neecrobot/smallbot/SmallBot_P01.pdf

# ロボットプログラミング

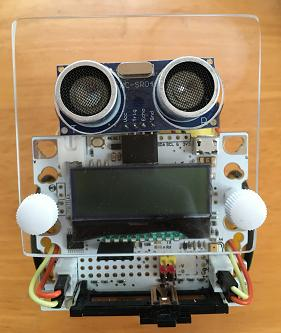
[picture p1: figure]

## SmallBotを動かそう

# SmallBotについて

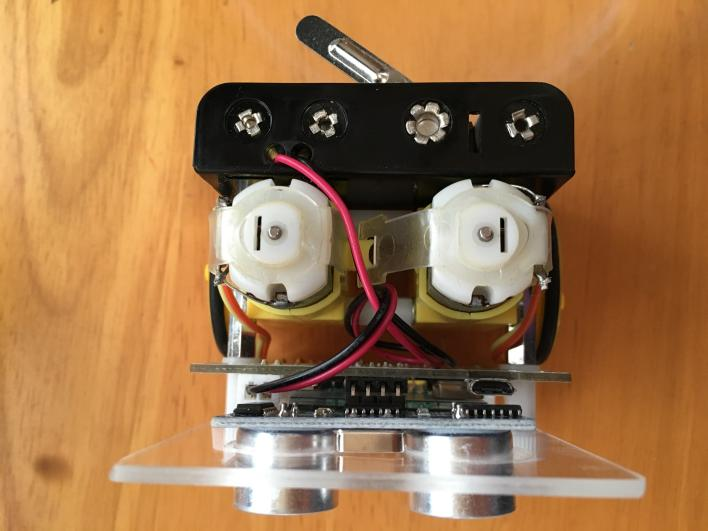
[picture p2: figure]

## マニュアルやプログラム類は githubに置いてあります

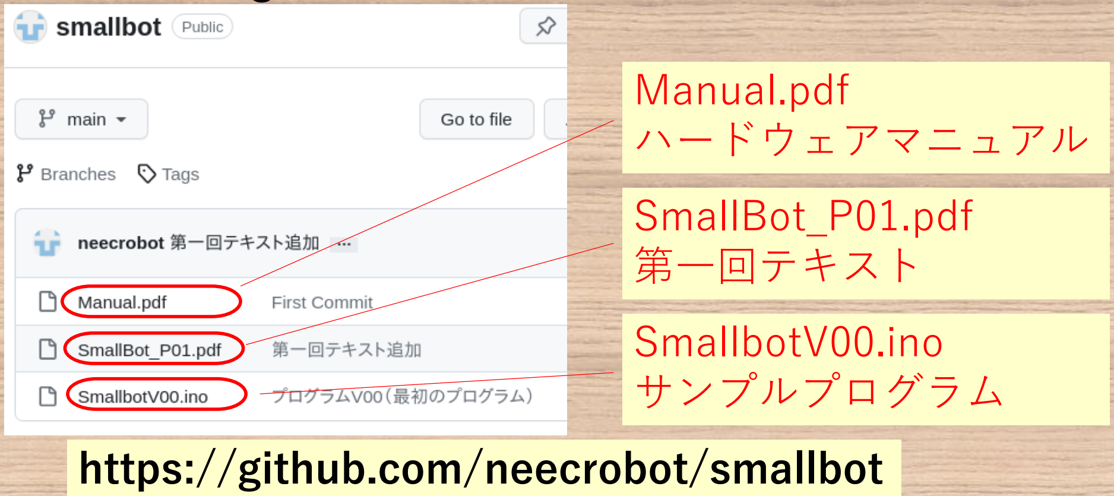
[picture p3: figure]
https://github.com/neecrobot/smallbot; Manual.pdf ハードウェアマニュアル; SmallBot_P01.pdf 第一回テキスト; SmallbotV00.ino サンプルプログラム

# SmallBotの主要部品配置

## 超音波距離センサ

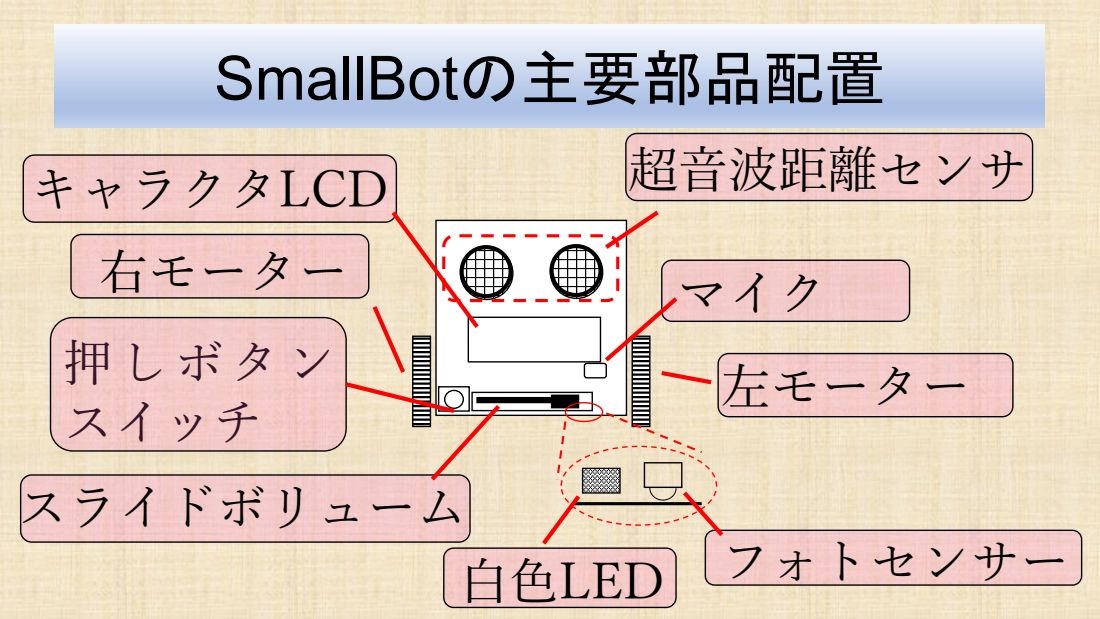
[picture p4: page 4]
フォトセンサー; 右モーター; 左モーター; マイク; スライドボリューム; 押しボタン スイッチ; 白色LED; キャラクタLCD

# 入力信号の接続（参考）

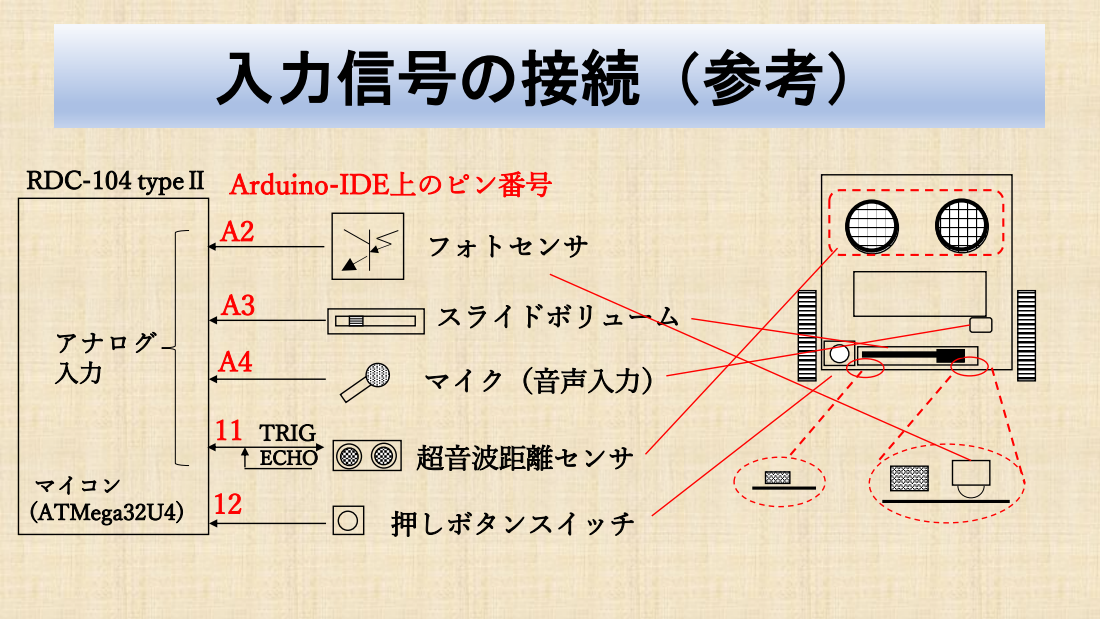
[picture p5: page 5]
フォトセンサ; RDC-104 typeⅡ; スライドボリューム; アナログ; マイク（音声入力）; 超音波距離センサ; 押しボタンスイッチ; マイコン (ATMega32U4); Arduino-IDE上のピン番号; TRIG ECHO

# 出力信号の接続（参考）

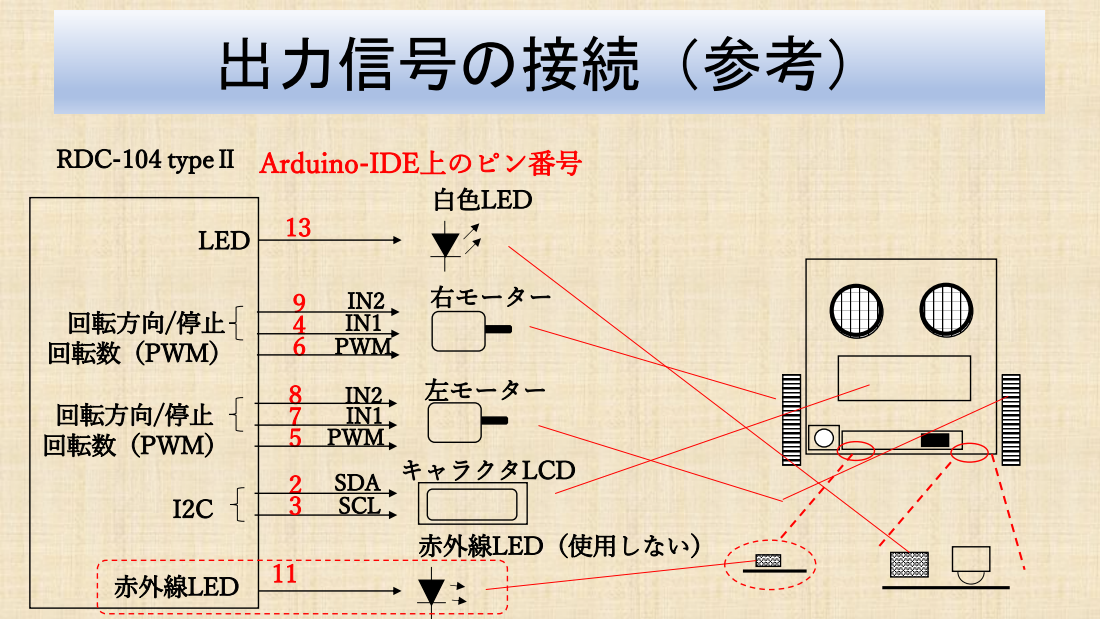
[picture p6: page 6]
回転数（PWM）; 回転方向/停止; 左モーター; SDA SCL; PWM; キャラクタLCD; 右モーター; 白色LED; LED; 赤外線LED（使用しない）; 赤外線LED

RDC-104 typeⅡ Arduino-IDE上のピン番号

### SmallBot搭載マイコン用(RDC-104)の開発環境

## インストール

### SmallBot搭載マイコン用(RDC-104)の開発環境

## インストール

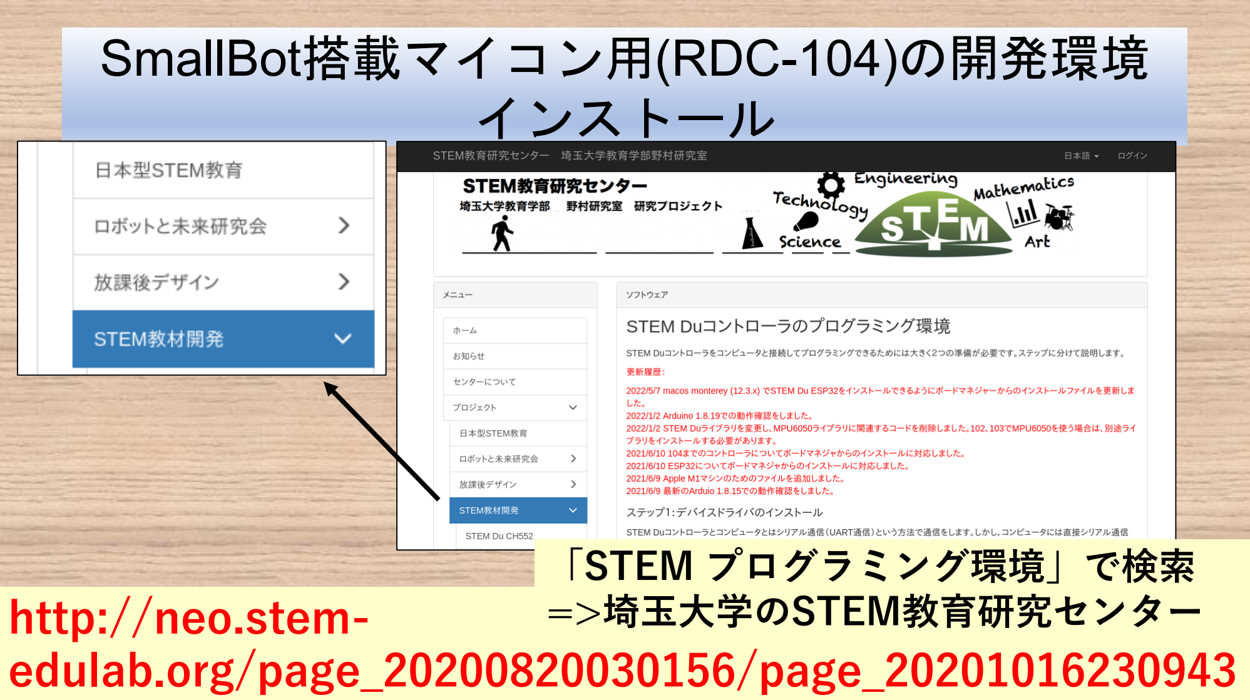
[picture p7: page 8]

http://neo.stem-edulab.org/page_20200820030156/page_20201016230943

「STEM プログラミング環境」で検索
=>埼玉大学のSTEM教育研究センター

# Arduino 1.8.19をインストール

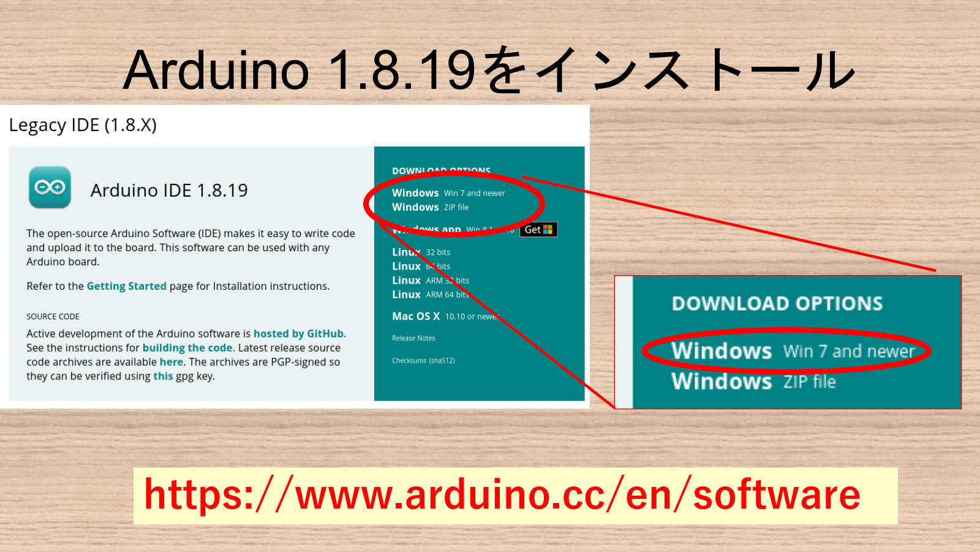
[picture p8: page 9]

## https://www.arduino.cc/en/software

# Arduino IDEの起動

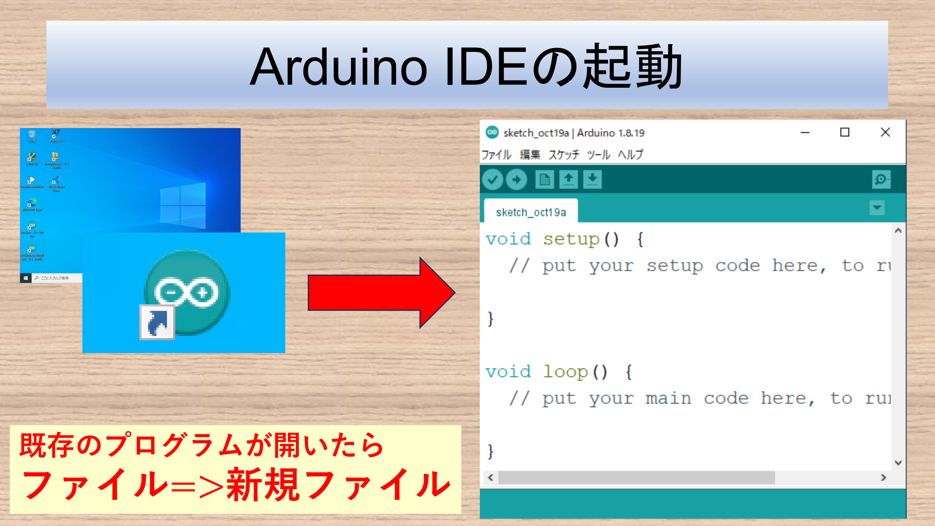
[picture p9: page 10]

既存のプログラムが開いたら

## ファイル=>新規ファイル

# ボードマネージャのURLをコピー

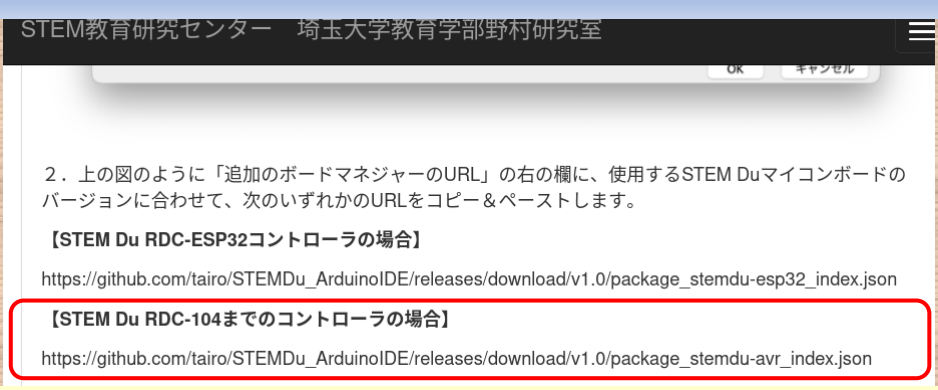
[picture p10: figure]

https://github.com/tairo/STEMDu_ArduinoIDE/releases/download/v1.0/package_stemdu-avr_index.json

# ボード（RDC-104）の追加

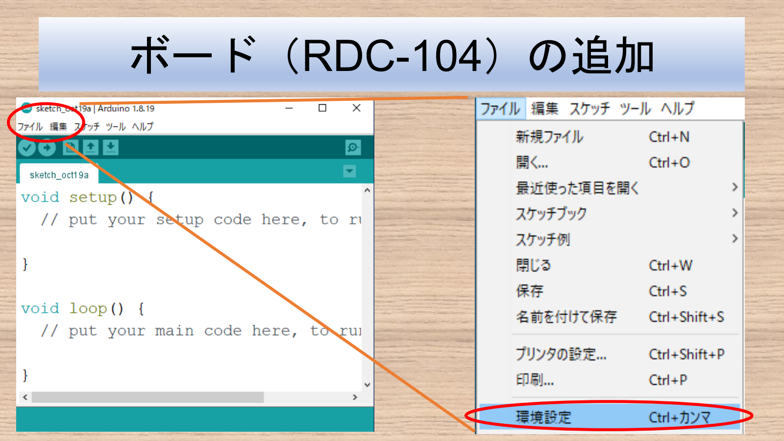
[picture p11: page 12]

# ボードマネージャのURL追加

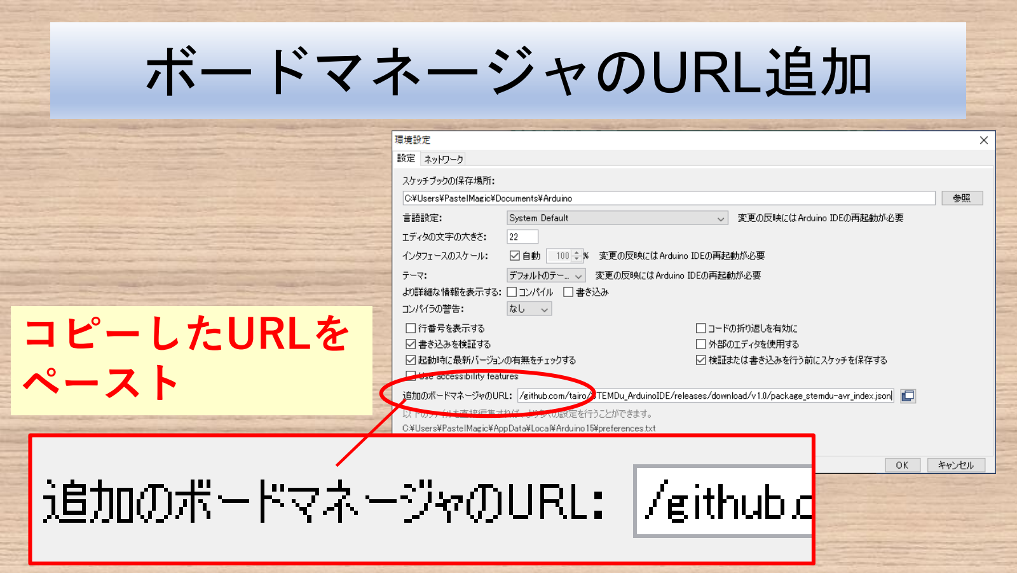
[picture p12: page 13]

## コピーしたURLを ペースト

# ボードマネージャを起動

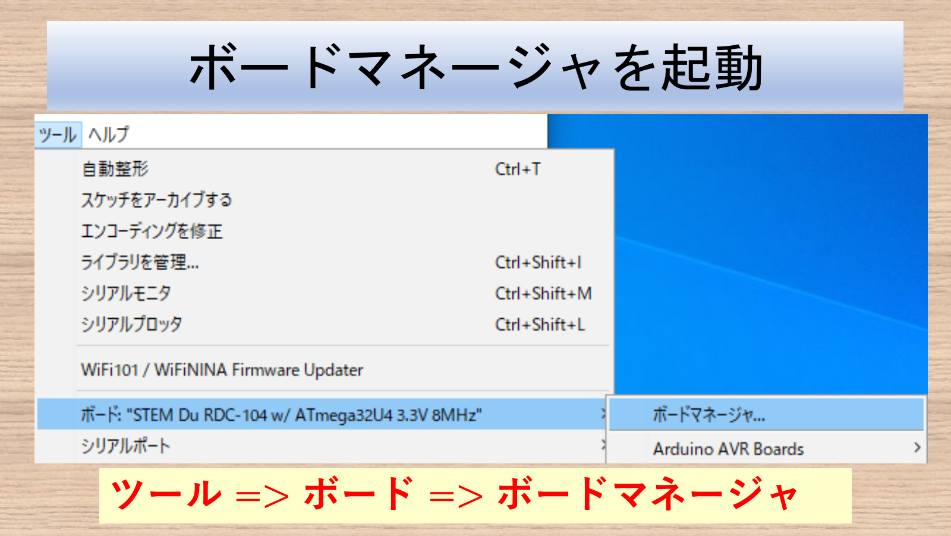
[picture p13: page 14]

## ツール => ボード => ボードマネージャ

# STEM Du AVRをインストール

## ”STEM"で検索

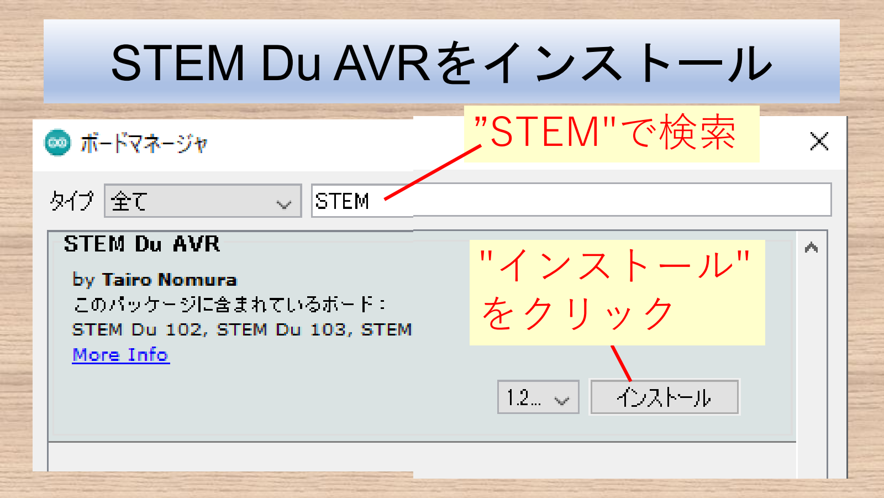
[picture p14: page 15]

## "インストール" をクリック

# 書き込んで動かすまでの手順

# PCと接続

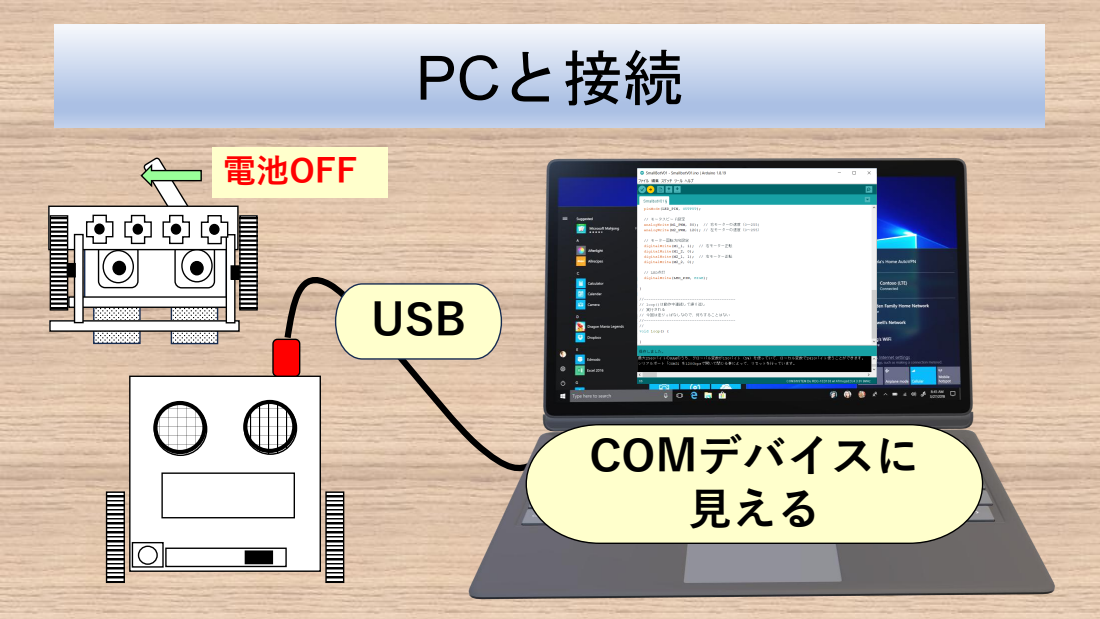
[picture p15: page 17]
USB; COMデバイスに 見える; 電池OFF

# USB電源で動いてしまう時

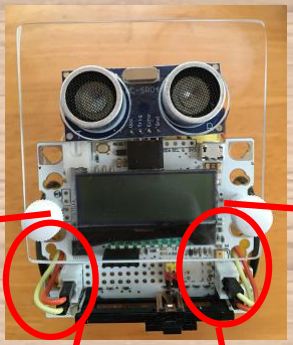
[picture p16: figure]

赤か黄色のどちらかを抜く

# Arduino IDEの起動

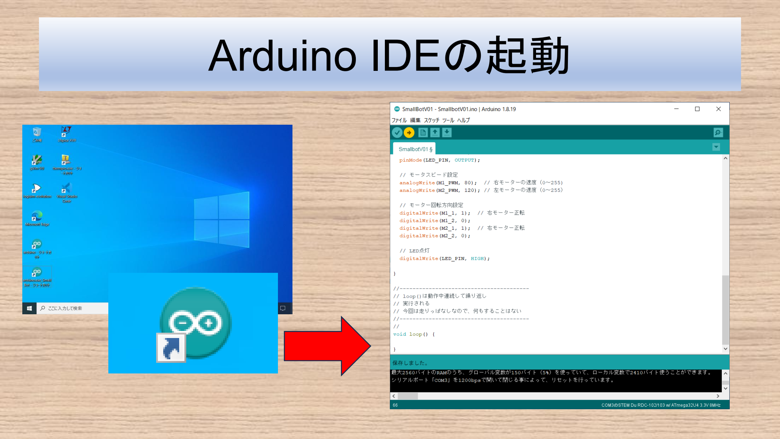
[picture p17: page 19]

# ターゲットの選択

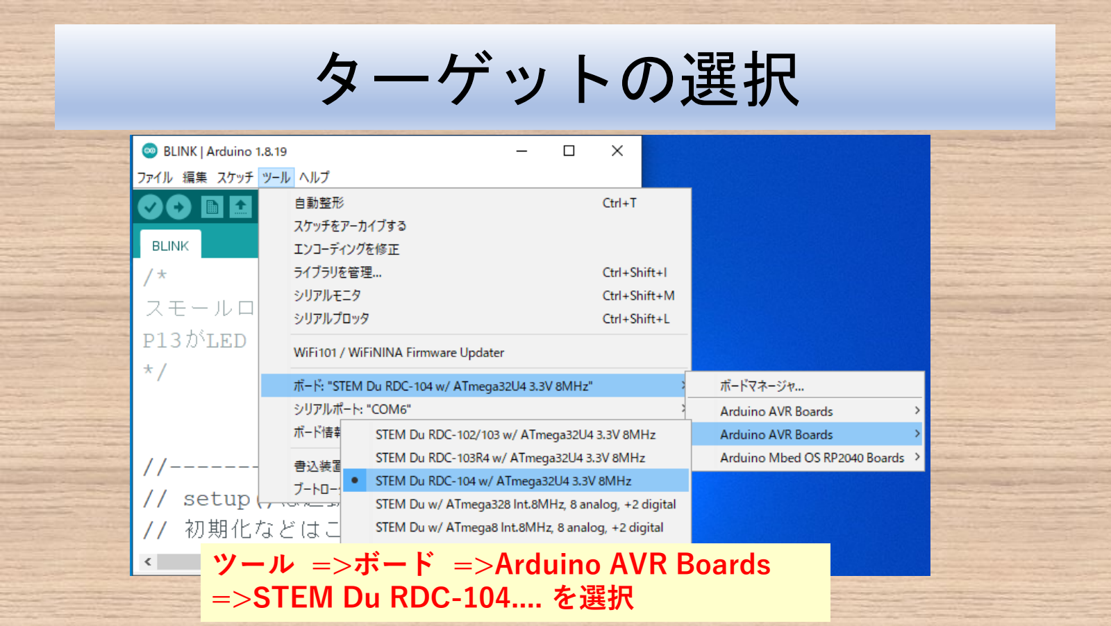
[picture p18: page 20]

ツール =>ボード =>Arduino AVR Boards =>STEM Du RDC-104.... を選択

# COM（シリアル）ポートの選択

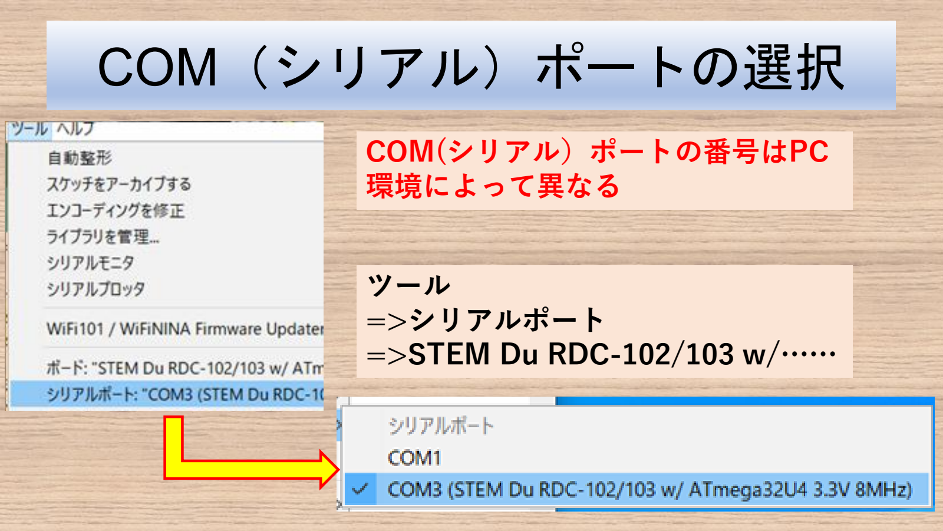
[picture p19: page 21]

ツール
=>シリアルポート
=>STEM Du RDC-102/103 w/……

COM(シリアル）ポートの番号はPC
環境によって異なる

## プログラムの記述

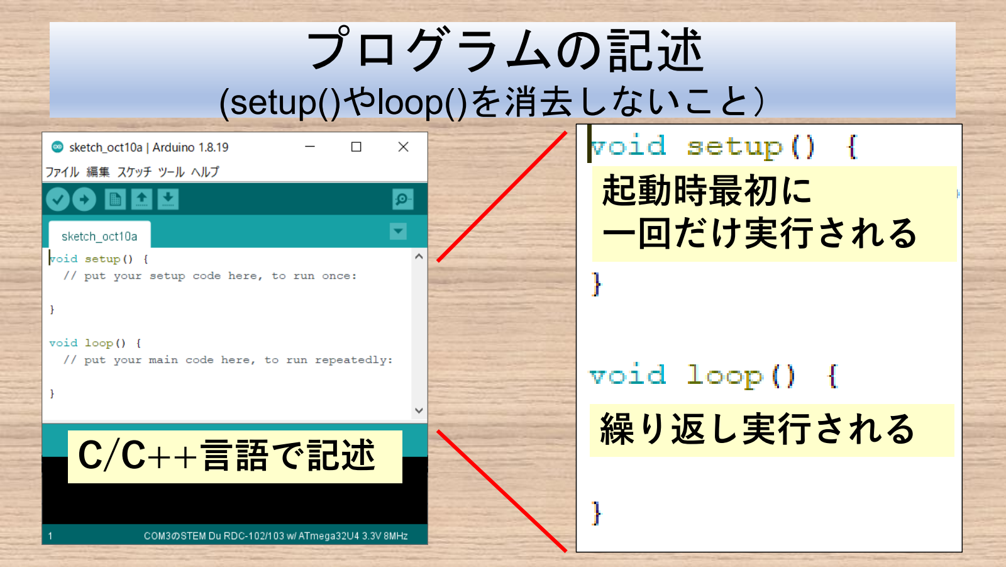
[picture p20: page 22]

(setup()やloop()を消去しないこと）

起動時最初に
一回だけ実行される

繰り返し実行される C/C++言語で記述

# とりあえずLED点滅

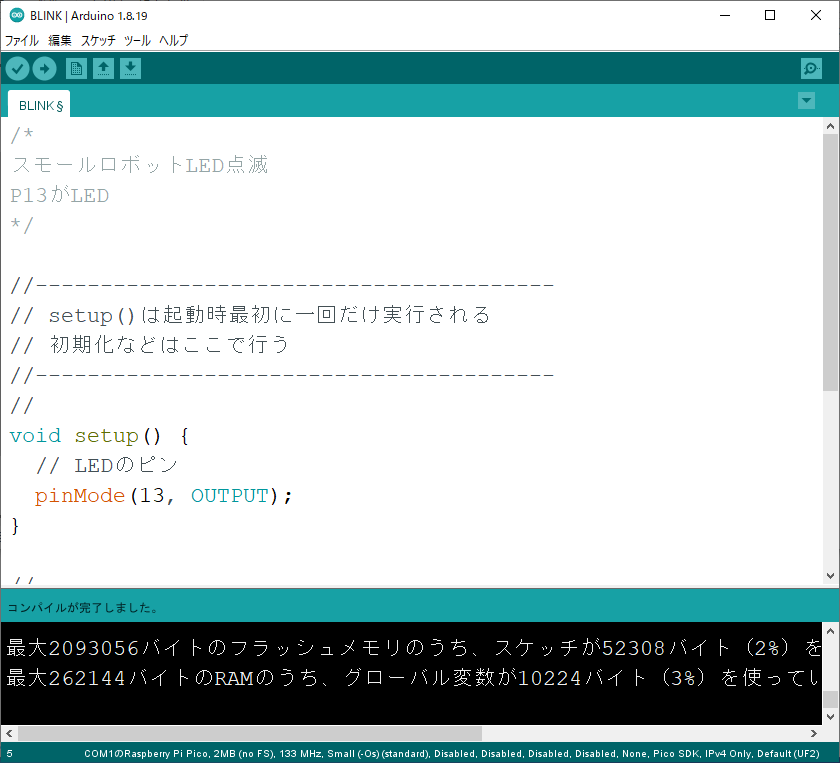
[picture p21: figure]

void setup() {
pinMode(13, OUTPUT);
}

void loop() {
digitalWrite(13,1); // ON
delay(500); // 500msウェイト
digitalWrite(13,0); // OFF delay(500); // 500msウェイト
}

プログラム本体はすべて半角文字（スペースも半角！）

"//"以下はコメント
（入力不要）

# ビルド＆書き込み＆実行

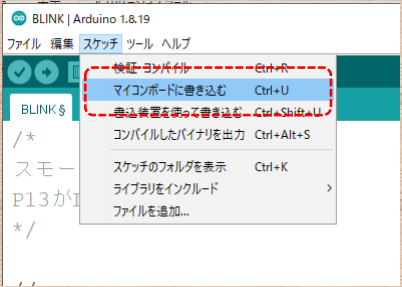
[picture p22: figure]

### 接続したSmallBotに

## 書き込みを行う

## ビルドも自動的に行 われる

# 書き込み実行

## ビルド中

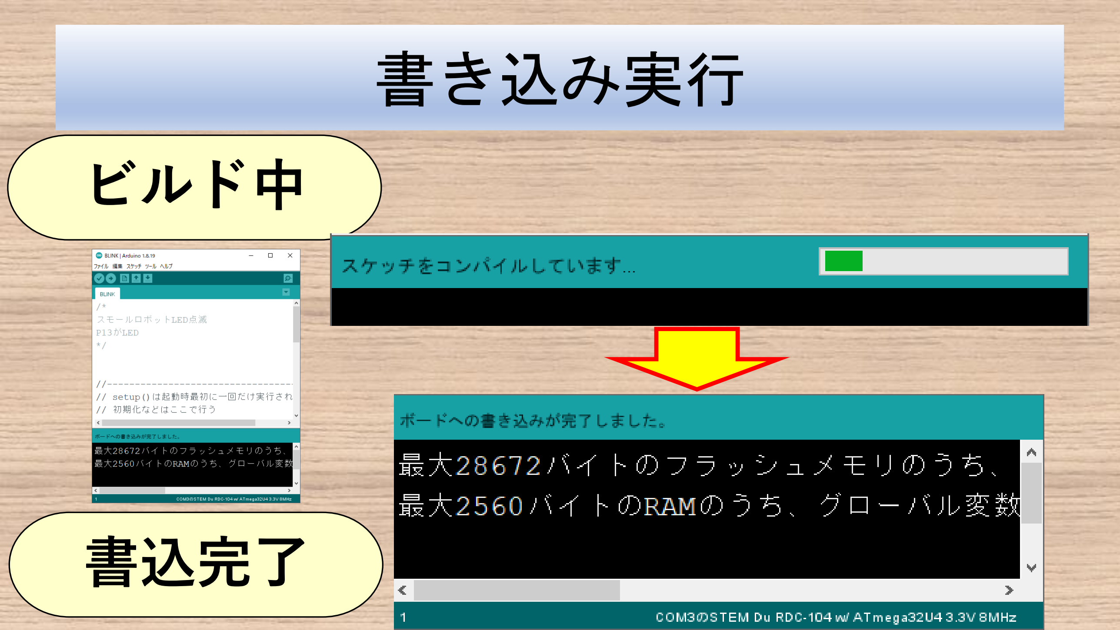
[picture p23: page 25]

## 書込完了

# 電池から電源を供給

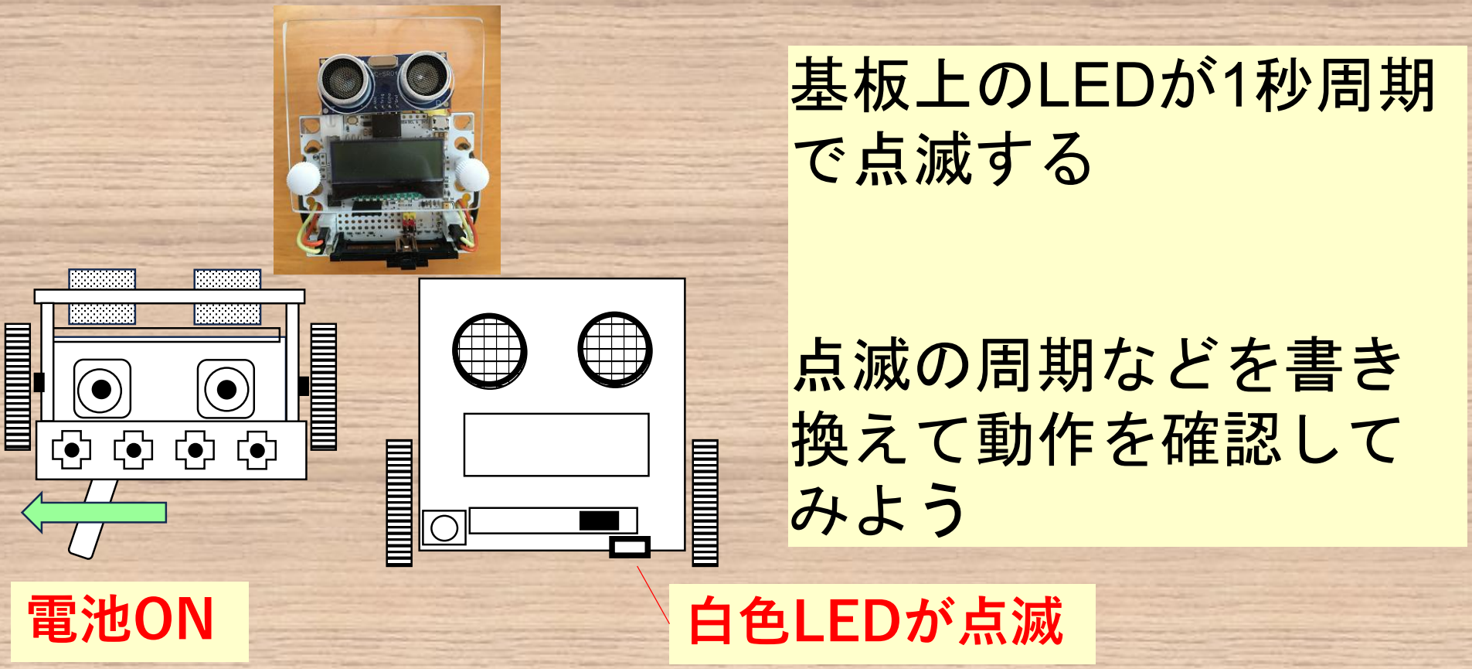
[picture p24: figure]
基板上のLEDが1秒周期 で点滅する; 点滅の周期などを書き 換えて動作を確認して みよう; 電池ON; 白色LEDが点滅

# モーターを動かそう

# 最初のロボットプログラム(V00.ino)

(setup()の中に記述）
void setup() {
// モータ関係の出力ピン
pinMode(4, OUTPUT);
pinMode(9, OUTPUT);
pinMode(6, OUTPUT);
pinMode(7, OUTPUT);
pinMode(8, OUTPUT);
pinMode(5, OUTPUT);
// デジタル出力ピン（LED)
pinMode(13, OUTPUT);

// 右モーターの速度（0～255)
analogWrite(6, 80);
// 左モーターの速度（0～255）
analogWrite(5, 120);
// 右モーター正転
digitalWrite(4, 1);
digitalWrite(9, 0);
// 左モーター正転
digitalWrite(7, 1);
digitalWrite(8, 0);
}

速度 80

速度 120

プログラム本体はすべて半角文字（スペースも半角！）

# ビルド＆書き込み＆実行

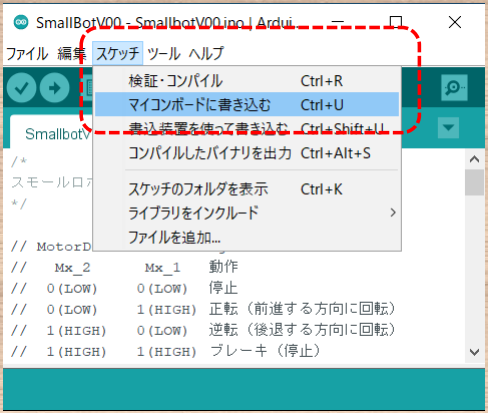
[picture p25: figure]

### 接続したSmallBotに書

## き込みを行う

## ビルドも自動的に行わ

れる

# 書き込み実行

## ビルド中

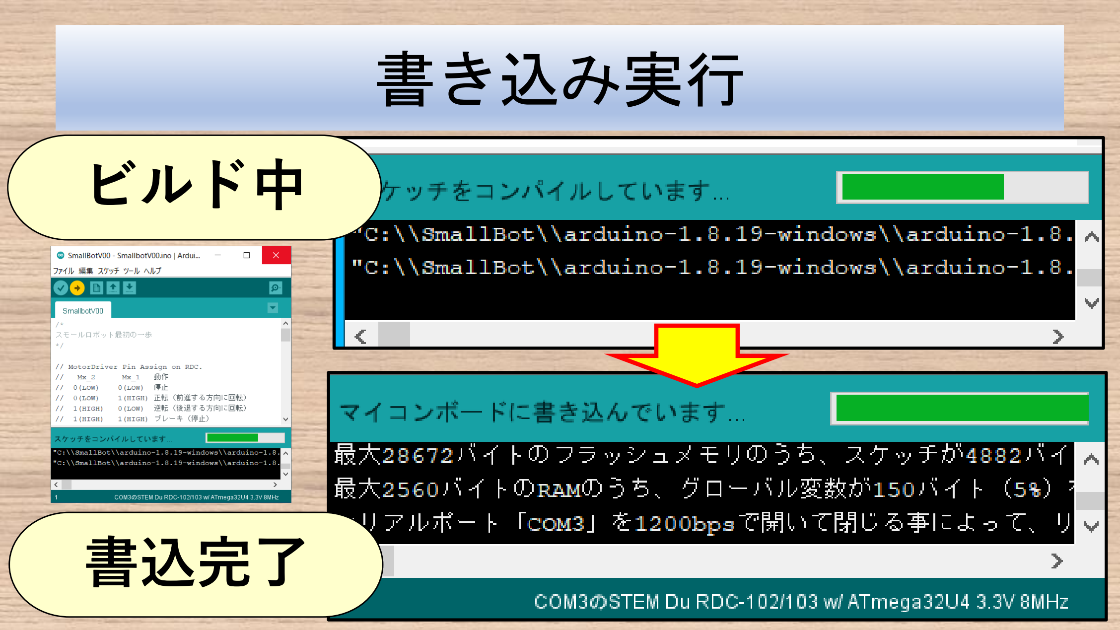
[picture p26: page 30]

## 書込完了

# 時計回りに回転する

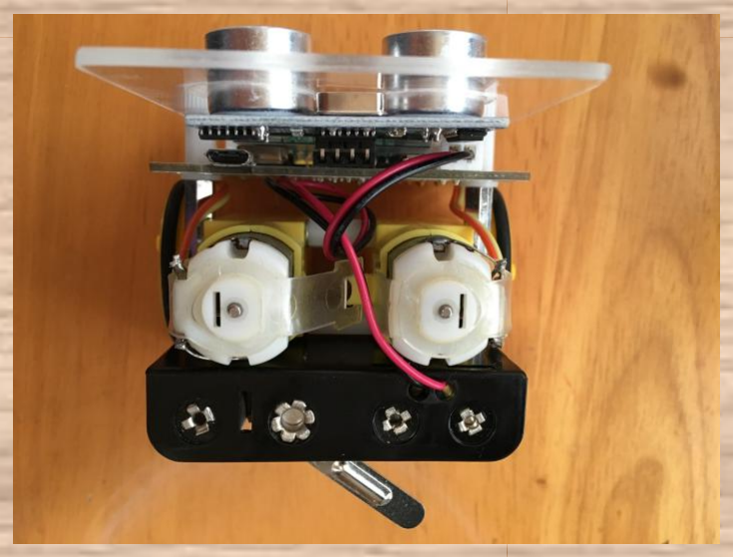
[picture p27: figure]
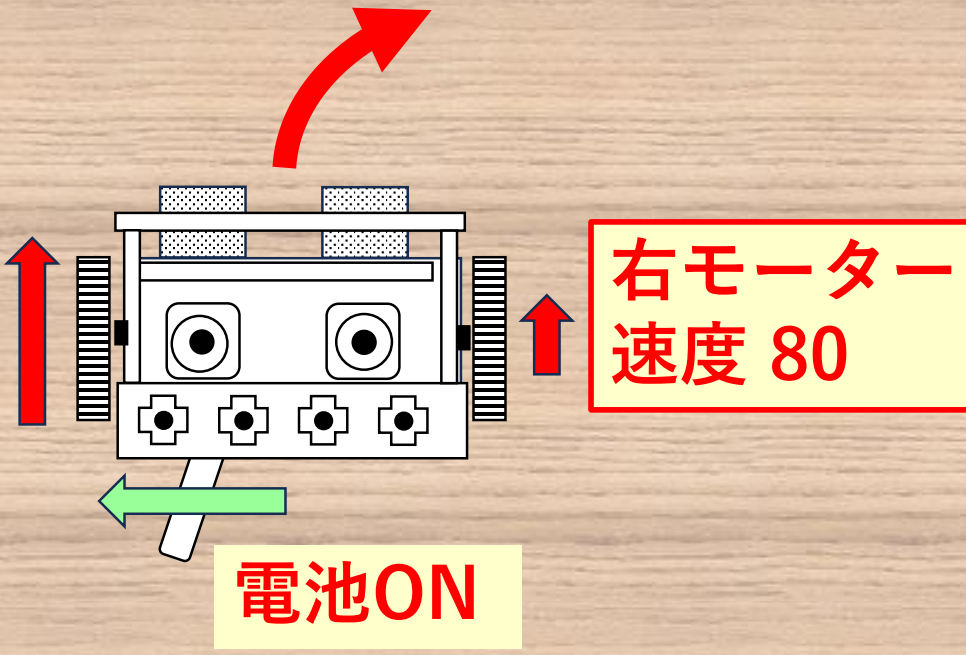
[picture p28: figure]
電池ON; 右モーター 速度 80

左モーター
速度 120

練習

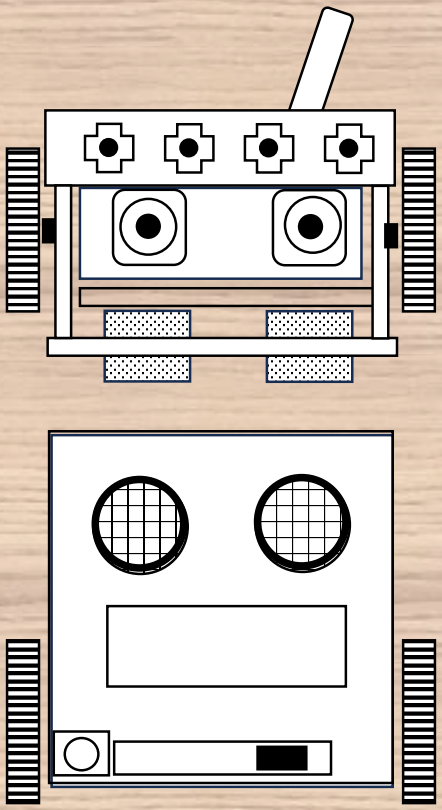
[picture p29: figure]

プログラムを書き換えて
いろいろな動きをさせてみよう

## モーターを逆回転等させてみよう

（00:停止 11: ブレーキ)
void setup() {
// モータ関係の出力ピン
pinMode(4, OUTPUT);
pinMode(9, OUTPUT);
pinMode(6, OUTPUT);
pinMode(7, OUTPUT);
pinMode(8, OUTPUT);
pinMode(5, OUTPUT);
// デジタル出力ピン（LED)
pinMode(13, OUTPUT);

// 右モーターの速度（0～255)
analogWrite(6, 80);
// 左モーターの速度（0～255）
analogWrite(5, 120);
// 右モーター逆転
digitalWrite(4, 0);
digitalWrite(9, 1);
// 左モーター逆転
digitalWrite(7, 0);
digitalWrite(8, 1);
}
プログラム本体はすべて半角文字（スペースも半角！）

旋回

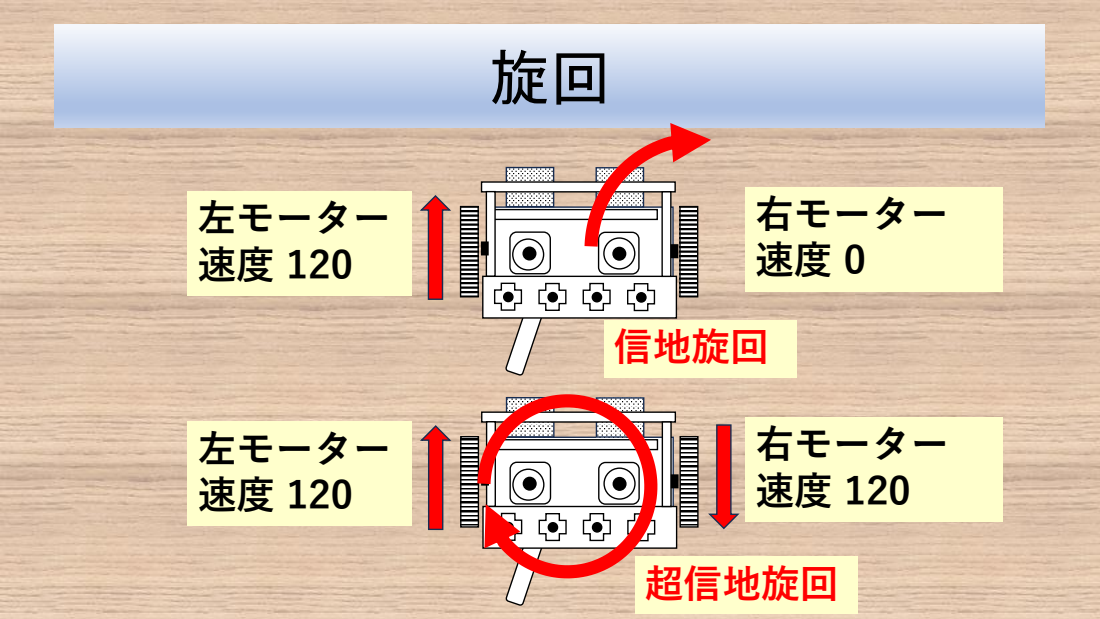
[picture p30: page 34]
右モーター 速度 0; 左モーター 速度 120; 右モーター 速度 120; 信地旋回; 超信地旋回

# いろいろな動きをさせてみよう

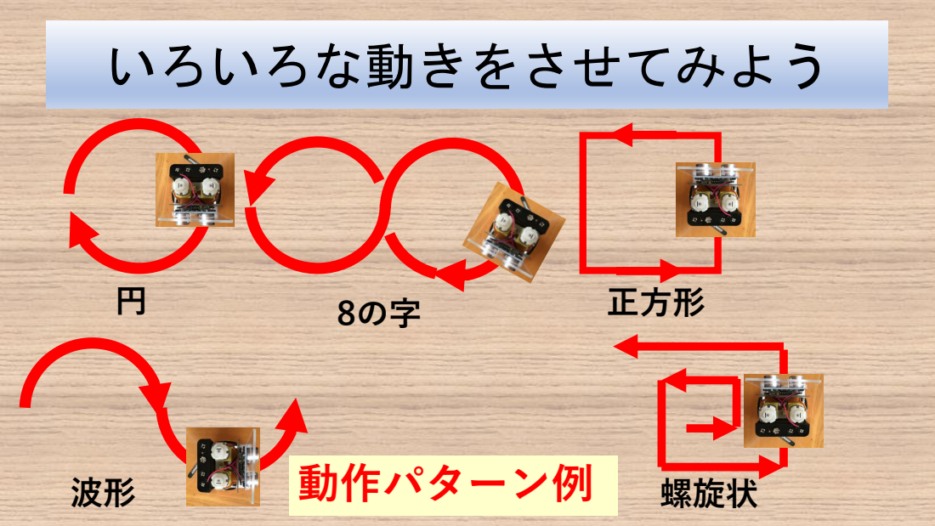
[picture p31: page 35]
正方形; 動作パターン例; 螺旋状

# プログラム（ライブラリ）について

# ライブラリ関数の呼び出し

void setup() {
// モータ関係の出力ピン
pinMode(4, OUTPUT);
pinMode(9, OUTPUT);
pinMode(6, OUTPUT);

pinMode(7, OUTPUT);
pinMode(8, OUTPUT);
pinMode(5, OUTPUT);

// デジタル出力ピン（LED)
pinMode(13, OUTPUT);

// 右モーターの速度（0～255)
analogWrite(6, 80);
// 左モーターの速度（0～255）
analogWrite(5, 120);
// 右モーター正転
digitalWrite(4, 1);
digitalWrite(9, 0);
// 左モーター正転
digitalWrite(7, 1);
digitalWrite(8, 0);
}

# ライブラリ関数などの説明

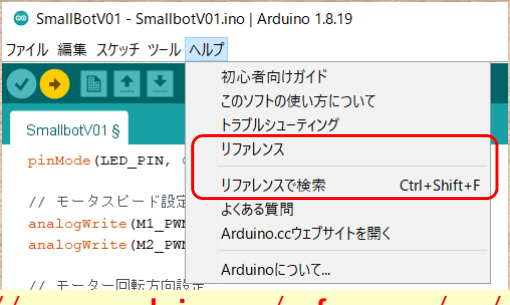
[picture p32: figure]

## https://www.arduino.cc/reference/en/ が開く

# 日本語の説明ページ例

## http://www.musashinodenpa.com/arduino/ ref/index.php

など

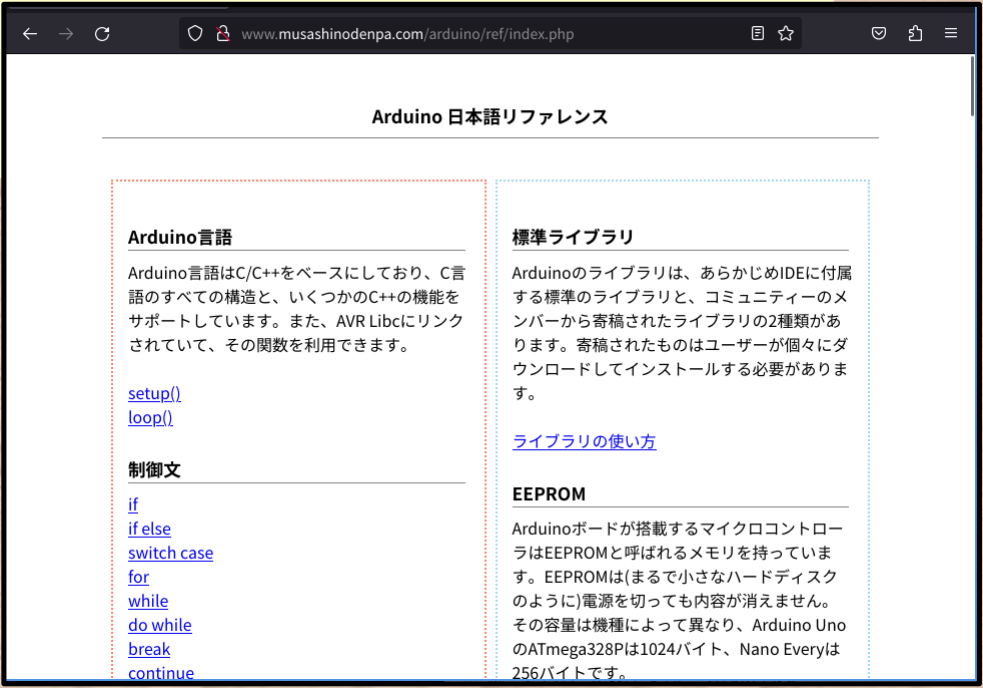
[picture p33: figure]

［arduino リファレンス]
で検索してみると良い

※：公式なものではない
（間違っている可能性も）

# 翻訳機能を活用しても良い

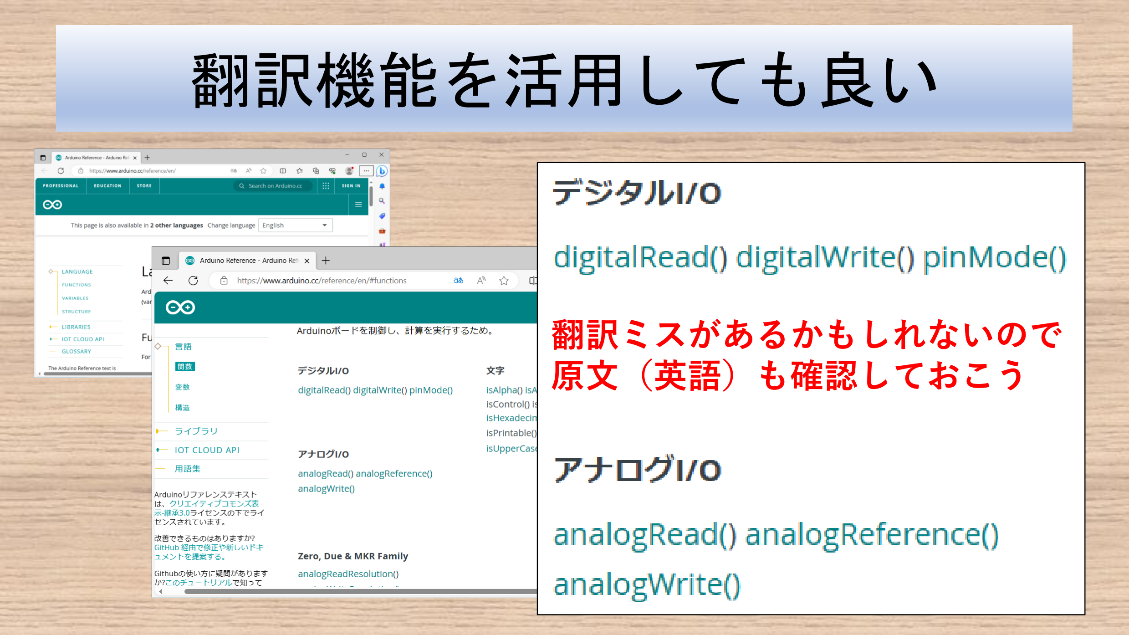
[picture p34: page 40]

翻訳ミスがあるかもしれないので
原文（英語）も確認しておこう

# ライブラリ：まずはここから

pinMode(pin,mode);
ピン（端子）のモード設定

digitalWrite(pin, value);
デジタルピンの出力設定

digitalRead(pin);
デジタルピンの読込み

analogWrite(pin,value);
アナログピンの出力設定
analogRead(pin);
アナログルピンの読込み

delay(ms);
指定した時間ウェイト
（1/1000秒：ミリ秒単位）

delayMicroseconds(us);
指定した時間ウェイト（μ秒単位）

pulseIn(pin, value);
パルス幅計測(μ秒単位）

pinMode(pin, mode);

## ピン（端子）のモード設定

pin：ピン（端子）番号
mode：動作モード
・INPUT
入力
・OUTPUT
出力
・INPUT_PULLUP
入力(無接続時にはHIGH)

記述例：
pinMode(4, OUTPUT);
pinMode(11, INPUT);
pinMode(12, INPUT_PULLUP);

pinMode()で設定しないとき
（デフォルト）は
INPUTになっている

digitalWrite(pin, value);

## デジタルデータ（HIGH/LOW）出力

・pin:ピン(端子)番号
・value：出力値
・0または1

例：
// 右モーター正転
digitalWrite(4, 1);
digitalWrite(9, 0);
delay(1000);
// 右モーター逆転
digitalWrite(4, 0);
digitalWrite(9, 1);
// LED点灯
digitalWrite(13, 1);

pinMode(xxx,OUTPUT);
で出力設定したピン(端子)の状態設定

0: LOW 電圧が低い ( 0V) 状態
1: HIGH 電圧が高い (3.3V) 状態

digitalRead(pin);

## デジタルデータ（HIGH/LOW）入力

・pin: ピン（端子）番号 例： int swval; swval=digitalRead(12); if (swval == 0) { digitalWrite(13, 1); } else { digitalWrite(13, 0); }

pinMode(xxx,INPUT);
で出力設定したピン(端子)の状
態読込み

0: LOW 電圧が低い(0V) 状態
1: HIGH 電圧が高い(3.3V) 状態

analogWrite(pin, value);

## PWM(パルス幅変調)出力

・pin: ピン（端子）番号
・value: 出力パルス幅
設定値: 0～255

例：
pinMode(6, OUTPUT);
// 出力幅のHigh比率は120/255
analogWrite(6, 120);
pinMode(xxx,INPUT);
で出力設定したピン(端子)の
1（HIGH)パルス幅比率を256
段階で設定

## analogWrite()による出力変化と

## モーターの回転

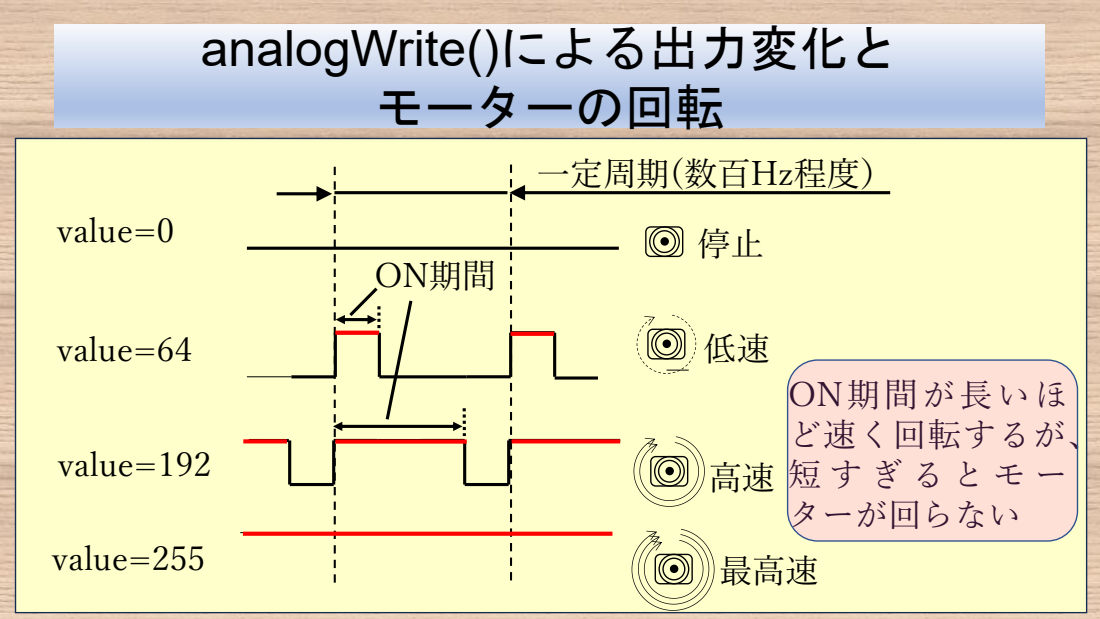
[picture p35: page 46]
value=64; ON期間; 一定周期(数百Hz程度）; value=0; 最高速; ON期間が長いほ ど速く回転するが、 短 す ぎ る と モ ー ターが回らない; value=192; value=255

analogRead(pin);

## ピン（端子）の電圧を読み込み

・pin: ピン（端子）番号 例： sliderValue = analogRead(A3); if (analogRead(A2) > 200) { ・・・ }

pinMode(xxx,INPUT);
で出力設定したピンの電圧
(0～3.3V)を デジタル値で返す
戻り値の範囲は0～1023
端子電圧=3.3÷1024×戻り値

スライダの位置や、光センサ（フォトセンサ）による
明るさの判断などに利用している

delay(ms);

## 1m秒単位でウェイト（動作停止）

・ms: ウェイトする時間
(単位はm秒）

例：
digitalWrite(13,1); // LED ON delay(500); // 500msウェイト
digitalWrite(13,0); // LED OFF delay(500); // 500msウェイト pulseIn(pin, value, (Timeout));

## パルス幅計測(μ秒単位）

・pin: ピン（端子）番号
・value: 1 (HIGH)または
0 (LOW)
・Timeout:タイムアウト
μ秒単位で指定(省略可)

例:
pinMode(11, INPUT);

duration=pulseIn(11, HIGH);

・value
1: 入力が0から1になった
後、0に戻るまでの時間
0: 入力が1から0になった
後、1に戻るまでの時間

delayMicroseconds(us);

## 指定した時間ウェイト（μ秒単位）

## ・us: ウェイトする時間 (μ秒単位）

例：

## // 2μ秒ウェイト

delayMicroseconds(2);

### // 1000μ秒(=1m秒）

## // ウェイト

delayMicroseconds(1000);
