neecrobot/smallbot/SmallBot_P02.pdf

# ロボットプログラミング#2


## SmallBotを動かそう

・前回の復習
・マクロ(#define)の利用
・ライントレースさせてみよう

## マニュアルやプログラム類は githubに置いてあります

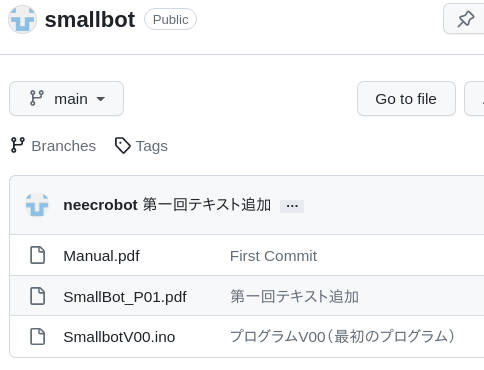
[picture p36: figure]

https://github.com/neecrobot/smallbot

置いてあるファイル
はクリックして
ダウンロード可

# SmallBotについて


# SmallBotの主要部品配置

## 超音波距離センサ

フォトセンサー; 右モーター; 左モーター; マイク; スライドボリューム; 押しボタン スイッチ; 白色LED; キャラクタLCD

# 出力信号の接続（参考）

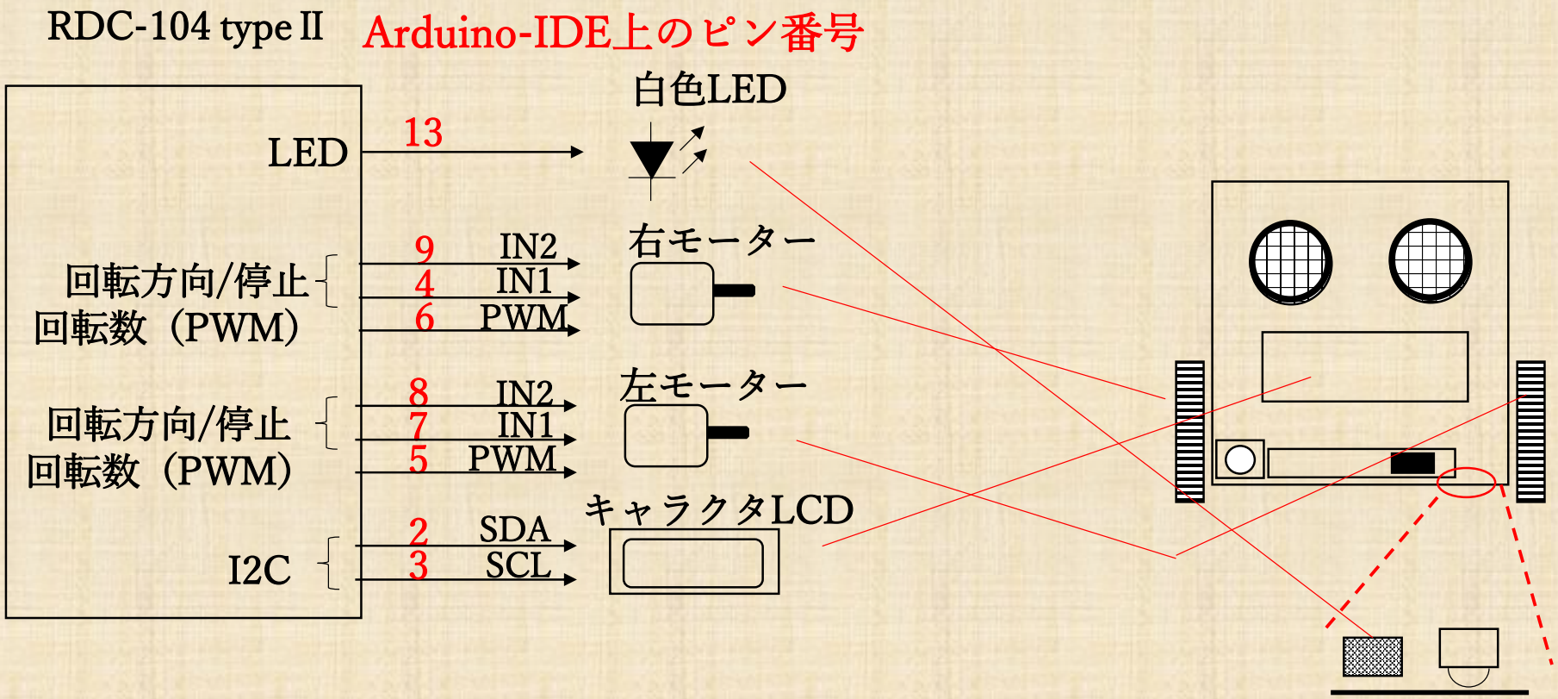
[picture p37: figure]
回転数（PWM）; 回転方向/停止; 左モーター; SDA SCL; PWM; キャラクタLCD; 右モーター; 白色LED; LED; RDC-104 typeⅡ Arduino-IDE上のピン番号

# 入力信号の接続（参考）

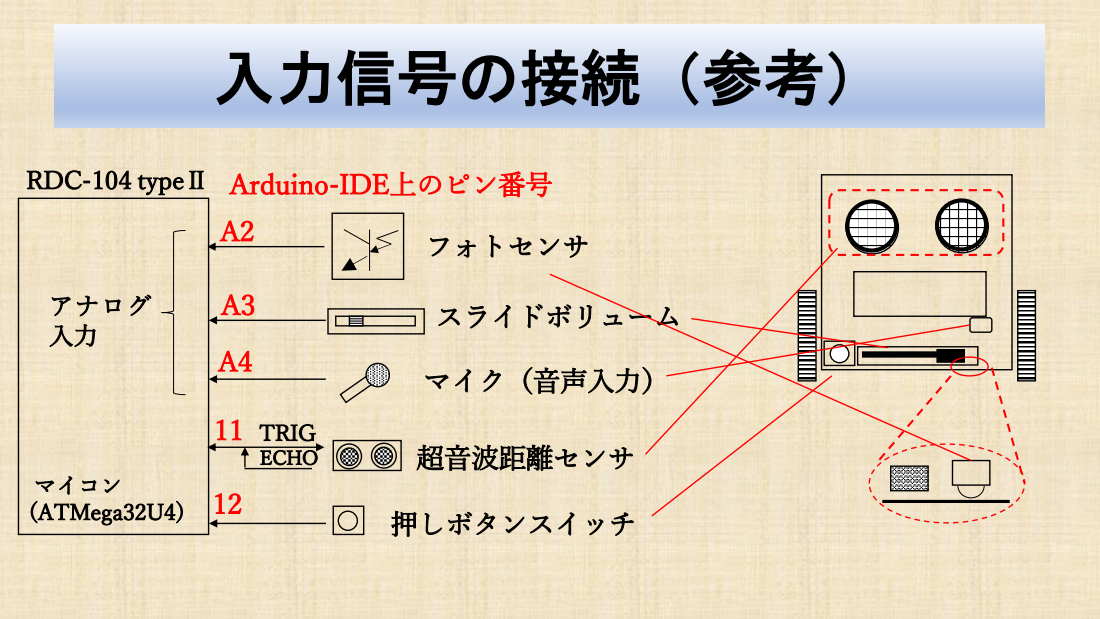
[picture p38: page 6]
フォトセンサ; RDC-104 typeⅡ; アナログ; スライドボリューム 入力; マイク（音声入力）; 超音波距離センサ; 押しボタンスイッチ; マイコン (ATMega32U4); Arduino-IDE上のピン番号; TRIG ECHO

## 書き込んで動かすまでの手順 のおさらい

# PCと接続

USB; COMデバイスに 見える; 電池OFF

# Arduino IDEの起動


# ターゲットの選択


ツール =>ボード =>Arduino AVR Boards =>STEM Du RDC-104.... を選択

# COM（シリアル）ポートの選択


ツール
=>シリアルポート
=>STEM Du RDC-102/103 w/……

COM(シリアル）ポートの番号はPC
環境によって異なる

# プログラムの記述

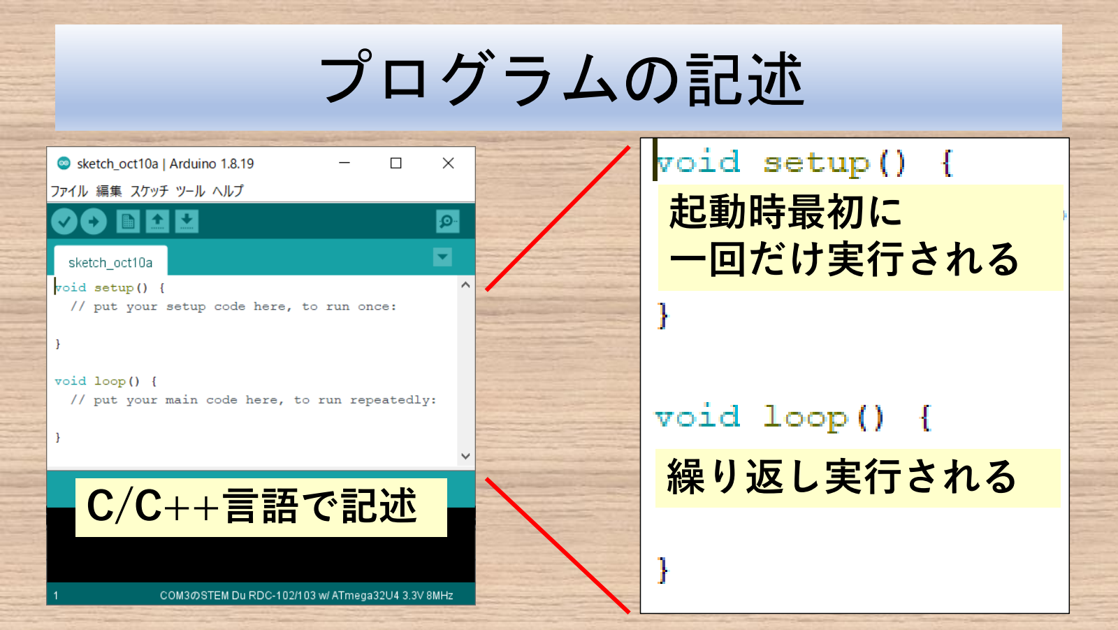
[picture p39: page 12]

起動時最初に
一回だけ実行される

繰り返し実行される C/C++言語で記述

# モーターを動かそう

## モータ駆動サンプル

## （SmallbotV00.ino)

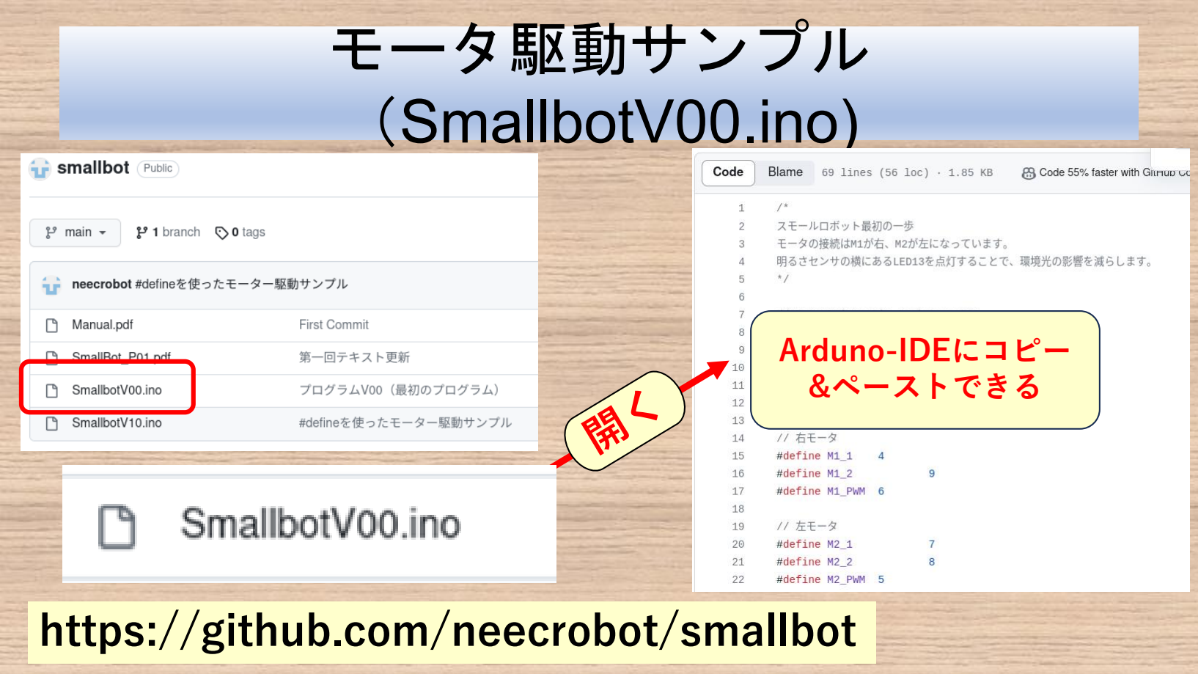
[picture p40: page 14]

https://github.com/neecrobot/smallbot

Arduno-IDEにコピー
&ペーストできる

# ビルド＆書き込み＆実行


### 接続したSmallBotに書

## き込みを行う

## ビルドも自動的に行わ

れる

# 書き込み実行

## ビルド中


## 書込完了

# 時計回りに回転する

電池ON; 右モーター 速度 80

左モーター
速度 120

## 文字列の置き換えマクロ

## （#define）の使い方

# #defineの動作

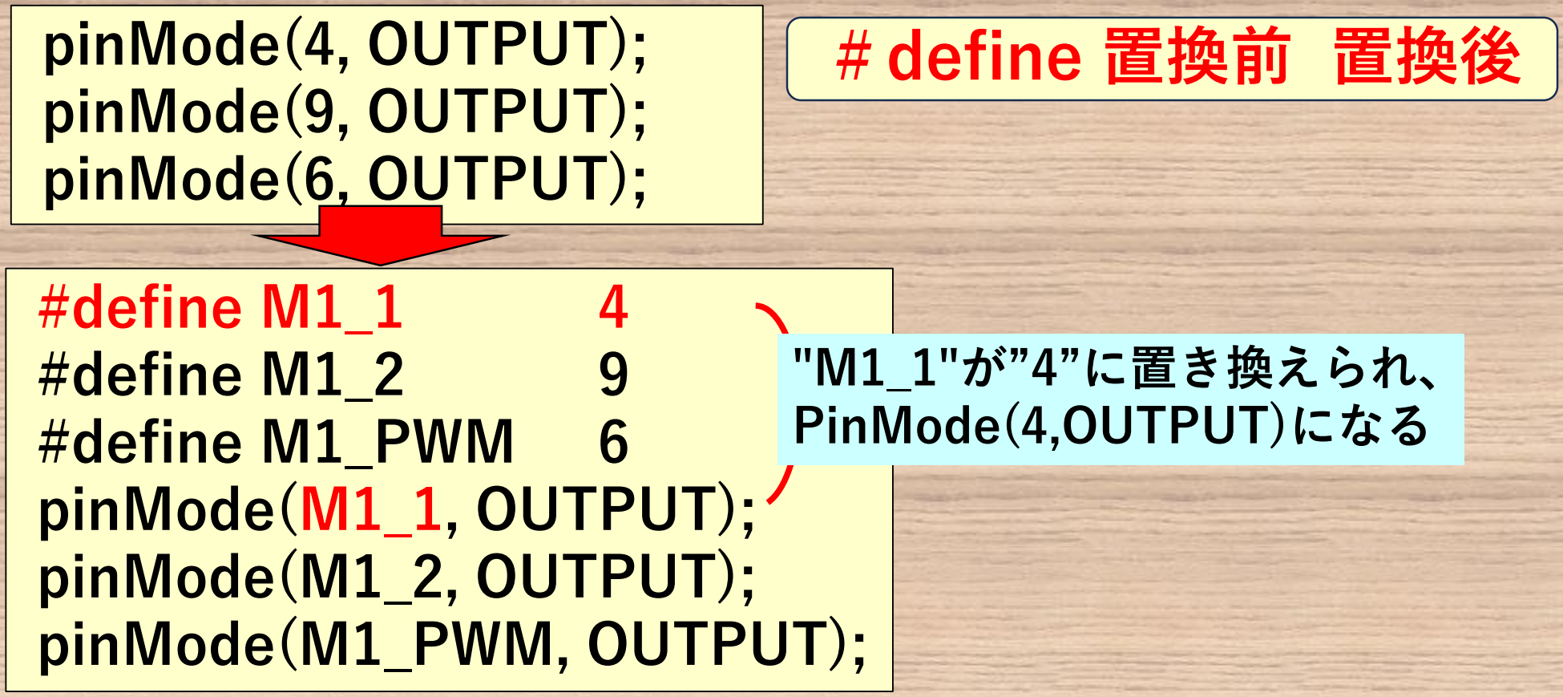
[picture p41: figure]
#define M1_1; #define M1_2; #define M1_PWM 6; #define M1_PWM; pinMode(M1_1, OUTPUT); pinMode(M1_2, OUTPUT); pinMode(M1_PWM, OUTPUT);; pinMode(4, OUTPUT); pinMode(9, OUTPUT); pinMode(6, OUTPUT);; ＃define 置換前 置換後; "M1_1"が”4”に置き換えられ、 PinMode(4,OUTPUT)になる

## #defineを使ったサンプル

### (SmallbotV10.ino)

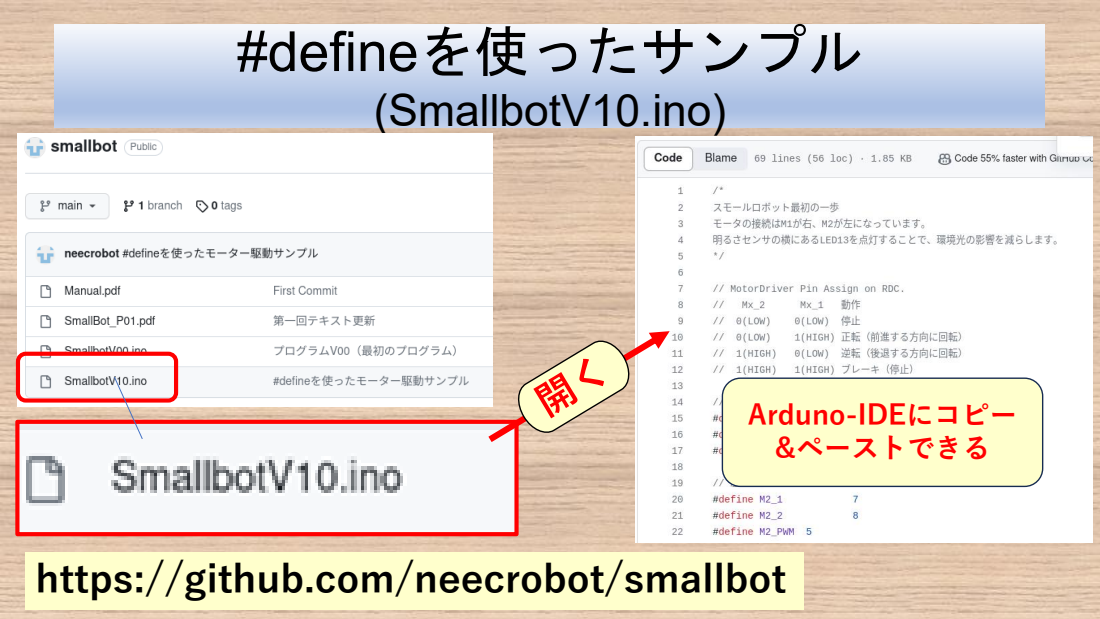
[picture p42: page 20]
Arduno-IDEにコピー &ペーストできる

https://github.com/neecrobot/smallbot

# コピー＆ペースして動かしてみよう

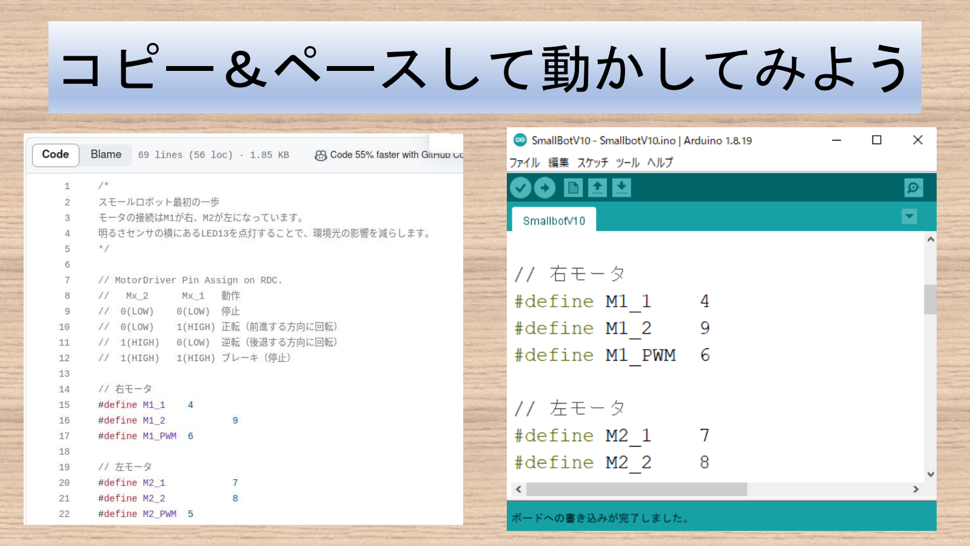
[picture p43: page 21]

# SmallBot用の定義例

#define M1_1 | 4 | // 右モータ回転方向

#define M1_2 | 9

#define M1_PWM | 6 | // 右モーター速度

#define M2_1 | 7 | // 左モータ回転方向

#define M2_2 | 8

#define M2_PWM | 5 | // 左モーター速度

#define PING_PIN | 11 | // 超音波測距センサ

#define BUTTON_PIN | 12 | // 押しボタンスイッチ

#define LED_PIN | 13 | // LED

#define PHOTO | A2 | // フォトセンサ

#define SLIDER | A3 | // スライダ

## C言語をちょっとだけ

# まずはこれだけ

## ・整数型変数（int型）

<宣言>
int data;
int data = 0; // 初期化あり

<代入>
data = 3;
data = data+4;

## ・条件判断と分岐

< if 文>
if (data == 3) {
条件成立時の処理
} else {
条件不成立時の処理
}
== | 等しい
!= | 等しくない
＞ | 左辺＞ 右辺
＞＝ | 左辺≧ 右辺
＜ | 左辺＜ 右辺
＜＝ | 左辺≦ 右辺

# if() ... else if()... else

if (data == 3) {
data = 2;
}
if (data == 2) {
data = 3;
}

=> 3の時も3になってしまう

if (data == 3) {
data = 2;
} else if (data == 2) {
data = 3;
} else {
data = 0;
}
3のときは | 2
2のときは | 3
それ以外なら 0

## 動かしてみよう

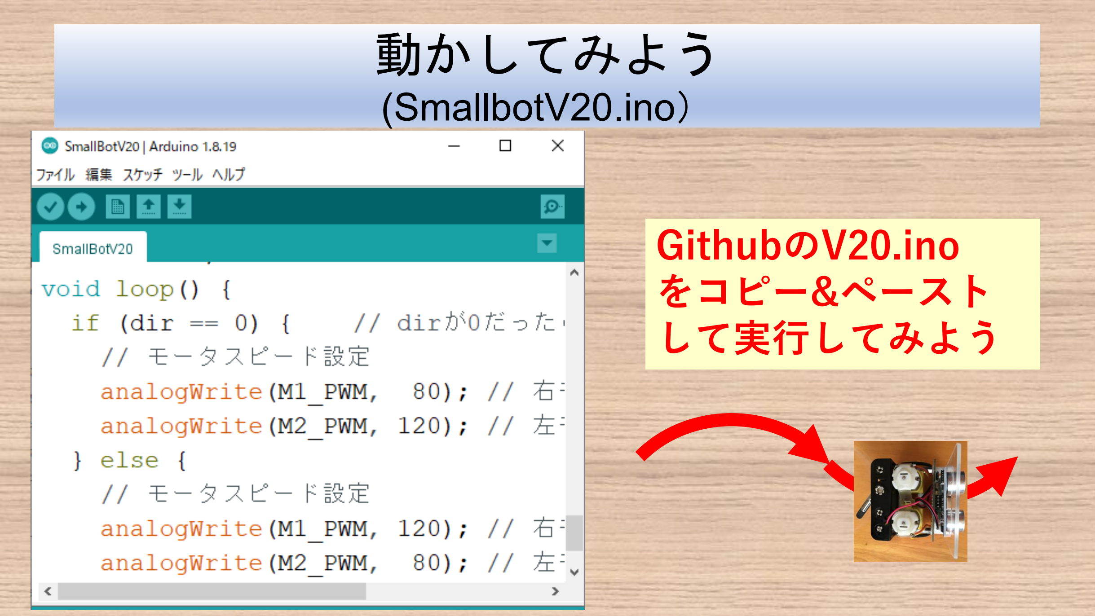
[picture p44: page 26]

(SmallbotV20.ino）

GithubのV20.ino
をコピー&ペースト
して実行してみよう

## 変数とif文の利用（V20.inoから抜粋）

左右交互に繰り返し

int dir = 0;
void loop() {
if (dir == 0) { // dirが0
analogWrite(M1_PWM, 80);
analogWrite(M2_PWM, 120);
dir = 1; // 次は左回転
}

else {
analogWrite(M1_PWM, 120);
analogWrite(M2_PWM, 80);
dir = 0; // 次は右回転
}
delay(1000); // １秒待つ
}
変数dirが0なら
右回転に設定
dirの値を1にする

変数dirが0でないなら
左回転に設定
dirの値を0にする

# 改造してみよう

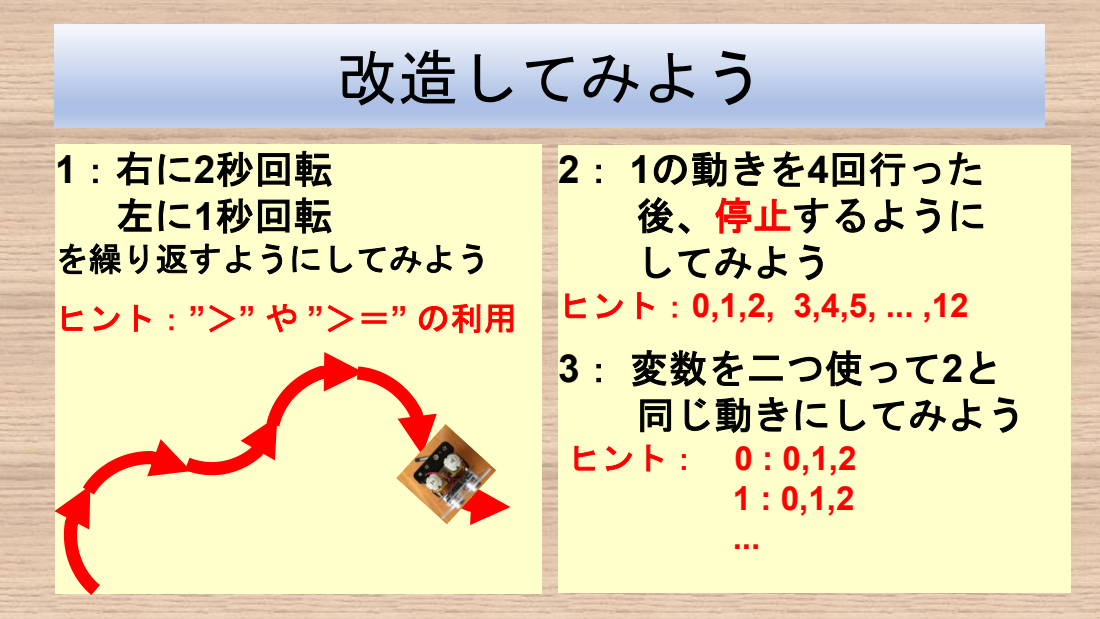
[picture p45: page 28]
1：右に2秒回転 左に1秒回転 を繰り返すようにしてみよう; ヒント：”＞” や ”＞＝” の利用; 2： 1の動きを4回行った 後、停止するように してみよう ヒント：0,1,2, 3,4,5, ... ,12; 3： 変数を二つ使って2と 同じ動きにしてみよう ヒント： 0 : 0,1,2 1 : 0,1,2 ...

# 考え方の例－1

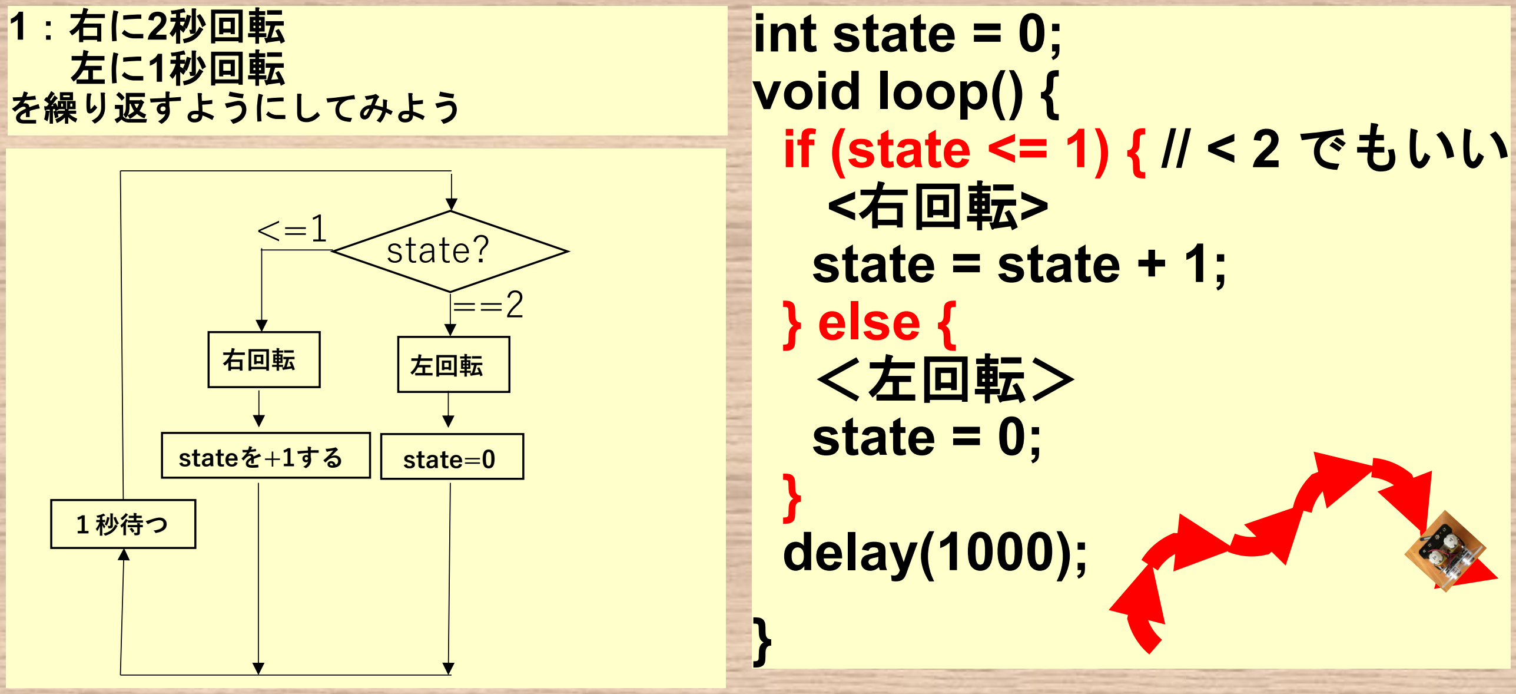
[picture p46: figure]
1：右に2秒回転 左に1秒回転 を繰り返すようにしてみよう; int state = 0; void loop() { if (state <= 1) { // < 2 でもいい <右回転> state = state + 1; } else { ＜左回転＞ state = 0;; } delay(1000);; state? <=1; 右回転; 左回転; stateを+1する; state=0; １秒待つ

# 考え方の例－２

2： 1の動きを4回行った
後、停止するように
してみよう
ヒント：0,1,2, 3,4,5, ... ,12
右右左 右右左 … ,停止

else if (state == 2) { // 2の時 ＜左回転＞
state = state + 1;
} else if (state <= 4) { // 3,4の時 ＜右回転＞
state = state + 1;
} else if・・・・
・・・・
} else if (state == 12) { //終了 ＜停止＞
}
delay(1000);
}

int state = 0;
void loop() {
if (state <= 1) //0,1の時
<右回転>
state = state + 1;
}

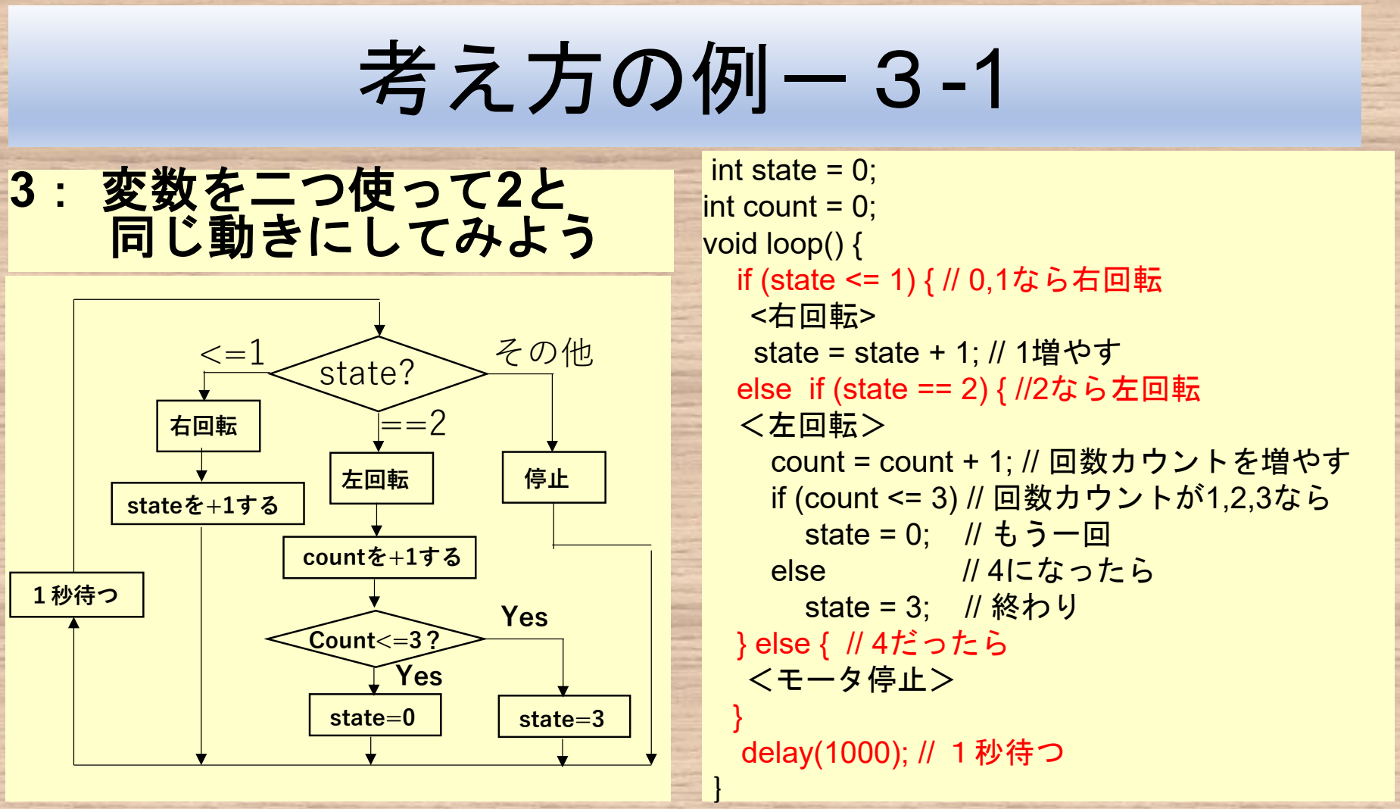
[picture p47: figure]
考え方の例－３-1; 3： 変数を二つ使って2と 同じ動きにしてみよう; int state = 0; int count = 0; void loop() { if (state <= 1) { // 0,1なら右回転 <右回転> state = state + 1; // 1増やす else if (state == 2) { //2なら左回転 ＜左回転＞ count = count + 1; // 回数カウントを増やす if (count <= 3) // 回数カウントが1,2,3なら; state = 0;; // もう一回; else; // 4になったら; state = 3;; // 終わり; } else { // 4だったら ＜モータ停止＞; } delay(1000); // １秒待つ; state? <=1; その他; countを+1する; Count<=3？; 左回転; 右回転; stateを+1する; state=0; state=3; Yes; １秒待つ

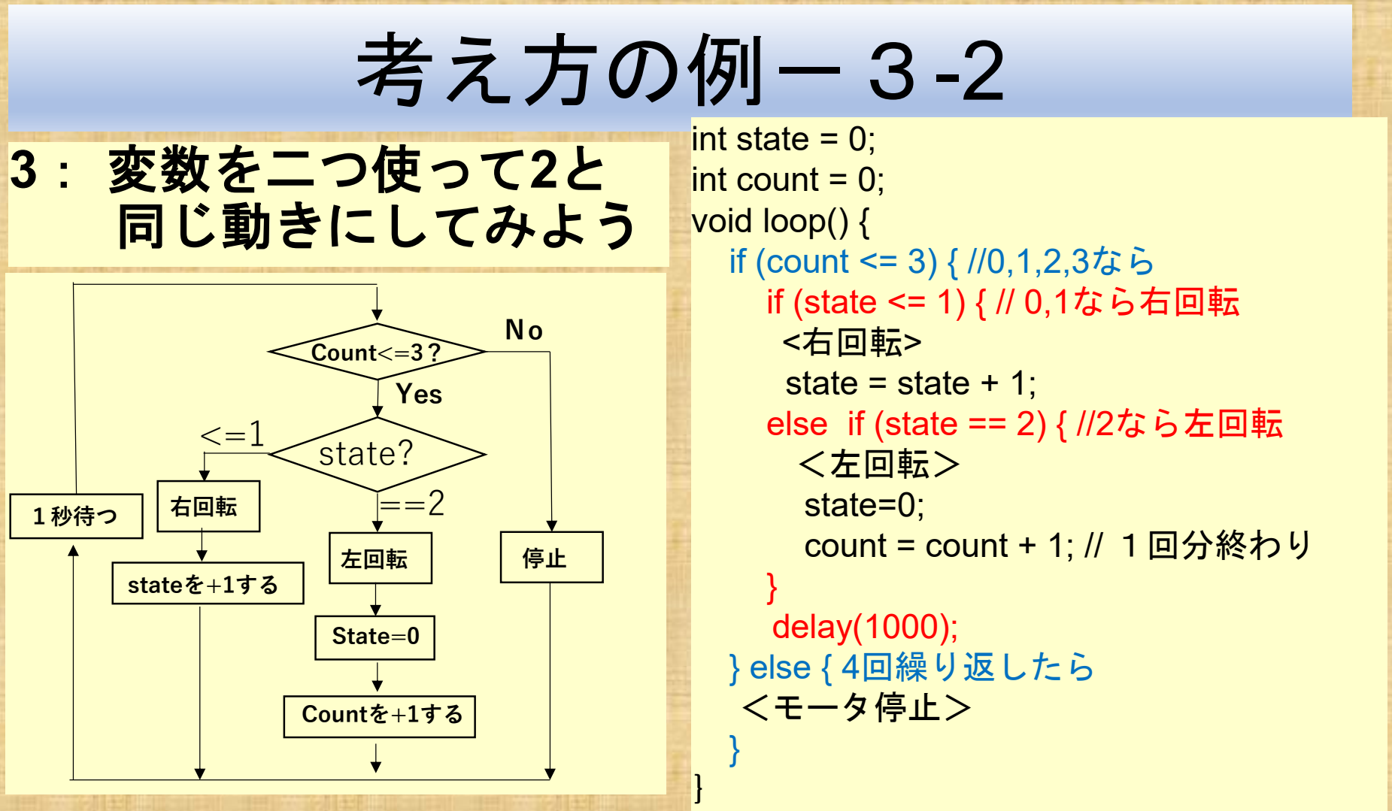
[picture p48: figure]
考え方の例－３-2; 3： 変数を二つ使って2と 同じ動きにしてみよう; int state = 0; int count = 0; void loop() { if (count <= 3) { //0,1,2,3なら if (state <= 1) { // 0,1なら右回転 <右回転> state = state + 1; else if (state == 2) { //2なら左回転 ＜左回転＞ state=0; count = count + 1; // １回分終わり; } delay(1000); } else { 4回繰り返したら ＜モータ停止＞ }; state? <=1; State=0; Count<=3？; 左回転; 右回転; stateを+1する; Yes; １秒待つ; Countを+1する

## フォトセンサを使って ライントレースさせてみよう

# 使用するセンサ類

## 超音波距離センサ

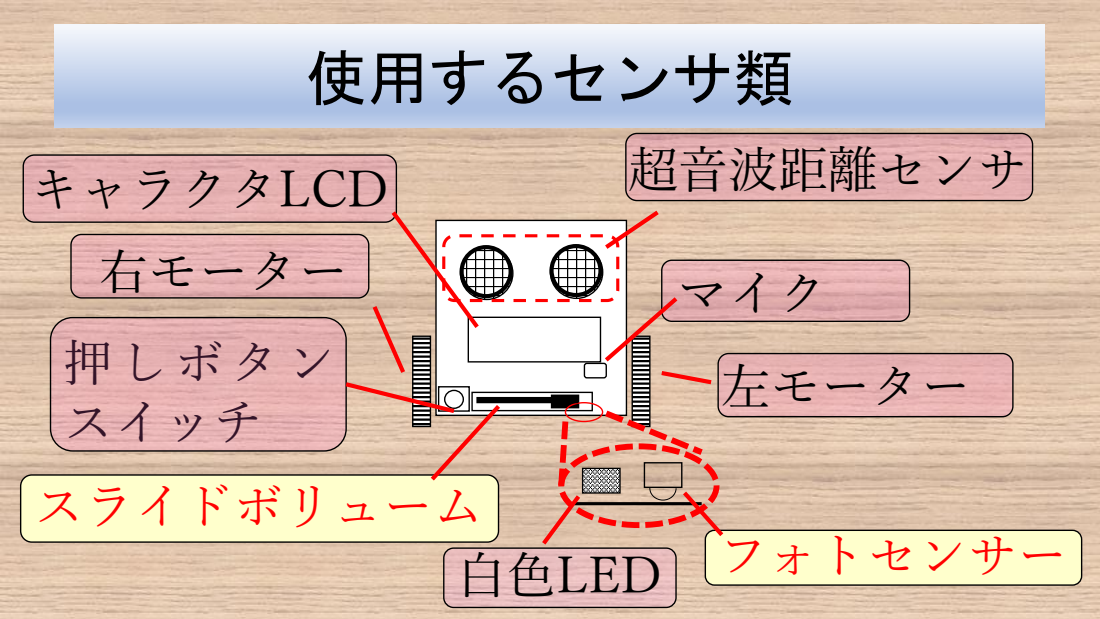
[picture p49: page 34]
スライドボリューム 白色LED フォトセンサー; 右モーター; 左モーター; マイク; 押しボタン スイッチ; キャラクタLCD

## 右に回転

# ライントレースロボット

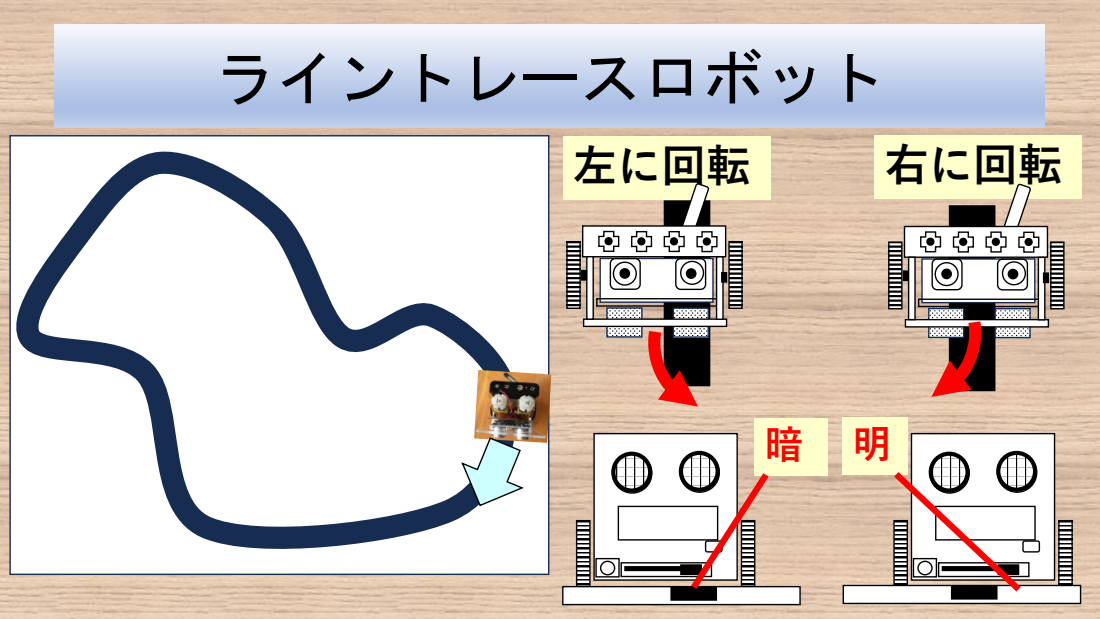
[picture p50: page 35]
左に回転

## ライントレースサンプル

### （SmallbotV30_Trace.ino)

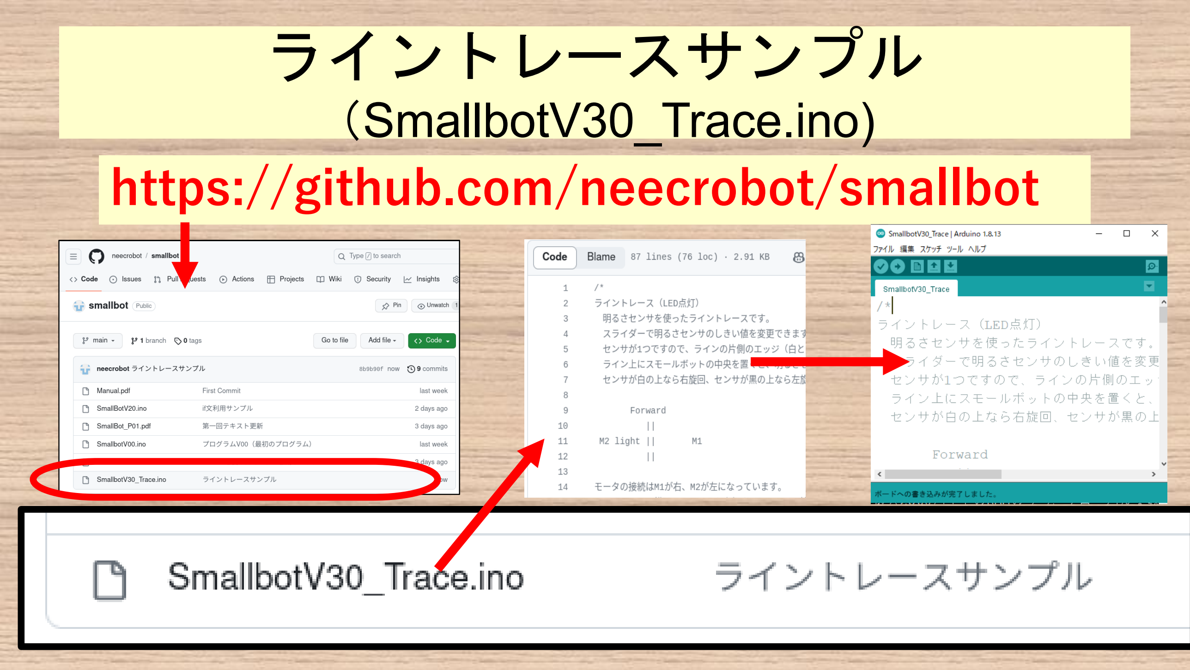
[picture p51: page 36]

## https://github.com/neecrobot/smallbot

## ライントレースのポイント

### (SmallbotV30_Trace.inoから抜粋）

int sliderval = 0; // スライダーの値 int photoval = 0; // フォトセンサの値 void loop() {
sliderval = analogRead(SLIDER); photoval = analogRead(PHOTO); if (photoval > sliderval) { // 右旋回 analogWrite(M1_PWM, 80);
analogWrite(M2_PWM, 120);
}

else { // 左旋回
analogWrite(M1_PWM, 120);
analogWrite(M2_PWM, 80);
}
delay(100); // 0.1秒現状維持
}

フォトセンサの値をスライ
ダーの値と比較して、線の
上か否かを決めている

# 入力信号の接続

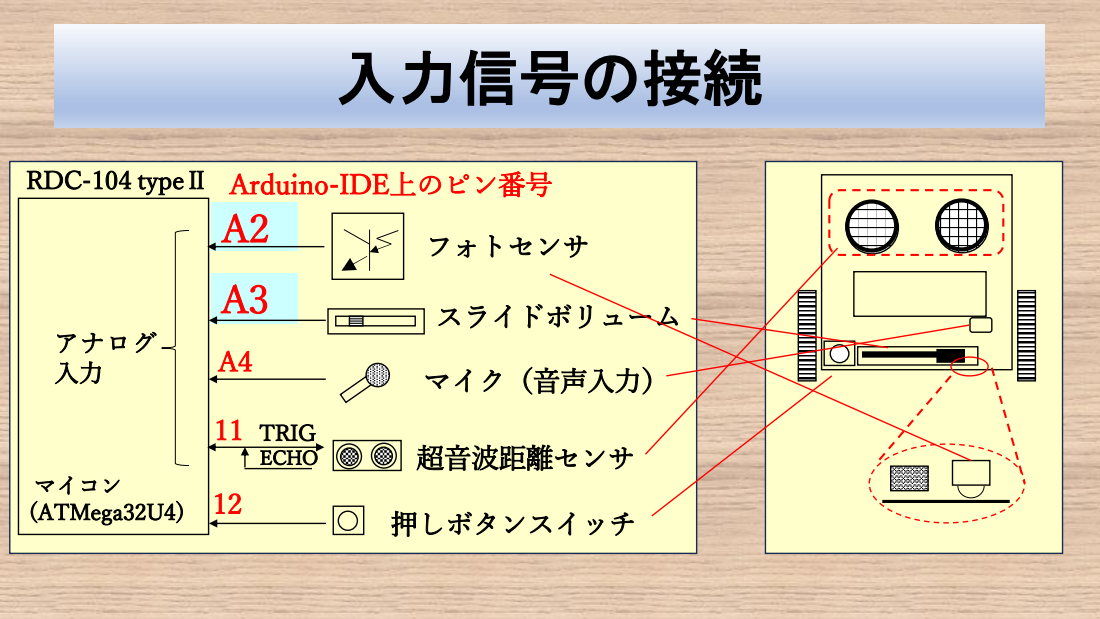
[picture p52: page 38]
フォトセンサ; RDC-104 typeⅡ; スライドボリューム; アナログ; マイク（音声入力）; 超音波距離センサ; 押しボタンスイッチ; マイコン (ATMega32U4); Arduino-IDE上のピン番号; TRIG ECHO

## センサ類の値の取得と大小

### (analogRead()の値は0～1023)

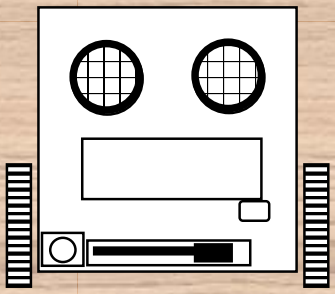
[picture p53: figure]

スライダ値 大

スライダ値 小

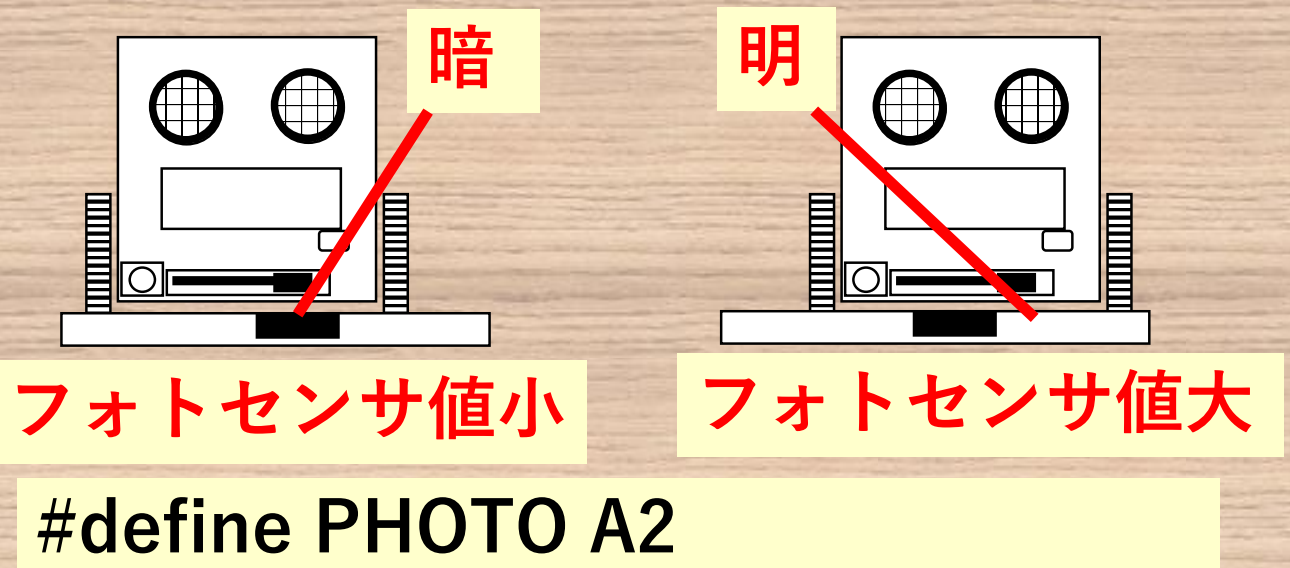
[picture p54: figure]
フォトセンサ値大; フォトセンサ値小; #define PHOTO A2
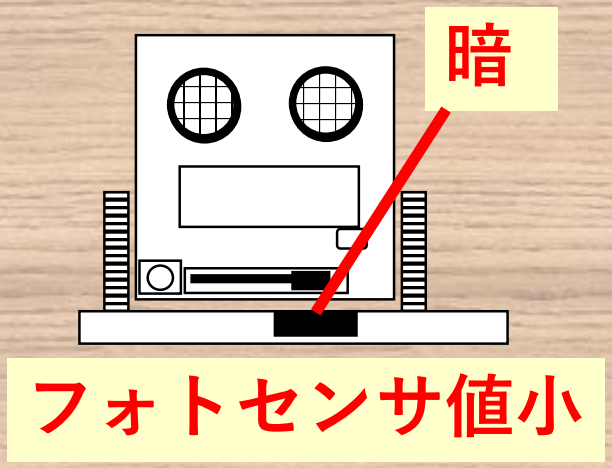
[picture p55: figure]

photoval = analogRead(PHOTO); #define SLIDER A3
sliderval = analogRead(SLIDER);

## 2：通常は直進

# 改造してみよう

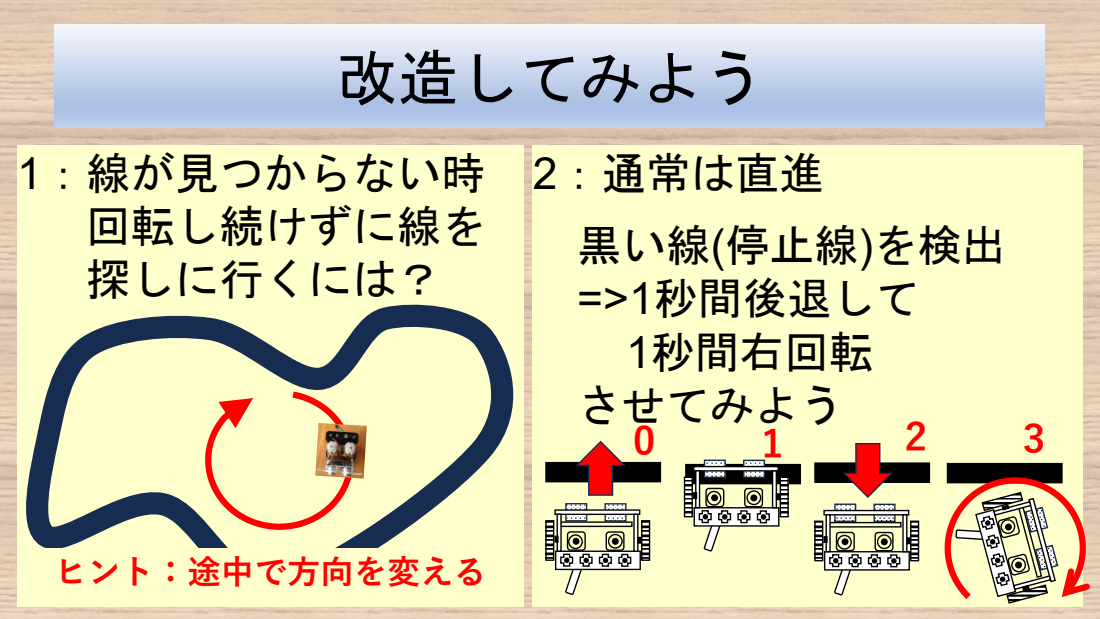
[picture p56: page 40]
黒い線(停止線)を検出 =>1秒間後退して 1秒間右回転 させてみよう; 1：線が見つからない時 回転し続けずに線を 探しに行くには？; ヒント：途中で方向を変える

# 考え方の例－１

1：線が見つからない時
回転し続けずに線を
探しに行くには？

else if (count < 40) {//0.1×40= 4秒 ＜左旋回＞
} else {
count = 0; // 右旋回やりなおし
}
} else { // 黒地
count = 0;
<左旋回＞
}
delay(100); //0.1秒
}

count = 0;
void loop() {
if (photoval>sliderval) { //白地
count = count+1;
if (count <= 20) { //0.1×20= ２秒 ＜右旋回＞
}

# 考え方の例－２

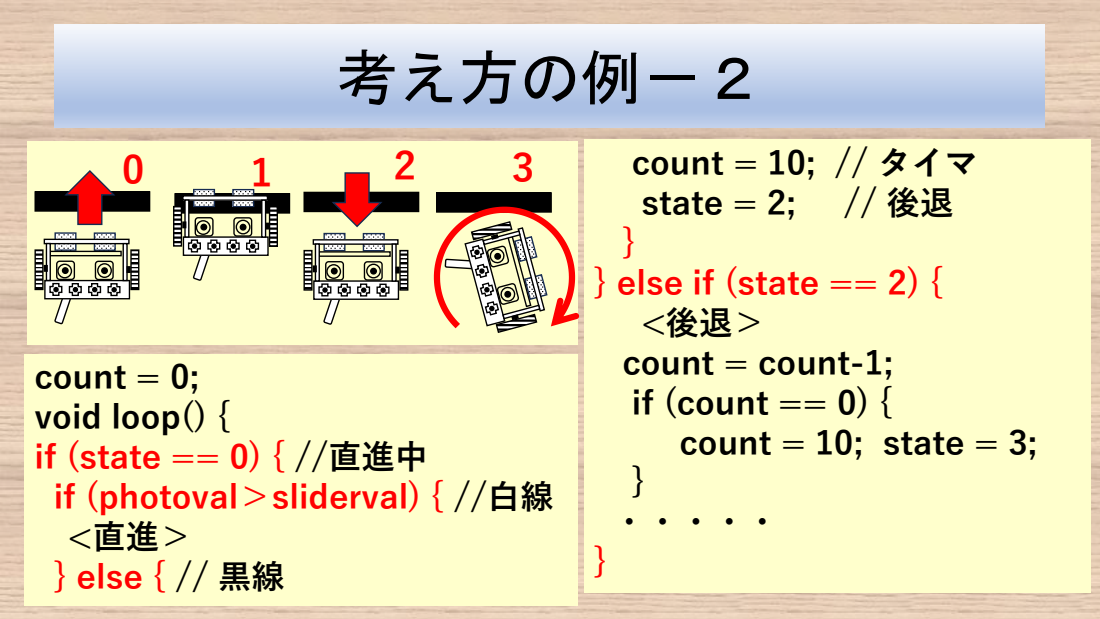
[picture p57: page 42]
count = 10; // タイマ; state = 2;; } } else if (state == 2) { <後退＞ count = count-1; if (count == 0) { count = 10; state = 3;

count = 0;
void loop() {
if (state == 0) { //直進中
if (photoval＞sliderval) { //白線
} else { // 黒線

## お疲れ様でした

## 次回はマイクと超音波センサを使ってみましょう
