neecrobot/smallbot/Manual.pdf

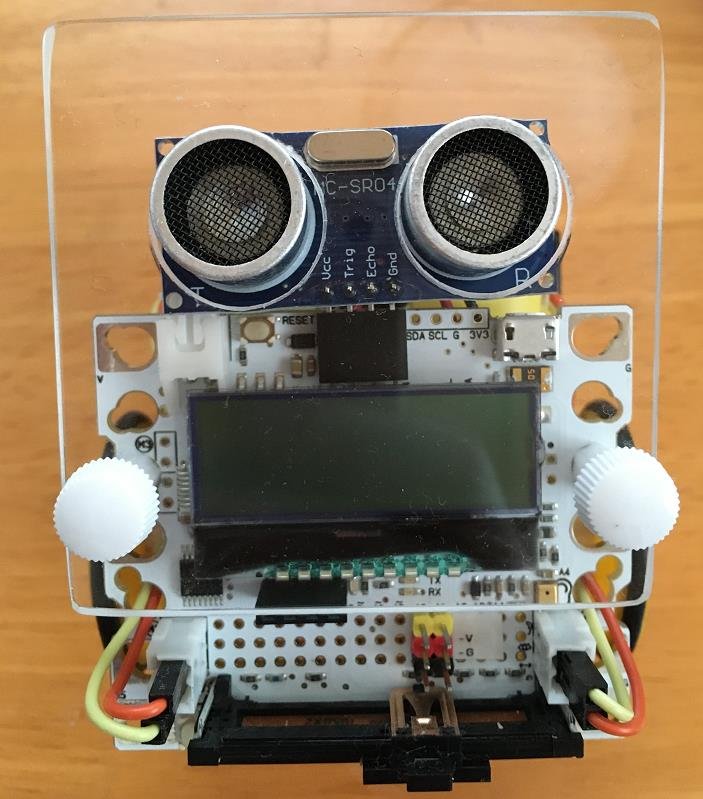
[picture p69: figure]

- 1 -

# SmallBot 回路マニュアル

2022 年 08 月

# PastelMagic

- 2 -

目次

1. SmallBot の入出力 | - 6 -
2. モーター制御 | - 10 -
2.1. モータ制御のハードウェア | - 10 -
2.1.1. モーター駆動回路 | - 10 -
2.1.2. モータードライバの入力と基本動作 | - 13 -
2.1.3. PWM 入力による回転数制御 | - 15 -
2.2. モータ駆動のソフトウェア | - 16 -
2.2.1. Arduino の設定とモーターの回転数 | - 16 -
2.3. プログラム中のモーター設定とロボットの進行方向 | - 17 -
2.3.1. サンプルプログラム中のピン名称設 | - 17 -
2.3.2. ピンの初期化 | - 18 -
2.3.3. プログラムとロボットの動き | - 18 -
3. スイッチ入力 | - 23 -
3.1. スイッチ入力のハードウェア | - 23 -
3.1.1. スイッチ入力回路 | - 23 -
3.1.2. HIGH/LOW 判定 | - 24 -
3.1.3. スイッチ入力回路の動作 | - 25 -
3.2. スイッチ入力のソフトウェア | - 26 -
4. LED | - 28 -
4.1. LED 出力のハードウェア | - 28 -
4.1.1. LED 点灯回路 | - 28 -
4.1.2. LED 点灯回路の動作 | - 29 -
4.2. LED 点灯ソフトウェア | - 30 -
5. スライドボリューム（可変抵抗器） | - 31 -
5.1. スライドボリューム入力のハードウェア | - 32 -
5.1.1. スライドボリューム入力回路 | - 32 -
5.2. スライドボリューム入力回路の動作 | - 32 -
5.2.1. スライドボリューム読み込みソフトウェア | - 34 -
5.2.2. map()関数 | - 34 -
6. フォトセンサ | - 35 -
6.1. SmallBot のフォトセンサのハードウェア | - 36 -
6.1.1. フォトセンサ回路 | - 36 -

- 3 -
6.1.2. フォトトランジスタの動作 | - 37 -
6.2. フォトセンサのソフトウェア | - 37 -
7. マイク入力 | - 41 -
7.1. マイク入力のハードウェア | - 42 -
7.1.1. マイク入力回路 | - 42 -
7.1.2. HPF | - 42 -
7.1.3. HPF のカットオフ周波数 | - 44 -
7.1.4. 増幅回路 | - 45 -
7.1.5. オペアンプの基本動作 | - 45 -
7.1.6. 増幅回路の動作 | - 46 -
7.1.7. 非反転増幅回路の入出力関係 | - 47 -
7.1.8. ピーク検出回路 | - 49 -
7.1.9. ピーク検出回路の基本動作 | - 50 -
7.1.10. ピーク検出回路のシミュレーション | - 52 -
7.1.11. マイク入力回路のシミュレーション | - 53 -
7.2. マイク入力のソフトウェア | - 55 -
8. 超音波距離センサ | - 56 -
8.1. 超音波距離センサのハードウェア | - 56 -
8.1.1. 超音波距離センサの外観 | - 56 -
8.1.2. 超音波距離計測の仕組み | - 57 -
8.1.3. 超音波距離計測動作 | - 58 -
8.1.4. 超音波距離センサ回路図 | - 59 -
8.2. 超音波距離センサソフトウェア | - 60 -
9. キャラクタ LCD | - 62 -
9.1. キャラクタ LCD のハードウェア | - 62 -
9.2. キャラクタ LCD のソフトウェア | - 63 -

- 4 -
図 1：SmallBot の入出力デバイス配置 | - 6 -
図 2：SmallBot の入出力接続 | - 7 -
図 3：左右のモーター配置と回転方向 | - 10 -
図 4：モータードライバの周辺回路の接続とプログラム中のピン定義例 | - 11 -
図 5：モータードライバの入力信号と基本動作イメージ（1／2） | - 12 -
図 6：モータードライバの入力信号と基本動作イメージ（2／2） | - 13 -
図 7：PWM 入力によるモーターの回転数制御（1／2） | - 14 -
図 8：PWM 入力によるモーターの回転数制御（2／2） | - 15 -
図 9：analogWrite()関数の設定値と出力波形、モーターの回転数 | - 16 -
図 10：サンプルプログラム中のピン名称定義 | - 17 -
図 11：モーター関連ピンの初期化 | - 18 -
図 12：モータードライバの設定とロボットの移動方向(1/3) | - 20 -
図 13：モータードライバの設定とロボットの移動方向(2/3) | - 21 -
図 14：モータードライバの設定とロボットの移動方向(3/3) | - 22 -
図 15：SmallBot の押しボタンスイッチ入力回路 | - 23 -
図 16 入力電圧と HIGH/LOW 判定 | - 24 -
図 17：スイッチ入力の動作 | - 25 -
図 18：サンプルプログラムのスイッチ読み込み | - 26 -
図 19:LED 点灯回路 | - 28 -
図 20：LED 点灯回路の動作 | - 29 -
図 21：サンプルプログラム中の LED 点滅 | - 30 -
図 22：スライドボリュームの基本構造 | - 31 -
図 23：スライドボリューム入力回路 | - 32 -
図 24：スライドボリュームの動作 | - 33 -
図 25：スライドボリュームの Ra の値と Vin の関係 | - 33 -
図 26：サンプルプログラムのスライダ値読み込み部分 | - 34 -
図 27：map()関数による値の変換 | - 35 -
図 28：フォトセンサ入力回路 | - 36 -
図 29：フォトトランジスタの動作 | - 37 -
図 30：サンプルプログラムのフォトセンサ入力 | - 37 -
図 31：ライントレース動作 | - 38 -
図 32：線の左側にロボットがある場合の動作例 | - 39 -
図 33：SmallBot のマイクの位置 | - 41 -

- 5 -
図 34：マイク入力回路 | - 41 -
図 35：周波数と HPF 出力レベルの変化 | - 43 -
図 36：マイク入力の HPF の特性 | - 44 -
図 37：マイク増幅回路 | - 45 -
図 38：オペアンプの基本動作 | - 46 -
図 39：非反転増幅回路の動作 | - 47 -
図 40：非反転増幅回路の増幅動作 | - 48 -
図 41：非反転増幅回路の出力波形 | - 48 -
図 42：ピーク検出回路 | - 49 -
図 43：ピーク検出回路の考え方 | - 50 -
図 44：ピーク検出回路の動作 | - 51 -
図 45：ピーク検出回路シミュレーション回路 | - 52 -
図 46：ピーク検出回路シミュレーション結果 | - 53 -
図 47：マイク入力回路シミュレーション回路 | - 54 -
図 48：マイク入力回路シミュレーション結果 | - 54 -
図 49：サンプルプログラムの音声入力処理 | - 55 -
図 50：超音波距離センサの位置 | - 56 -
図 51：超音波距離センサの外観 | - 56 -
図 52：超音波距離センサモジュールの動作 | - 57 -
図 53：超音波距離センサ回路図 | - 59 -
図 54：サンプルプログラムの音波距離計測部分 | - 60 -
図 55：キャラクタ LCD の位置 | - 62 -
図 56：キャラクタ LCD の接続 | - 62 -
図 57：サンプルプログラムのキャラクタ LCD 制御（抜粋） | - 63 -
図 58：setCursor()の引数と表示開始位置 | - 65 -

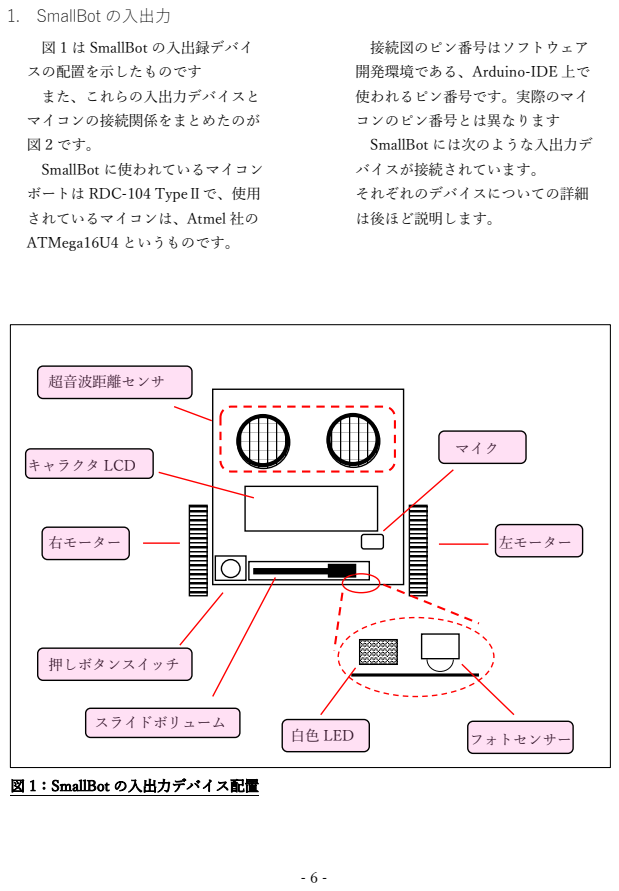
[picture p70: page 6]
1. SmallBot の入出力; 右モーター; 左モーター; 超音波距離センサ; マイク; スライドボリューム; 押しボタンスイッチ; 白色 LED; フォトセンサー; キャラクタ LCD; 図 1：SmallBot の入出力デバイス配置

図 1 は SmallBot の入出録デバイ
スの配置を示したものです
また、これらの入出力デバイスと
マイコンの接続関係をまとめたのが
SmallBot に使われているマイコン
ボートは RDC-104 TypeⅡで、使用
されているマイコンは、Atmel 社の
ATMega16U4 というものです。

接続図のピン番号はソフトウェア
開発環境である、Arduino-IDE 上で
使われるピン番号です。実際のマイ
コンのピン番号とは異なります
SmallBot には次のような入出力デ
バイスが接続されています。
それぞれのデバイスについての詳細
は後ほど説明します。

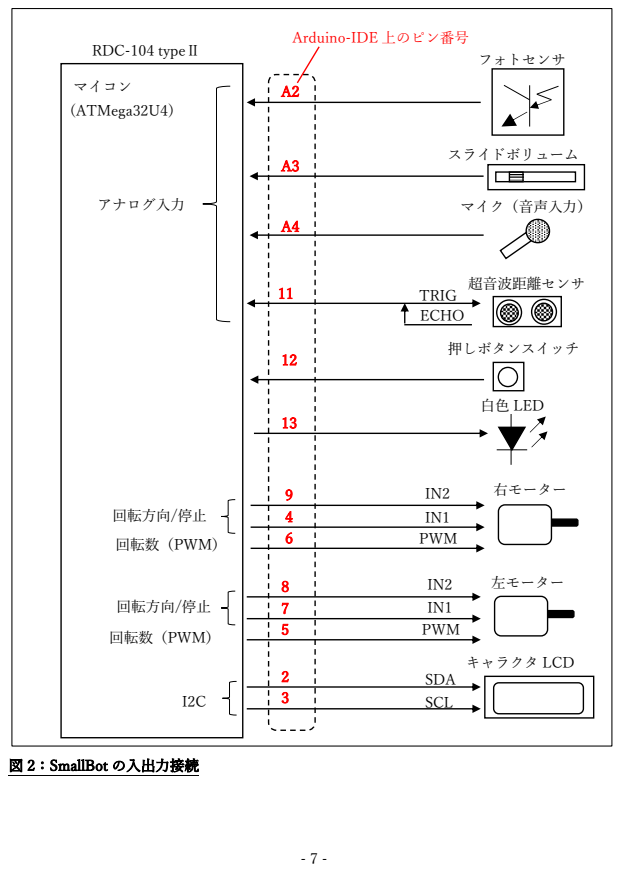
[picture p71: page 7]
スライドボリューム; アナログ入力; マイク（音声入力）; 超音波距離センサ; 押しボタンスイッチ; 白色 LED; 8 7 5 回転数（PWM）; 回転数（PWM）; 回転方向/停止; 左モーター; マイコン; (ATMega32U4); SDA; SCL; PWM; キャラクタ LCD; TRIG ECHO; 右モーター; 図 2：SmallBot の入出力接続

Arduino-IDE 上のピン番号

フォトセンサ RDC-104 typeⅡ

- 8 -

○左右モーター
ロボットの前進、後退、旋回など
を行うのがロボットの左右に付いて
いるモーターです。
左右のモーターそれぞれを駆動す
る信号は 3 本あり、3 本のうちの 2
本がモーターの回転方向やブレーキ
動作などを指示する信号
（IN1/IN2）、1 本がモーターの回転
数を制御する信号（PWM）信号で
す。

○スイッチ入力
押すと ON、離すと OFF になる押
しボタンスイッチが 1 つ用意されて
います。用途は自由です。サンプル
プログラムでは動作モードを切り替
えるのに利用しています。

○LED 出力
ユーザが自由に点滅させることが
できる白色 LED が 1 つ用意されて
います。プログラムの動作状態を表
示するのにも利用できます。
サンプルプログラムでは動作モード
に応じて、消灯、点滅、連続点灯と
切り替わるようにしています。

○スライドボリューム
つまみの位置を左右に動かすこと
で抵抗値が変化するものです。

SmallBot では本体正面に取り付け
られていて、抵抗値の変化によって
変化する電圧をマイコンのアナログ
入力で読み込むことができるように
設計されています。
これによって、マイコンでつまみ
の位置を知ることができます。
サンプルプログラムでは障害物回
避動作に入る距離の調整などに使っ
ています。

○フォトセンサ
フォトセンサは明るさを検出する
ものです。SmallBot ではフォトトラ
ンジスタと呼ばれる半導体式の光セ
ンサが使われています。
フォトセンサを利用して明るさに
応じた電圧を生成し、マイコンのア
ナログ入力で読み取れるようにして
います。周囲の明るさをマイコンで
しることができるわけです。
SmallBot のフォトセンサは床の明
るさを検出するように下向きにとり
つけられています。サンプルプログ
ラムではライントレース（床に書か
れた線を辿って動く）モードでフォ
トセンサを利用しています。

○マイク入力
SmallBot の基板上にはマイクが取
り付けられていて、周囲の騒音レベ

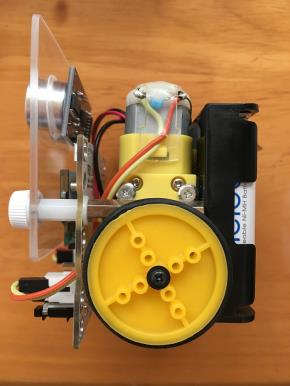
[picture p72: figure]

- 9 -

ルを計測できるようになっていま
す。音声の取り込みではなく、騒音
計のように、大まかな音声の大きさ
を計測するものです。
計測されたデータの用途は自由で
す。サンプルプログラムでは手を叩
くなどすると方向転換をする動作モ
ード（ダンスモード）でマイク入力
を利用しています。

○超音波距離センサ
超音波距離センサモジュールは、
超音波を使って対象物までの距離計
測を行うモジュールです。
超音波を発信し、対象物に反射し
て戻ってくるまでの時間を計測する
ことで距離を計測するという仕組み
になっています。
超音波の発信や受信の処理は超音
波距離センサモジュール内部で処理
されますので、マイコン側では細か
い処理は不要です。
超音波距離センサモジュールには

超音波発信を指示する TRIG 入力信
号と計測結果を示す ECHO 出力信
号の二つの信号線があります。それ
ぞれの信号を別々のピンに接続する
のが一般的ですが、に SmallBot で
はマイコンのピンの入出力モードを
切り替えて利用することで、1 本の
ピンで超音波距離センサモジュール
を動かしています。

○キャラクタ LCD
SmallBot には文字や数字を表示で
きる、キャラクタ LCD モジュール
が搭載されています。
表示可能な文字はアルファベット
や数字で、表示できる行数は 2 行
で、1 行に表示できる文字数は 16
文字です。
サンプルプログラムでは動作モー
ドやロボットの進行方向を表示する
のに利用しています。

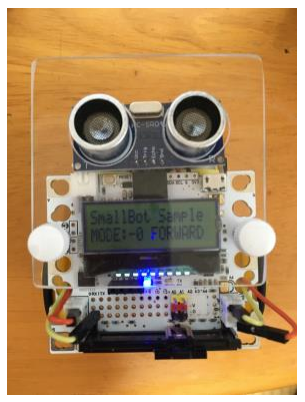
[picture p73: figure]
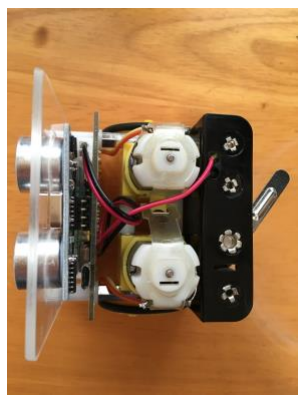
[picture p74: figure]
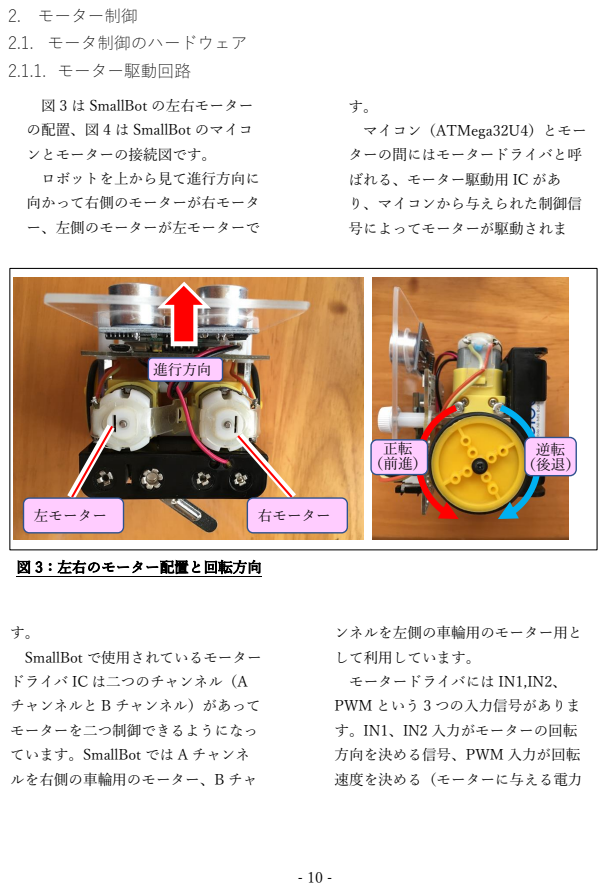
[picture p75: page 10]
2. モーター制御; 2.1. モータ制御のハードウェア; 2.1.1. モーター駆動回路; 左モーター; 右モーター; 進行方向; 図 3：左右のモーター配置と回転方向

図 3 は SmallBot の左右モーター
の配置、図 4 は SmallBot のマイコ
ンとモーターの接続図です。
ロボットを上から見て進行方向に
向かって右側のモーターが右モータ
ー、左側のモーターが左モーターで

マイコン（ATMega32U4）とモー
ターの間にはモータードライバと呼
ばれる、モーター駆動用 IC があ
り、マイコンから与えられた制御信
号によってモーターが駆動されま

SmallBot で使用されているモーター
ドライバ IC は二つのチャンネル（A
チャンネルと B チャンネル）があって
モーターを二つ制御できるようになっ
ています。SmallBot では A チャンネ
ルを右側の車輪用のモーター、B チャ

ンネルを左側の車輪用のモーター用と
して利用しています。
モータードライバには IN1,IN2、
PWM という 3 つの入力信号がありま
す。IN1、IN2 入力がモーターの回転
方向を決める信号、PWM 入力が回転
速度を決める（モーターに与える電力

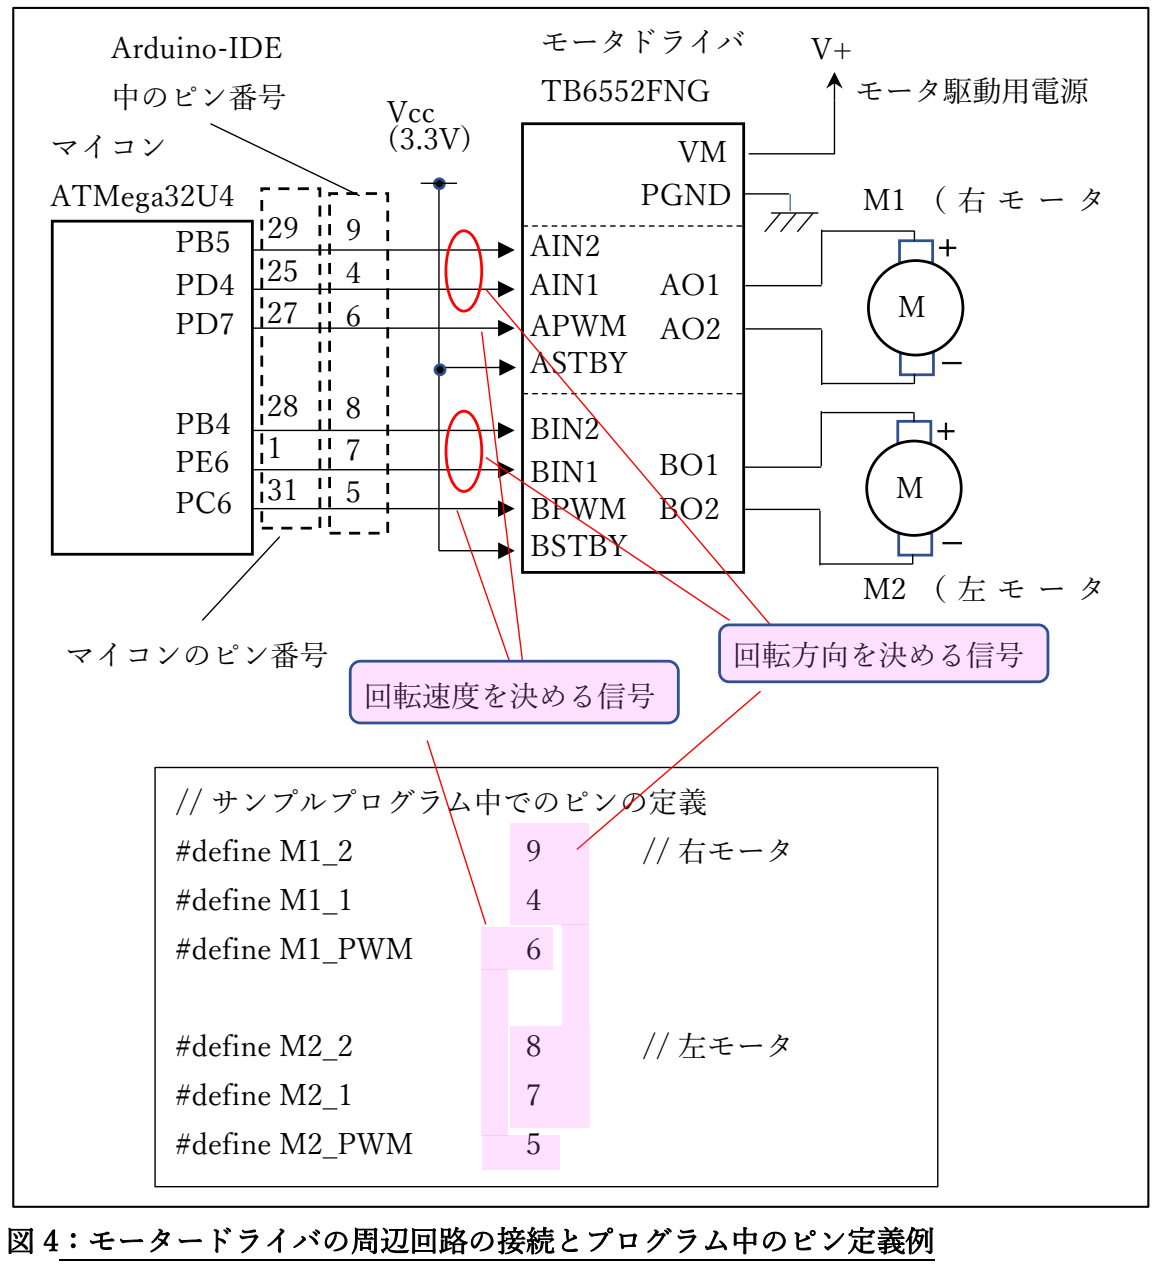
[picture p76: figure]
AIN1; AIN2; APWM ASTBY; BIN1; BIN2; BPWM BSTBY; Vcc; PGND; マイコン; ATMega32U4; モータドライバ; TB6552FNG; モータ駆動用電源; Arduino-IDE; 中のピン番号; マイコンのピン番号; // サンプルプログラム中でのピンの定義; #define M1_2; // 右モータ; #define M1_1; #define M1_PWM; #define M2_2; // 左モータ; #define M2_1; #define M2_PWM; 回転方向を決める信号; 回転速度を決める信号; 図 4：モータードライバの周辺回路の接続とプログラム中のピン定義例

- 11 -

を制御する）信号です。
サンプルプログラムでは右モーター
（A チャンネル）を M1、左モーター
（B チャンネル）を M2 を信号名の頭
につけることにしています。たとえ

ば、右モーターの信号は
M1_1、M1_2、M1_PWM
左モーターの信号は
M2_1、M2_2、M2_PWM
という具合です。

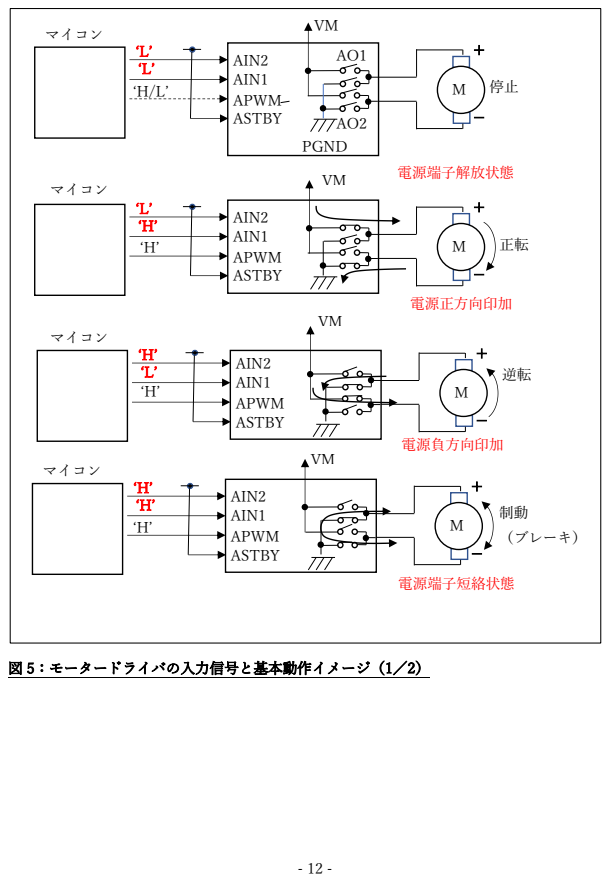
[picture p77: page 12]
AIN1; AIN2; APWM; ASTBY; APWM ASTBY; 電源端子解放状態; 電源正方向印加; 電源負方向印加; 電源端子短絡状態; 制動 （ブレーキ） ‘H’; PGND; マイコン; 図 5：モータードライバの入力信号と基本動作イメージ（1／2）

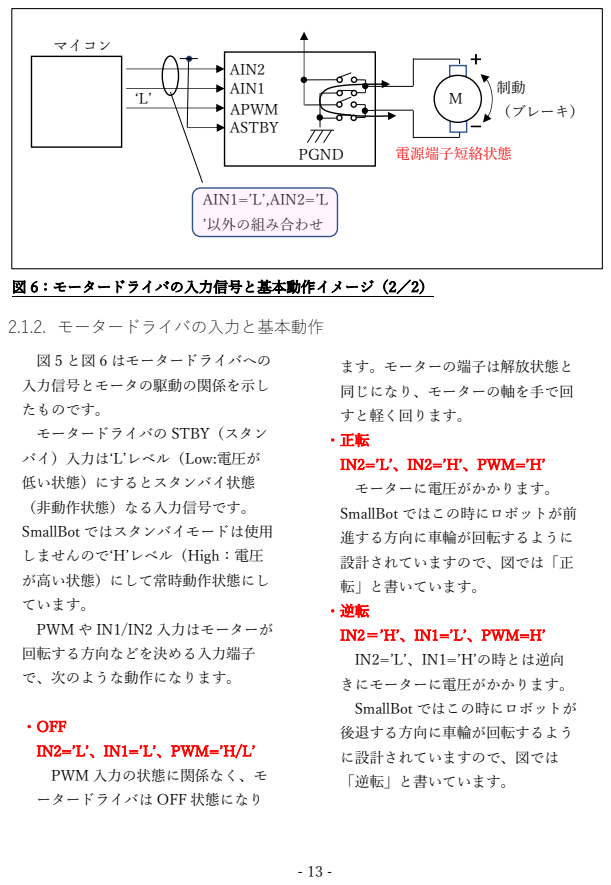
[picture p78: page 13]
2.1.2. モータードライバの入力と基本動作; ます。モーターの端子は解放状態と; 同じになり、モーターの軸を手で回; すと軽く回ります。; IN2=’L’、IN2=’H’、PWM=’H’; モーターに電圧がかかります。; SmallBot ではこの時にロボットが前; 進する方向に車輪が回転するように; 設計されていますので、図では「正; 転」と書いています。; IN2＝’H’、IN1=’L’、PWM=H’; IN2=’L’、IN1=’H’の時とは逆向; きにモーターに電圧がかかります。; SmallBot ではこの時にロボットが; 後退する方向に車輪が回転するよう; に設計されていますので、図では; 「逆転」と書いています。; AIN1; AIN2; APWM ASTBY; （ブレーキ）; マイコン; 電源端子短絡状態; AIN1=’L’,AIN2=’L; ’以外の組み合わせ; PGND; 図 6：モータードライバの入力信号と基本動作イメージ（2／2）

図 5 と図 6 はモータードライバへの
入力信号とモータの駆動の関係を示し
たものです。
モータードライバの STBY（スタン
バイ）入力は‘L’レベル（Low:電圧が
低い状態）にするとスタンバイ状態
（非動作状態）なる入力信号です。
SmallBot ではスタンバイモードは使用
しませんので‘H’レベル（High：電圧
が高い状態）にして常時動作状態にし
ています。
PWM や IN1/IN2 入力はモーターが
回転する方向などを決める入力端子
で、次のような動作になります。

・OFF
IN2=’L’、IN1=’L’、PWM=’H/L’
PWM 入力の状態に関係なく、モ
ータードライバは OFF 状態になり

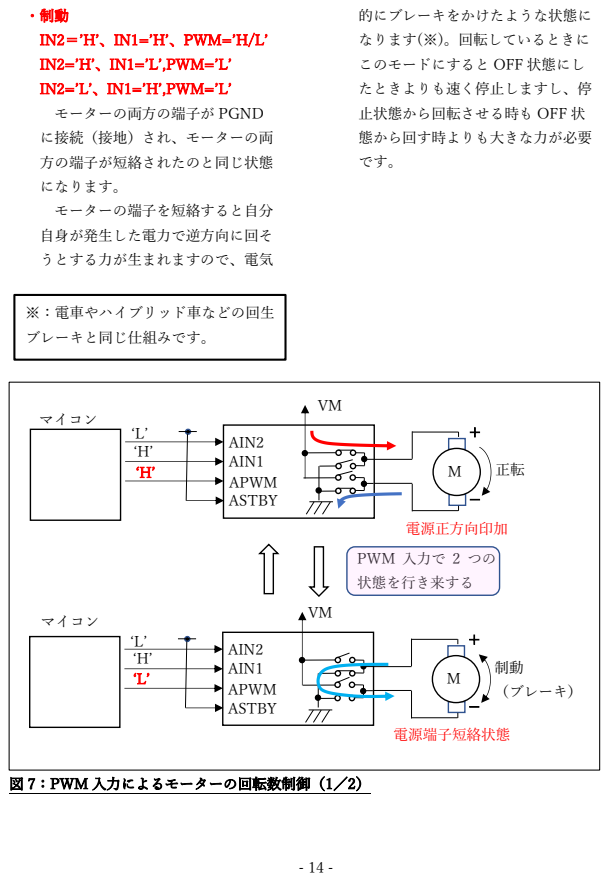
[picture p79: page 14]
図 7：PWM 入力によるモーターの回転数制御（1／2）; AIN1; AIN2; APWM ASTBY; （ブレーキ）; 電源正方向印加; 電源端子短絡状態; マイコン; IN2＝’H’、IN1=’H’、PWM=’H/L’; IN2=’H’、IN1=’L’,PWM=’L’; IN2=’L’、IN1=’H’,PWM=’L’; モーターの両方の端子が PGND; に接続（接地）され、モーターの両; 方の端子が短絡されたのと同じ状態; になります。; モーターの端子を短絡すると自分; 自身が発生した電力で逆方向に回そ; うとする力が生まれますので、電気; ※：電車やハイブリッド車などの回生; ブレーキと同じ仕組みです。

的にブレーキをかけたような状態に
なります(※)。回転しているときに
このモードにすると OFF 状態にし
たときよりも速く停止しますし、停
止状態から回転させる時も OFF 状
態から回す時よりも大きな力が必要

PWM 入力で 2 つの
状態を行き来する

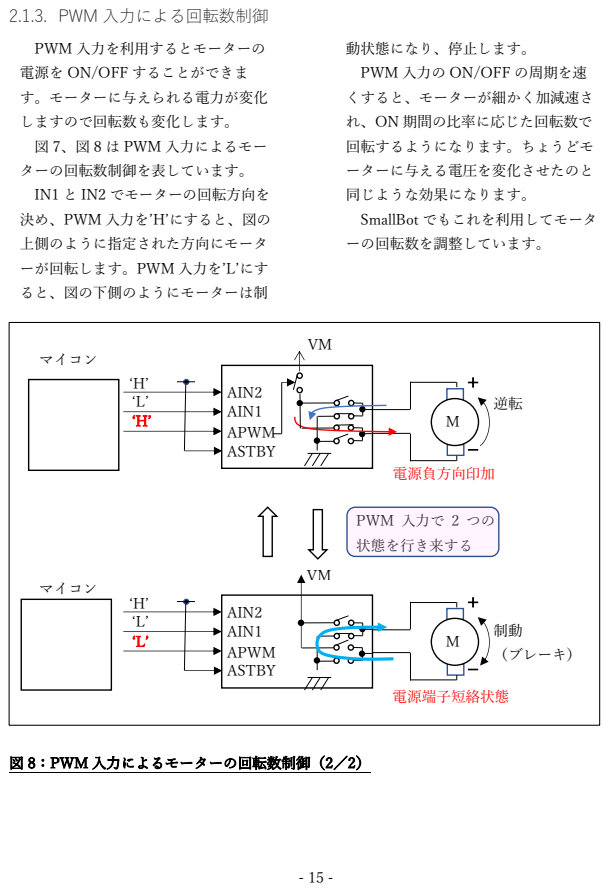
[picture p80: page 15]
2.1.3. PWM 入力による回転数制御; 図 8：PWM 入力によるモーターの回転数制御（2／2）; AIN1; AIN2; APWM ASTBY; （ブレーキ）; マイコン; 電源端子短絡状態; 電源負方向印加

PWM 入力を利用するとモーターの
電源を ON/OFF することができま
す。モーターに与えられる電力が変化
しますので回転数も変化します。
図 7、図 8 は PWM 入力によるモー
ターの回転数制御を表しています。
IN1 と IN2 でモーターの回転方向を
決め、PWM 入力を’H’にすると、図の
上側のように指定された方向にモータ
ーが回転します。PWM 入力を’L’にす
ると、図の下側のようにモーターは制

動状態になり、停止します。
PWM 入力の ON/OFF の周期を速
くすると、モーターが細かく加減速さ
れ、ON 期間の比率に応じた回転数で
回転するようになります。ちょうどモ
ーターに与える電圧を変化させたのと
同じような効果になります。
SmallBot でもこれを利用してモータ
ーの回転数を調整しています。

PWM 入力で 2 つの
状態を行き来する

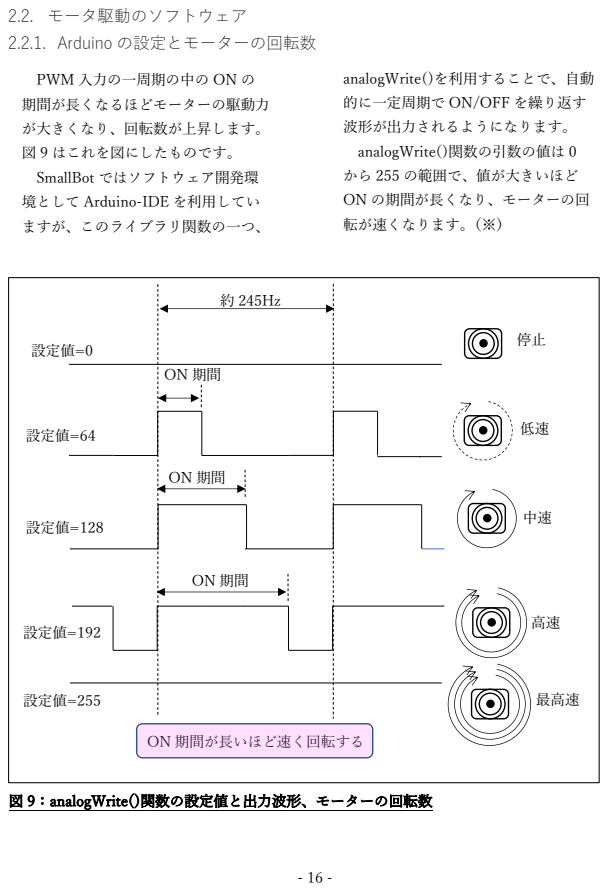
[picture p81: page 16]
2.2. モータ駆動のソフトウェア; 2.2.1. Arduino の設定とモーターの回転数; 設定値=64; 設定値=128; 設定値=192; 設定値=0; 設定値=255; 最高速; ON 期間が長いほど速く回転する

PWM 入力の一周期の中の ON の
期間が長くなるほどモーターの駆動力
が大きくなり、回転数が上昇します。
図 9 はこれを図にしたものです。
SmallBot ではソフトウェア開発環
境として Arduino-IDE を利用してい
ますが、このライブラリ関数の一つ、

analogWrite()を利用することで、自動
的に一定周期で ON/OFF を繰り返す
波形が出力されるようになります。
analogWrite()関数の引数の値は 0
から 255 の範囲で、値が大きいほど
ON の期間が長くなり、モーターの回
転が速くなります。（※）

図 9：analogWrite()関数の設定値と出力波形、モーターの回転数

- 17 -
2.3. プログラム中のモーター設定とロボットの進行方向
2.3.1. サンプルプログラム中のピン名称設

図 10：サンプルプログラム中のピン名称定義

// マイコンのピン（端子）番号の定義
#define M1_2 | 9 | // 右モーターの IN2 ピン

#define M1_1 | 4 | // 右モーターの IN1 ピン

#define M1_PWM | 6 | // 右モーターの PWM ピン

#define M2_2 | 8 | // 左モータ用の IN2 ピン

#define M2_1 | 7 | //

#define M2_PWM | 5

ピンの名称 | | ピンの番号

※ON 期間の比率が 0%ならば停止、100%ならば 最高速度になりますが、ON 期間比率とモーター
の回転数は比例するわけではありません。一定値
以下だとモーターが回転し始めることができず、
停止したままになります。
モーターの回転数は負荷の大きさによっても変

図 10 はサンプルプログラム中でピ
ン名称の設定を行っている部分です。
ピンの番号は右側にある数値で示さ
れています。これはプログラムの読み
やすさを上げるためのものです。
たとえば、右側のモータードライバ
の PWM の設定値を 64 にする（’H’の
期間が ⁶⁴
255になる）ならば
analogWrite(6,64);

のように書いても良いのですが、単
に”6”という数字では何に対する設定
なのかわかりにくく、間違えやすくな
ります。
図のように#define 文を使って定義
しておくと、
analogWrite(M1_PWM,64);
という具合にわかりやすく記述する
ことができ、間違えにくくなります。

化しますので、指定した回転数で回転させるため
には、回転数を検出するセンサーを利用して、設
定値に近づけるように制御する必要があります。
SmallBot には回転数のセンサは搭載していま
せんので、サンプルプログラムでは実機での動き
を見ながら設定値を決めました。

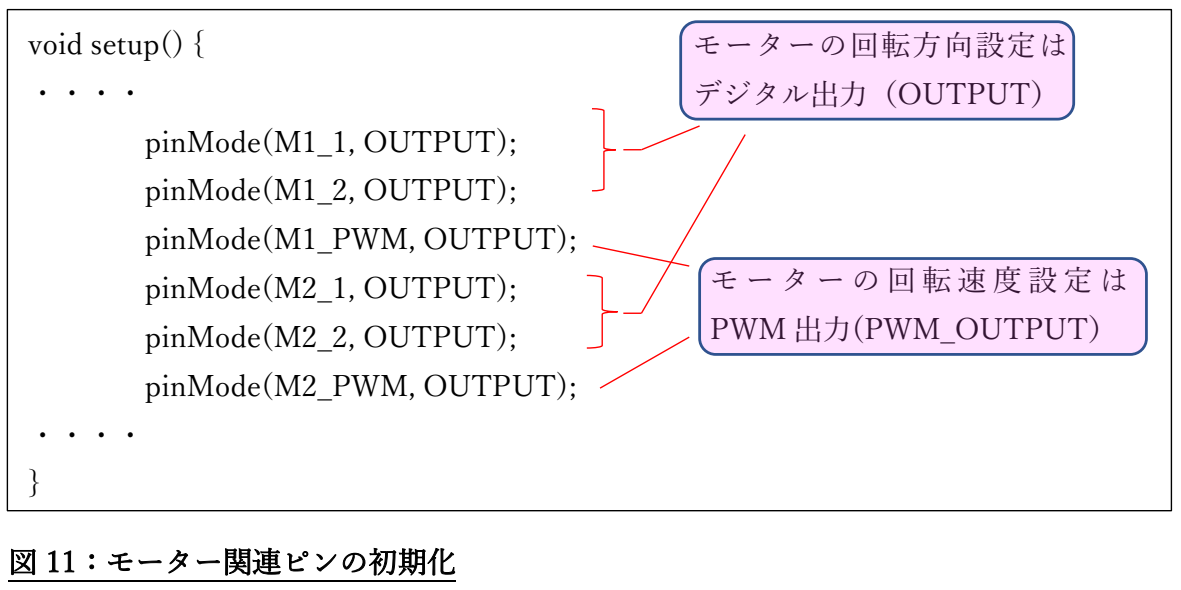
[picture p82: figure]
void setup() {; pinMode(M1_1, OUTPUT);; pinMode(M1_2, OUTPUT);; pinMode(M1_PWM, OUTPUT);; pinMode(M2_1, OUTPUT);; pinMode(M2_2, OUTPUT);; pinMode(M2_PWM, OUTPUT);; モーターの回転方向設定は; デジタル出力（OUTPUT）; モーターの回転速度設定は; PWM 出力(PWM_OUTPUT）; 図 11：モーター関連ピンの初期化

- 18 -
2.3.2. ピンの初期化
2.3.3. プログラムとロボットの動き

サンプルプログラム（Arduino-IDE）中の設定とロボットの動きの関
係を示したのが図 12、図 13、図 14
です。右モーターを M1、左モーター
を M2 とします。

(1）停止
M1、M2 とも停止状態（モータ

ードライバの IN1、IN2 を LOW に
する）にします。
ピンの HIGH、LOW の状態を設定
するには digitalWrite()関数を使用
して、
digitalWrite(ピン番号、状態);
のように記述します。
たとえば、M1_1（4 番ピン）を

マイコンのピンはリセット後、すべ
て入力になります。出力として使用し
たいピンは出力モードに初期化する必
要があります。
ソフトウェアで‘H’/’L’を都度設定
するものは OUTPUT、PWM 出力す
るものは PWM_OUTPUT に設定し
ます。

図 11 はサンプルプログラム中のモ
ーター関連のピン初期化部分を抜き出
したものです。
M1_1 や M1_2 等は
pinMode(ピン番号,OUTPUT);
M1_PWM や M2_PWM は
pinMode(ピン番号,PWM_OUTPUT);
と初期化します。

- 19 -

LOW にしたいなら、
digitalWrite(M1_1、0);
というように記述します。
Arduino-IDE では 0 が LOW、1
が HIGH と名称定義されています
ので、
digitalWrite（M1_1, LOW）;
と記述することもできます。どち
らでも同じ動作になりますが、
HIGH や LOW を使った方が間違
えにくくて良いでしょう。

(2）前進
左右のモーターをともに前進方向
（正方向）に同じ速度で回転させると
ロボットは前進します。
モーターの回転方向が前進方向なの
で、
M1_1=M2_1=HIGH
M1_2=M2_2=LOW
と設定します。
回転速度は analogWrite()によって
PWM 出力の ON 期間の比率を設定
します。サンプルプログラムでは

analogWrite(M1_PWM,120);
analogWrite(M2_PWM,120);
という具合にして、両方の速度を 120
に設定しています。

(3）左回転（超信地旋回）
SmallBot の車輪の回転方向や速度は
左右独立して設定できます。
左右の車輪の同じ速度で逆向き（片
方を前進方向、他方を後退方向）に回
転させると、ロボットは車軸の中央部
分を軸にして旋回します。これを超信
地旋回とも呼びます。
左（反時計回り）に超信地旋回させ
たいときは、右の車輪を前進方向、左
の車輪を後退方向に回転させます。
プログラムでは図のように、
M1_1= HIGH、M1_2=LOW
M2_1=LOW、M2_2=HIGH
と設定しています。回転速度は左右と
も同じ値にします。値を大きくするほ
ど回転する速度も速くなりますが、サ
ンプルプログラムでは直進時と同じ値
（120）に設定しています。
サンプルプログラムではダンゴムシ
（超音波距離センサによる障害物回
避）やダンス（音声入力による方向転
換）モードの時の方向転換に超信地旋
回を使用しています。

なお、プログラムは上から順に実行さ
れますので、厳密に言えば、片方のピ
ンの設定をしてからもう一方のピンの
設定をするまでの間にわずかな時間差
がありますが、マイコンの動作はモー
ターの応答時間よりも十分に高速なの
で同時に設定されると考えても問題あ
りません。

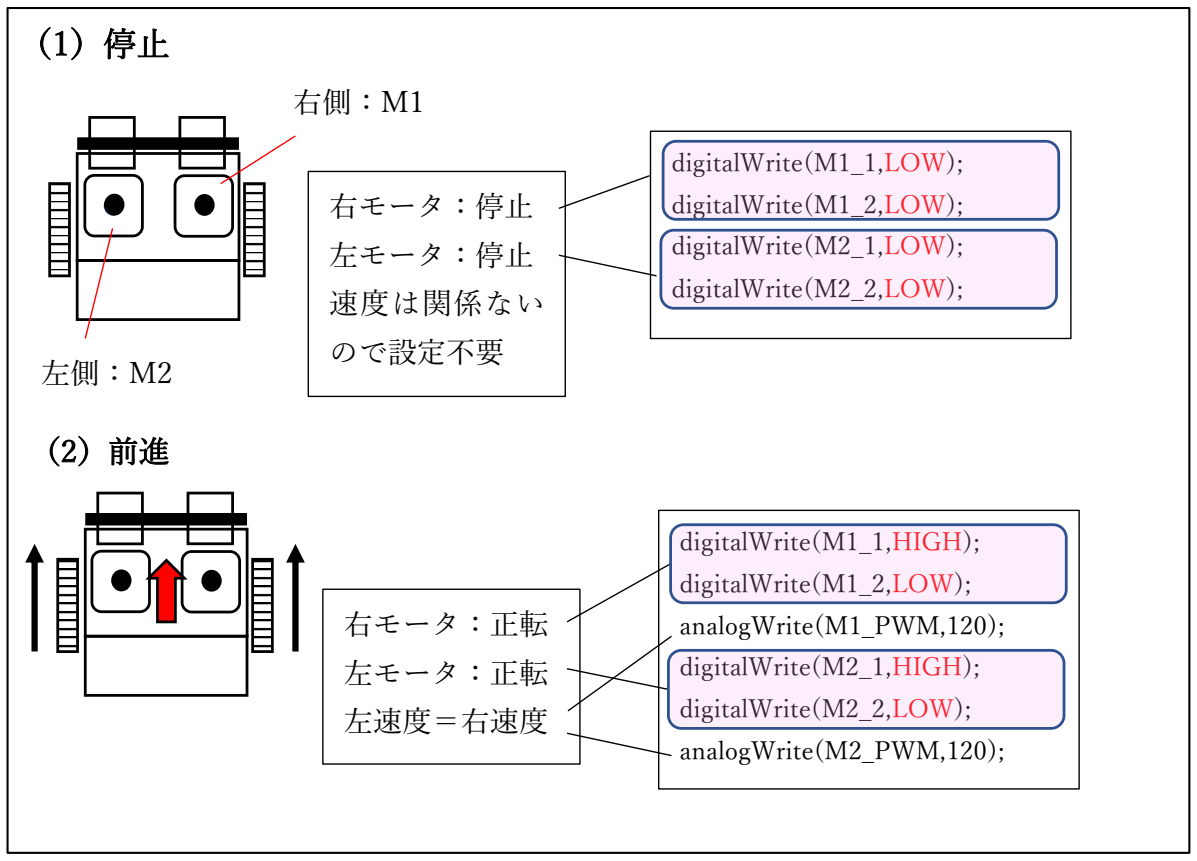
[picture p83: figure]
右モータ：正転; 左モータ：正転; 左速度＝右速度; digitalWrite(M1_1,HIGH);; digitalWrite(M1_2,LOW);; analogWrite(M1_PWM,120);; digitalWrite(M2_1,HIGH);; digitalWrite(M2_2,LOW);; analogWrite(M2_PWM,120);; 右モータ：停止; 左モータ：停止; 速度は関係ない; ので設定不要; digitalWrite(M1_1,LOW);; digitalWrite(M2_1,LOW);

- 20 -

図 12：モータードライバの設定とロボットの移動方向(1/3)

(4）右回転（超信地旋回）
車輪の回転方向を左回転の時と逆、
つまり右の車輪を後退方向、左の車輪
を前進方向に回転させるとロボットは
その場で右回転（時計回り）します。

(5）左旋回
左右の車輪を前進方向に回転させる
と、ロボットは前進しますが、このと
き回転数に差があると、直線的には進
まず、回転数の差に応じた半径の円を
描くように前進します。

差が少なければ半径は大きくなり、
差が大きければ半径は小さくなりま
す。
右の車輪が左の車輪よりも速く回転
すれば、ロボットは左回り（反時計回
り）の円を描くように移動していきま
す。
サンプルプログラムではフォトセン
サを使って床に描かれた線を辿るライ
ントレースモードのときに旋回動作を
利用しています。
PWM の設定値は

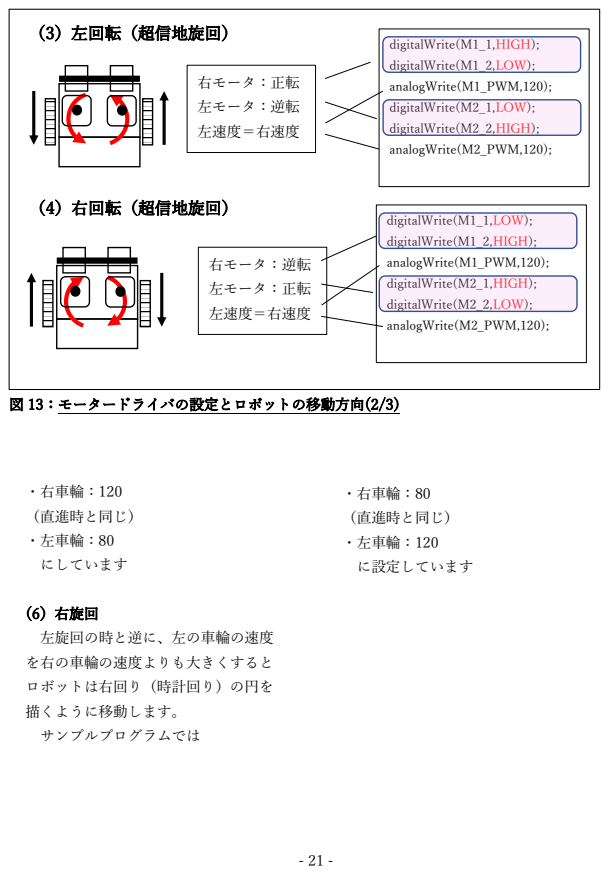
[picture p84: page 21]
図 13：モータードライバの設定とロボットの移動方向(2/3); digitalWrite(M1_1,HIGH);; digitalWrite(M1_2,LOW);; analogWrite(M1_PWM,120);; digitalWrite(M2_1,LOW);; digitalWrite(M2_2,HIGH);; analogWrite(M2_PWM,120);; 右モータ：逆転; 左モータ：正転; 左速度＝右速度; 右モータ：正転; 左モータ：逆転; （4）右回転（超信地旋回）; digitalWrite(M1_1,LOW);; digitalWrite(M1_2,HIGH);; digitalWrite(M2_1,HIGH);; digitalWrite(M2_2,LOW);; （3）左回転（超信地旋回）; ・右車輪：120; （直進時と同じ）; ・左車輪：80; にしています; ・右車輪：80; ・左車輪：120; に設定しています

(6）右旋回
左旋回の時と逆に、左の車輪の速度
を右の車輪の速度よりも大きくすると
ロボットは右回り（時計回り）の円を
描くように移動します。
サンプルプログラムでは

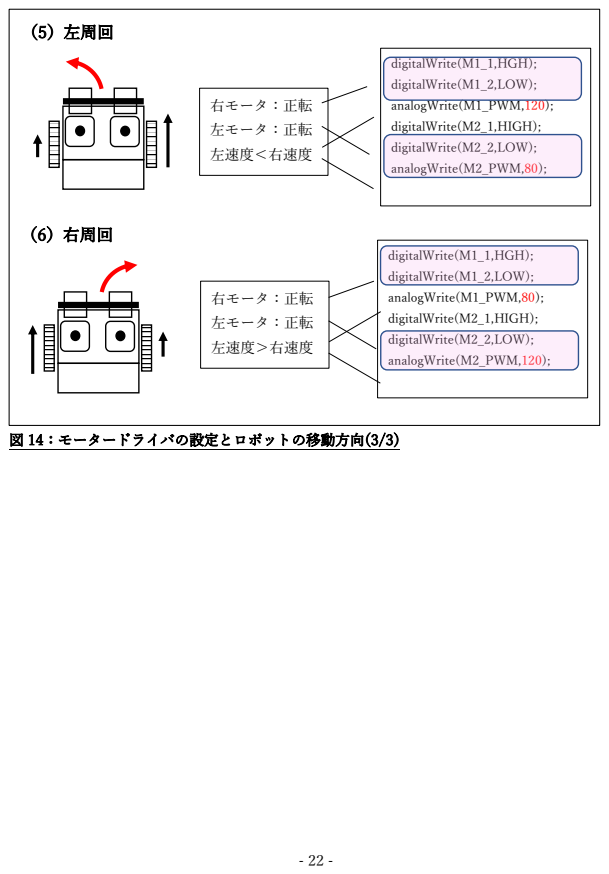
[picture p85: page 22]
図 14：モータードライバの設定とロボットの移動方向(3/3); （5）左周回; （6）右周回; 右モータ：正転; 左モータ：正転; 左速度＜右速度; 左速度＞右速度; digitalWrite(M1_1,HGH);; digitalWrite(M1_2,LOW);; analogWrite(M1_PWM,120);; digitalWrite(M2_1,HIGH);; digitalWrite(M2_2,LOW);; analogWrite(M2_PWM,80);; analogWrite(M1_PWM,80);; analogWrite(M2_PWM,120);

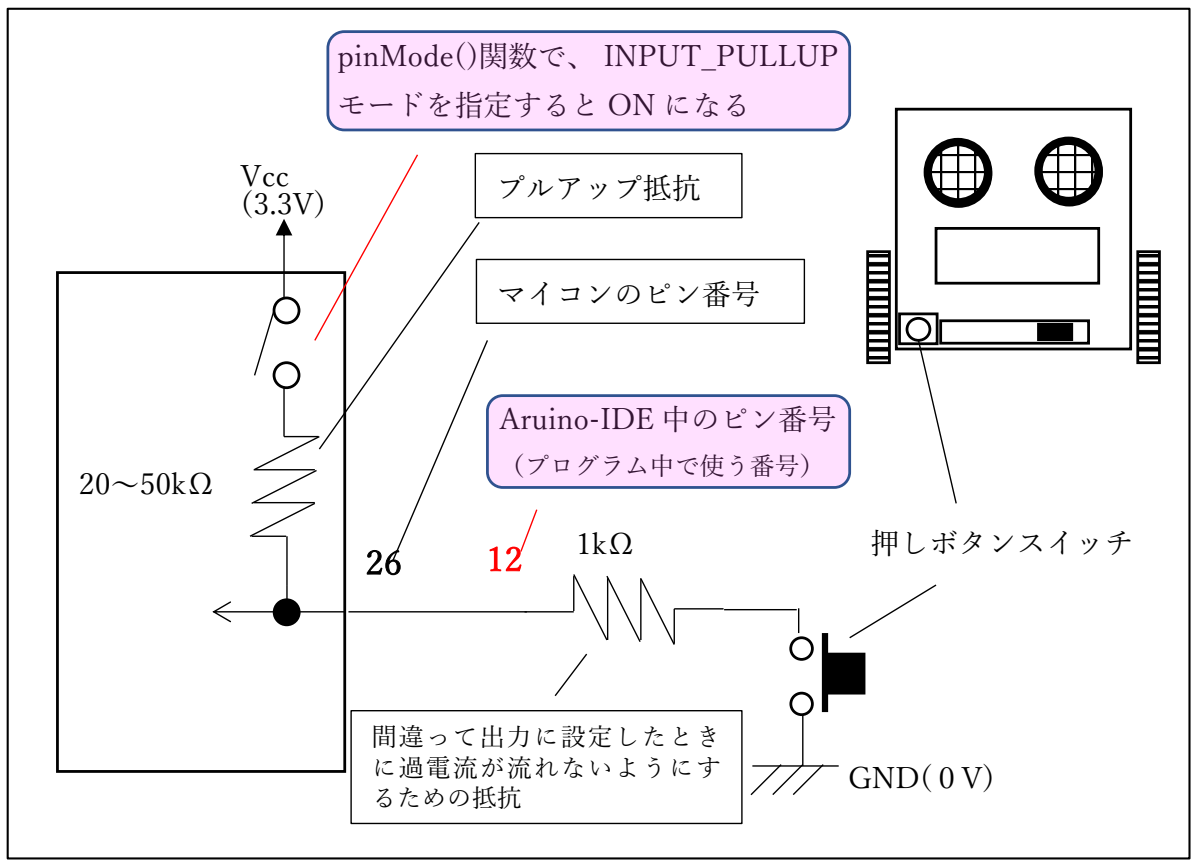
[picture p86: figure]
押しボタンスイッチ; Vcc (3.3V); pinMode()関数で、 INPUT_PULLUP; モードを指定すると ON になる; プルアップ抵抗; Aruino-IDE 中のピン番号; （プログラム中で使う番号）; マイコンのピン番号; 間違って出力に設定したとき に過電流が流れないようにす; るための抵抗; GND(０V)

- 23 -
3. スイッチ入力
3.1. スイッチ入力のハードウェア
3.1.1. スイッチ入力回路

図 15 は SmallBot の押しボタンス
イッチ（ロボットの正面パネルの左下
隅のところにあります）の配置と入力
回路を示したものです。
スイッチは図の右側のように正面左
下にあり、回路上では Arduino-IDE
上のプログラム中の 12 番ピン（マイ
コンの 26 番ピン）に接続されていま

す。スイッチは通常 OFF 状態で、ボ
タンを押すと ON になります。
マイコン内部にはプルアップ抵抗が
あり、ピンのモード設定で Vcc と接続
／切断することができるようになって
おり、スイッチ入力として使うときは
これを ON にします。

図 15：SmallBot の押しボタンスイッチ入力回路

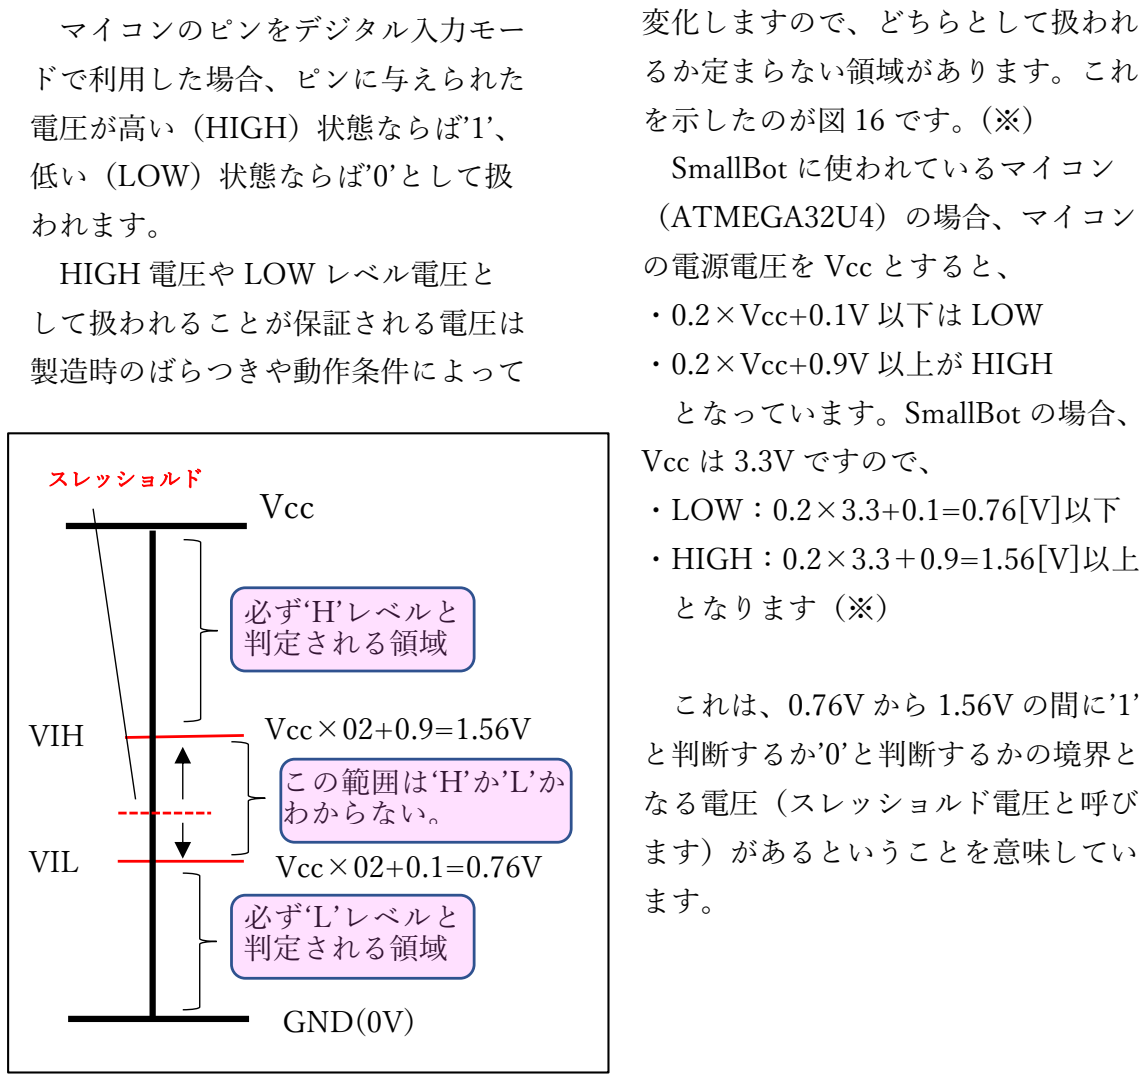
[picture p87: figure]
マイコンのピンをデジタル入力モー; ドで利用した場合、ピンに与えられた; 電圧が高い（HIGH）状態ならば’1’、; 低い（LOW）状態ならば’0’として扱; われます。; HIGH 電圧や LOW レベル電圧と; して扱われることが保証される電圧は; 製造時のばらつきや動作条件によって; 変化しますので、どちらとして扱われ; るか定まらない領域があります。これ; を示したのが図 16 です。(※); SmallBot に使われているマイコン; （ATMEGA32U4）の場合、マイコン; の電源電圧を Vcc とすると、; ・0.2×Vcc+0.1V 以下は LOW; ・0.2×Vcc+0.9V 以上が HIGH; となっています。SmallBot の場合、; Vcc は 3.3V ですので、; ・LOW：0.2×3.3+0.1=0.76[V]以下; ・HIGH：0.2×3.3＋0.9=1.56[V]以上; となります（※）; これは、0.76V から 1.56V の間に’1’; と判断するか’0’と判断するかの境界と; なる電圧（スレッショルド電圧と呼び; ます）があるということを意味してい; Vcc; GND(0V); Vcc×02+0.1=0.76V; Vcc×02+0.9=1.56V; この範囲は‘H’か’L’か わからない。; 必ず‘H’レベルと 判定される領域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

- 24 -
3.1.2. HIGH/LOW 判定

※：データシートなどでは、LOW レベルと
判断される電圧の上限を VIL、HIGH レベ
ルの下限を VIH と表記しています。

図 16 入力電圧と HIGH/LOW 判定

※：入力電圧が VIL と VIH の間にある場
合、動作条件などにより HIGH と LOW の
どちらとして判断されるかはわかりません
ので、ハードウェア設計時は入力電圧がこ
の範囲にならないようにしたり、この範囲
に入っても動作に大きな問題がでないよう
に気をつける必要があります。

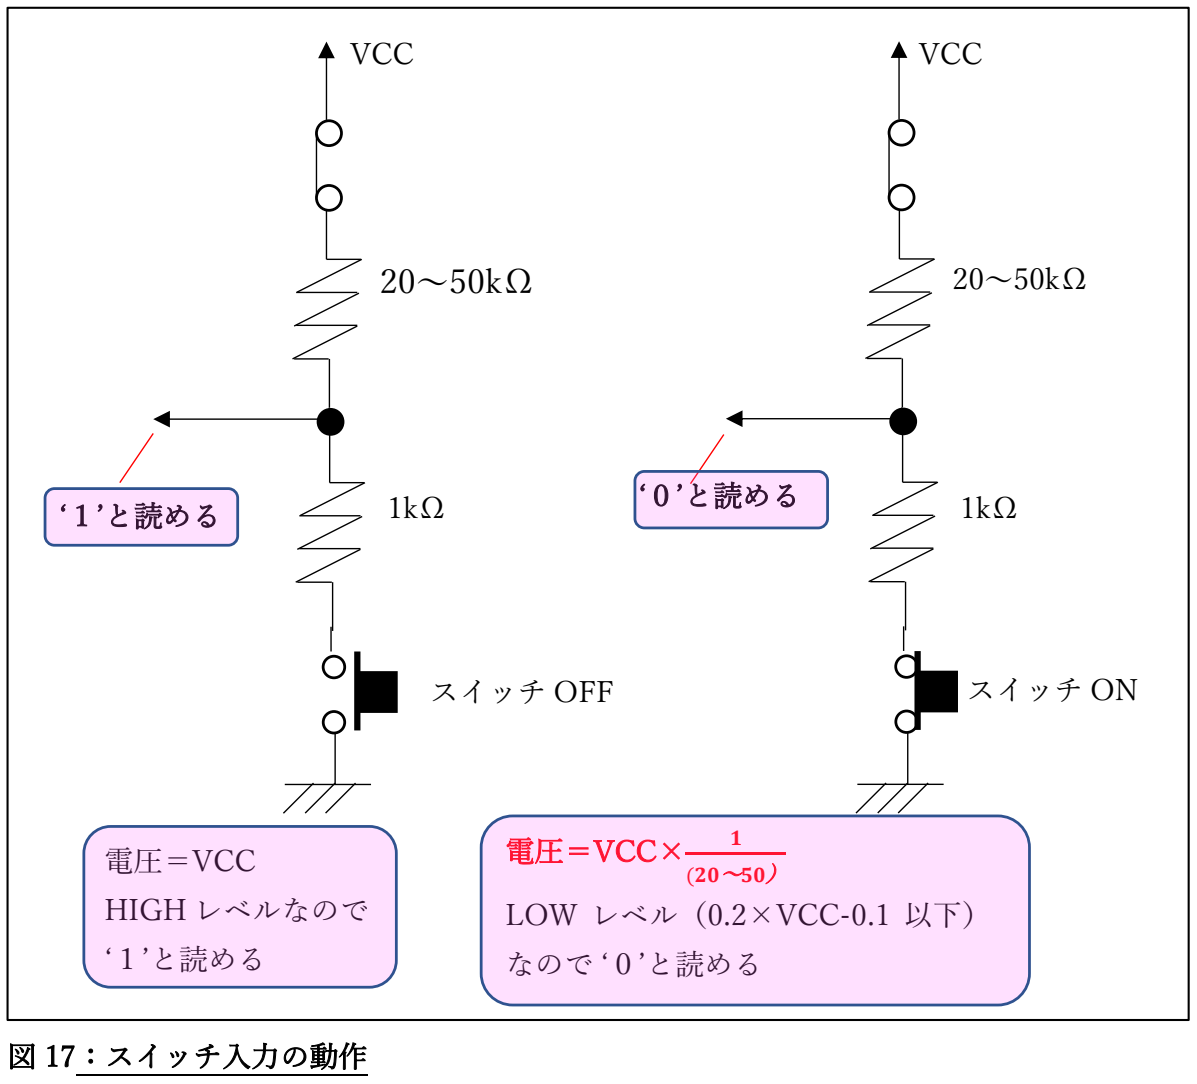
[picture p88: figure]
VCC; 電圧＝VCC; HIGH レベルなので; ‘１’と読める; 電圧＝VCC×; (20～50） LOW レベル（0.2×VCC-0.1 以下）; なので ‘０’と読める; ‘０’と読める; スイッチ OFF; スイッチ ON; 図 17：スイッチ入力の動作

- 25 -
3.1.3. スイッチ入力回路の動作

スイッチが OFF の場合、プルアッ
プ抵抗によってピンの電圧はほぼ Vcc
（3.3V）になります。VIH の下限の
1.56V よりも高いため、HIGH と判定
されます。
スイッチが ON の時は内部プルア
ップ抵抗と 1kΩの抵抗で分圧された
電圧になります。

図 17 はスイッチを ON/OFF した
ときの動作を示したものです。
先ほど触れたとおり、マイコンの
入力ピンはデジタル入力モードに設
定すると、入力電圧が高い（HIGH）
ときには‘１’、低い（LOW）時に
は’0’として読みだされます。

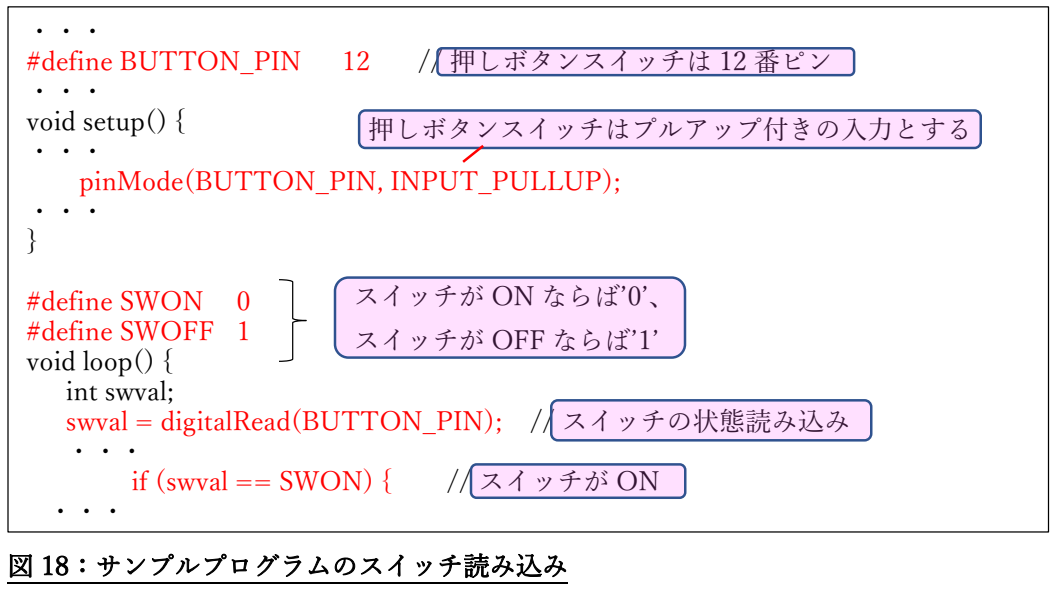
[picture p89: figure]
#define BUTTON_PIN; // 押しボタンスイッチは 12 番ピン; ・・・ void setup() { ・・・ pinMode(BUTTON_PIN, INPUT_PULLUP); ・・・ }; #define SWON; #define SWOFF 1 void loop() { int swval; swval = digitalRead(BUTTON_PIN); // スイッチの状態読み込み ・・・; if (swval == SWON) {; // スイッチが ON; 押しボタンスイッチはプルアップ付きの入力とする; 図 18：サンプルプログラムのスイッチ読み込み; スイッチが ON ならば’0’、; スイッチが OFF ならば’1’

- 26 -
3.2. スイッチ入力のソフトウェア

≒0.16[V]
これは VIL の 0.76V よりも低いので
LOW と判定されます。
つまり、スイッチが
・OFF ならば HIGH（‘1’）
・ON ならば LOW（’0’）
になるわけです。

内部プルアップ抵抗の値は 20kΩ～
50kΩとなっています。仮に ON 時の
電圧が最も高くなる 20kΩとすると、
スイッチが ON の時の入力電圧 Vin
は次のように算出されます。
Vin= １

（２０＋１）

×Vcc

=

１

（２０＋１）

| ×3.3

PinMode（）の第二引数のモード
設定で INPUT_PULLUP にします。
第一引数はピン番号の指定です。
スイッチ読み込み用ポートは 12 番で
す。サンプルでは#define 文を使って
BUTTON_PIN という名称でアクセ

図 18 はサンプルプログラムからス
イッチの読み込みに関係する部分を
抜き出してみたものです。
スイッチの読み込みに使うポート
はプルアップ抵抗付を ON にします
ので、

- 27 -

スできるようにしています。
なお、プルアップ抵抗を使用しな
い（プルアップを OFF にする）場合
は第二引数を“INPUT”にします。
(※)
ピンの状態の読み込みは pinRead()
関数を使用します。第一引数でピン
番号を指定すると、戻り値でピンの
状態（スイッチの状態）が返されま
す。戻入力が HIGH なら１、LOW
ならば 0 が戻り値になります。
SmallBot のスイッチ入力回路では
スイッチが OFF でピンが HIGH、
ON になると LOW になりますので、

・スイッチが OFF ならば１
・スイッチが ON ならば０
となります。

たとえばスイッチが ON のときに
何らかの処理をするような場合であ
れば、
#define SWON 0

swdat = pinRead(BUTTON_PIN); if (swdat == SWON) {
スイッチが ON の時の処理
}
という具合にすればよいわけです。

※：リセット後は自動的に INPUT になりま
すので、INPUT のまま使うならば設定は省
略可能です。

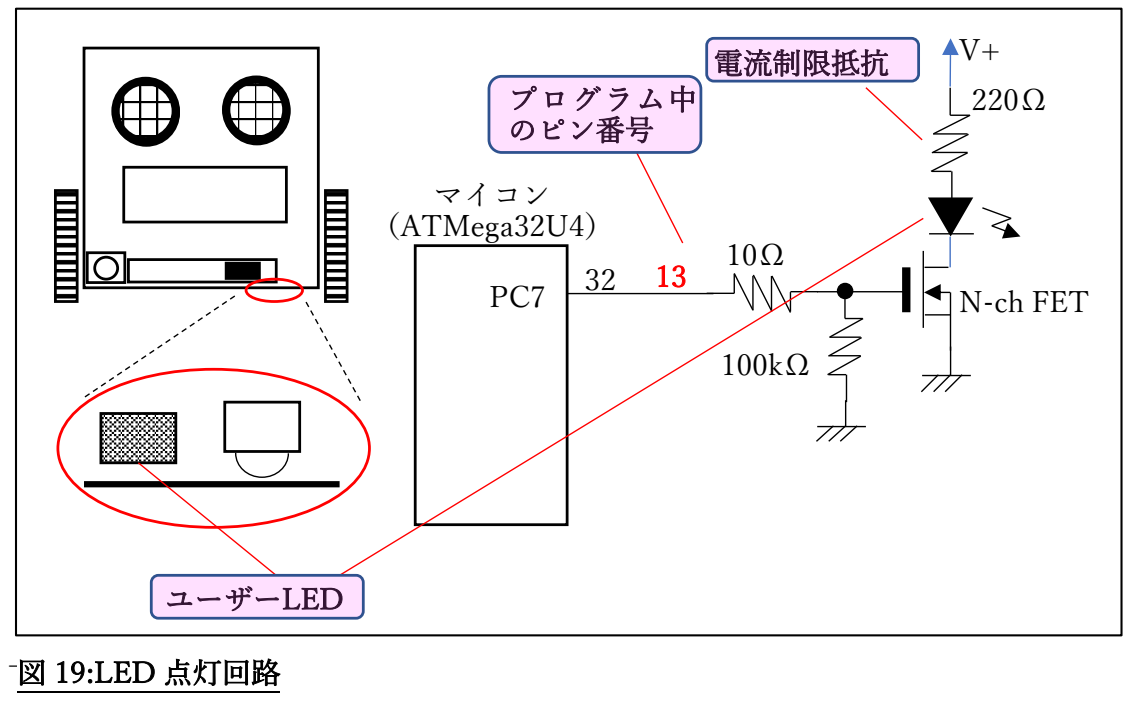
[picture p90: figure]
マイコン （ATMega32U4）; プログラム中 のピン番号; ユーザーLED; N-ch FET; 電流制限抵抗; 図 19:LED 点灯回路

- 28 -
4. LED
4.1. LED 出力のハードウェア
4.1.1. LED 点灯回路

LED(Light Emission Diode：発光 ダイオード)は、回路の信号の状態を
目視確認したり、ソフトウェアの動
作状態を表示するなど、システムの
動作状態を示す表示器として広く利

用されています。
SmallBot に使われている LED の 1
つがユーザが自由に ON/OFF(点灯／
消灯)できるものになっています。発
光色は白色です。

図 19 は SmallBot 上でユーザが自
由に利用可能な LED（以下、ユーザ
LED と略します）の位置と点灯回路
を示した物です。
ユーザ LED はロボットの右下のと
ころにあります。ライントレースす
るときに床を照らすためにも利用し
ています。

回路上では ArduinoIDE 上の 13 番
ピン（マイコンの PC7:32 番ピン）に
接続されています。
ユーザ LED に使われている白色
LED はマイコンの I/O ポートで直接
駆動することが難しいため、FET を
追加しており、ポートが HIGH の時
に点灯するようになっています。

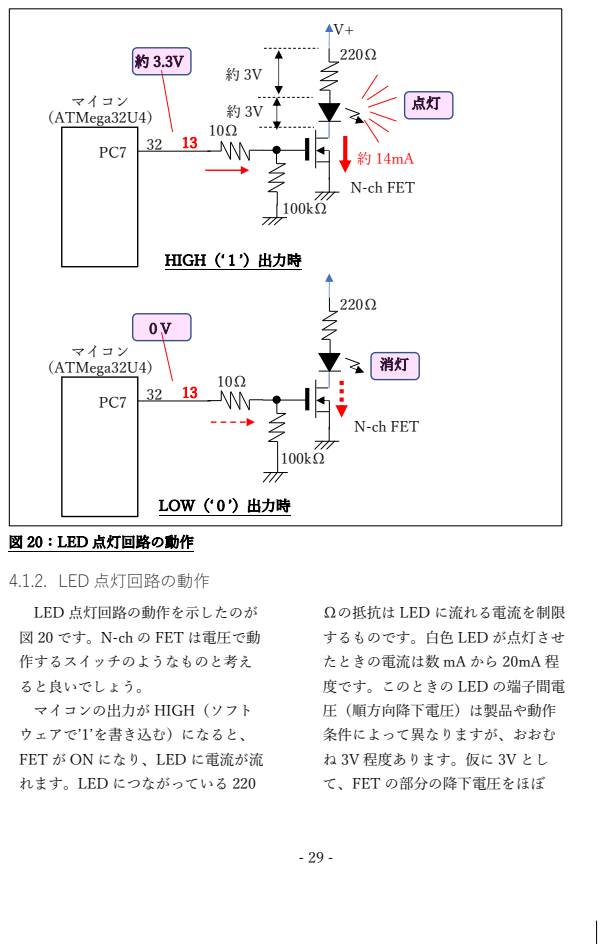
[picture p91: page 29]
4.1.2. LED 点灯回路の動作; マイコン （ATMega32U4）; N-ch FET; HIGH（‘１’）出力時; LOW（‘０’）出力時; 図 20：LED 点灯回路の動作

LED 点灯回路の動作を示したのが
図 20 です。N-ch の FET は電圧で動
作するスイッチのようなものと考え
ると良いでしょう。
マイコンの出力が HIGH（ソフト
ウェアで’1’を書き込む）になると、
FET が ON になり、LED に電流が流
れます。LED につながっている 220

Ωの抵抗は LED に流れる電流を制限
するものです。白色 LED が点灯させ
たときの電流は数 mA から 20mA 程
度です。このときの LED の端子間電
圧（順方向降下電圧）は製品や動作
条件によって異なりますが、おおむ
ね 3V 程度あります。仮に 3V とし
て、FET の部分の降下電圧をほぼ

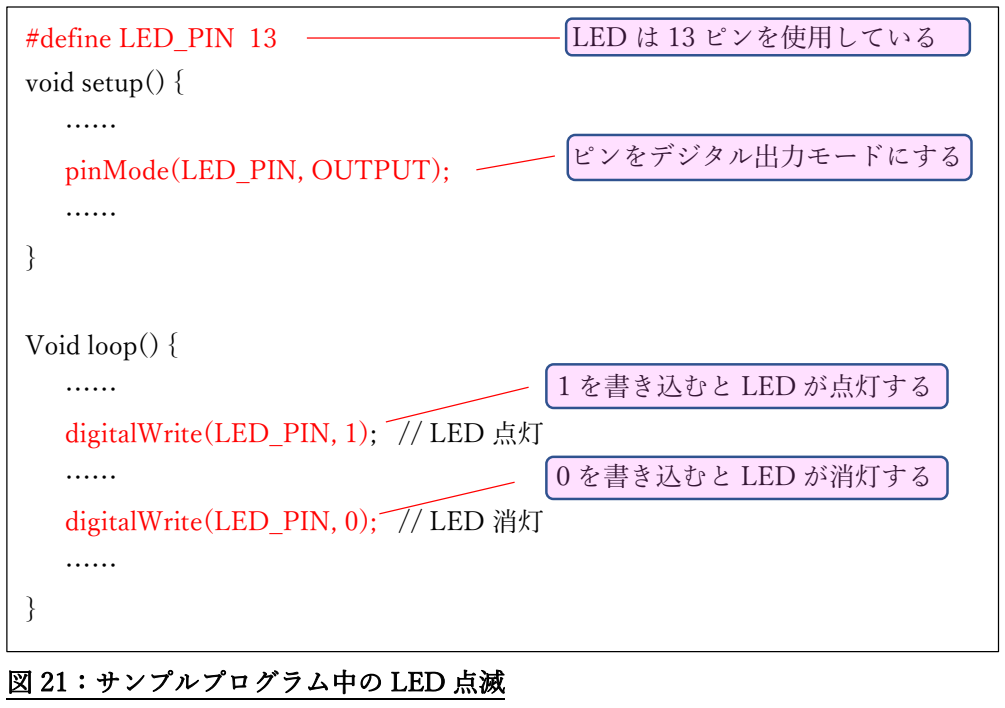
[picture p92: figure]
#define LED_PIN 13; void setup() {; pinMode(LED_PIN, OUTPUT);; Void loop() {; digitalWrite(LED_PIN, 1); // LED 点灯; digitalWrite(LED_PIN, 0); // LED 消灯; 図 21：サンプルプログラム中の LED 点滅; LED は 13 ピンを使用している; ピンをデジタル出力モードにする; １を書き込むと LED が点灯する; ０を書き込むと LED が消灯する

- 30 -
4.2. LED 点灯ソフトウェア

0V、電源電圧を 6V とすると、図の
ように 220Ωの抵抗の端子間電圧は
3V となります。
ここから LED に流れる電流（抵抗
を流れる電流と同じ）は

３

２２０

≒0.014[A] = 14[mA]

となります。
マイコンの出力が LOW（ソフトウ
ェアで’0’を書き込む）のときは FET
が OFF 状態になりますので、LED に
電流は流れず、消灯します。

図 21 はサンプルプログラムから
LED 点滅部分に関係する部分を切り
出したものです。
LED は Arduino-IDE 上の 13 番ピ ンに接続されていますので
pinMode()関数で 13 ピンのモードを

OUTPUT に設定しています。
digitalWrite()がピンへの出力を行
う関数で、第一引数でピン番号（今
回は 13）、第二引数は、LED を点灯
するときは１を、消灯するときは０
を与えます。

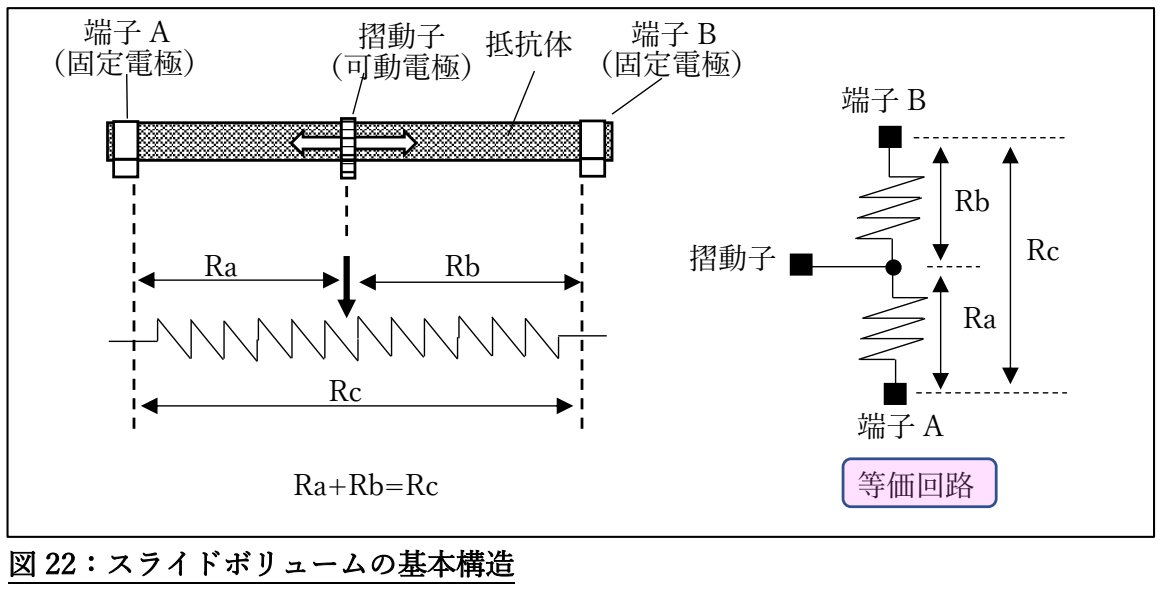
[picture p93: figure]
抵抗体 （固定電極）; 摺動子 （可動電極）; 端子 B （固定電極）; 摺動子; 等価回路; 図 22：スライドボリュームの基本構造

- 31 -
5. スライドボリューム（可変抵抗器）

スライドボリュームはツマミの位
置を左右に動かすことで抵抗値を変
化させることができる部品で、「可変
抵抗器」と呼ばれるものの一つで
す。SmallBot ではツマミの位置で電
圧が変化するようにして、これをマ
イコンのアナログ入力で読み取れる
ようにしています。読み取った値に
よって、ツマミの位置を判断できま
す。
サンプルプログラムでは、ダンゴ
ムシモード時の方向転換する角度の
調整や、ダンスモードの時の音量レ
ベル設定、ライントレース時に線の
色の白黒の区別をするレベルを設定
するのに使用しています。
スライドボリュームの基本的な構
造は図 22 のようになっています。

電気抵抗の大きなもの（抵抗体）
が塗布された棒状の物の両端に端子
（固定電極）が取り付けられていま
す。この棒の上を移動できる摺動子
と呼ばれる電極が移動します。
摺動子の位置を変化させると、固
定電極との間の抵抗値が変化しま
す。
スライドボリュームの等価回路は
図の右側のようになります。、抵抗体
の両端の抵抗 Rc、図の端子 A と摺動
子の間の抵抗を Ra、端子 B と摺動子
の間の抵抗を Rb とすると、
Rc＝Ra＋Rb（=一定）
0≦Ra≦Rc
0≦Rb≦Rc
という関係が成り立ちます。

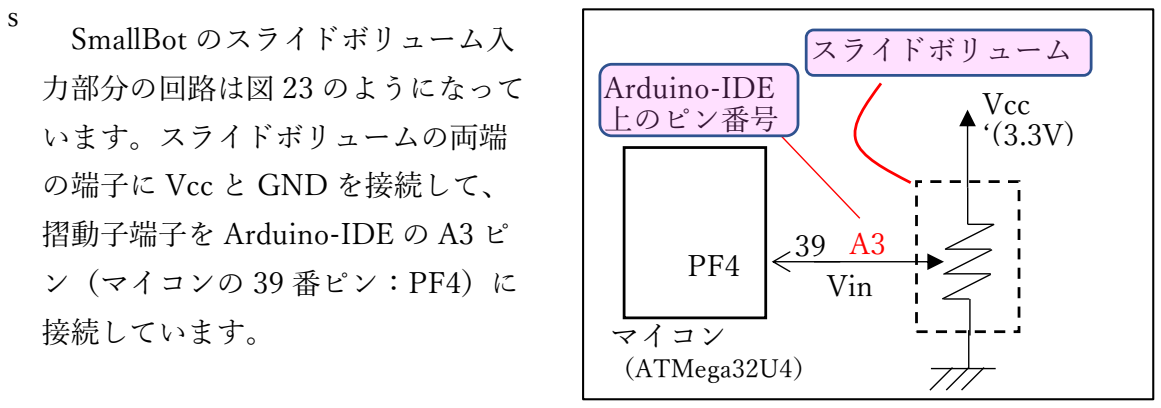
[picture p94: figure]
Vcc ‘(3.3V); マイコン （ATMega32U4）; Arduino-IDE 上のピン番号; Vin; SmallBot のスライドボリューム入; スライドボリューム; 力部分の回路は図 23 のようになって; います。スライドボリュームの両端; の端子に Vcc と GND を接続して、; 摺動子端子を Arduino-IDE の A3 ピ; ン（マイコンの 39 番ピン：PF4）に; 接続しています。

- 32 -
5.1. スライドボリューム入力のハードウェア
5.1.1. スライドボリューム入力回路
5.2. スライドボリューム入力回路の動作

図 23：スライドボリューム入力回路

スライドボリュームの摺動子を動
かしたときの動作を示したのが図 24
です。スライドボリュームは図の右
側のように二つの抵抗で表すことが
できます。摺動子を動かすと Ra と
Rb の比率が変化します。
摺動子の電圧 Vin を Vcc、Rc、Ra
を使って表すと
Vin=Ra
Rc

× Vcc
=

Vcc
Rc

× Ra (0≦Ra≦Rc)
となります。
この式の中の Vcc は電源電圧ですか
ら一定値（SmallBot では 3.3V）です
し、Rc はスライドボリュームの製品
によって決まっています（製品の仕
様には Rc の値が記載されていま
す）。

従って、Vcc
Rc の部分は定数になりま

すので、これを k と表せば
Vin = k × Ra (kは比例定数)

という式と同じです。つまり、Ra と
Vin は比例するわけです。

たとえば、Vcc が 3.3V で、Rc が
5kΩ、摺動子が GND 側から測って
2kΩの位置にあれば、

Vin =

3.3
5×10³ × 2 × 10³

= 1.32[V]
となります。

Ra と Vin の関係をグラフで示した
のが図 25 です。 Ra が 0[Ω]から
Rc[Ω]まで変化すれば、Vin は 0V
（GND）から Vcc まで変化すること
になります。

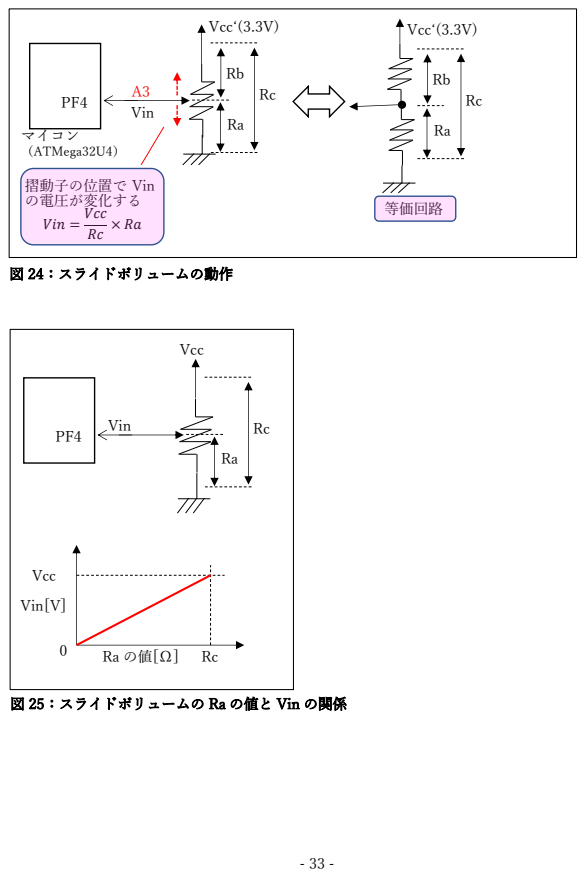
[picture p95: page 33]
Vin; Vin[V]; Vcc; Vcc‘(3.3V); マイコン （ATMega32U4）; Vin =; Vcc Rc; 摺動子の位置で Vin の電圧が変化する; 等価回路; 図 24：スライドボリュームの動作

図 25：スライドボリュームの Ra の値と Vin の関係

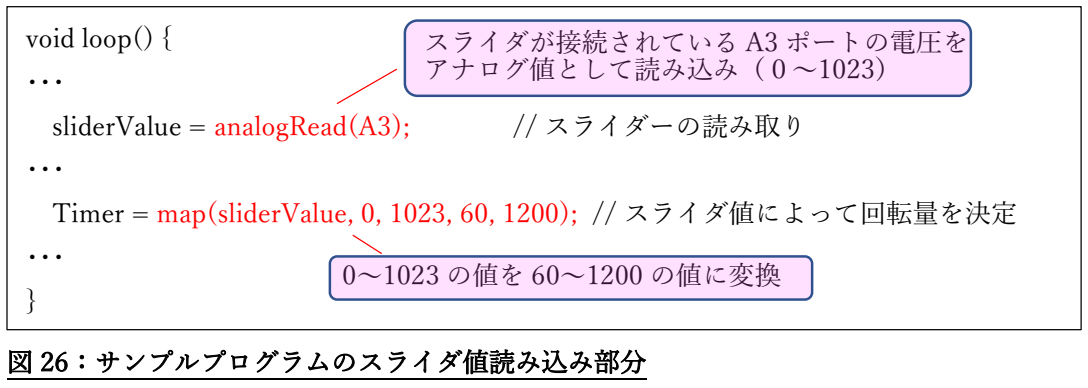
[picture p96: figure]
void loop() {; sliderValue = analogRead(A3);; // スライダーの読み取り; スライダが接続されている A3 ポートの電圧を アナログ値として読み込み（０～1023）; 図 26：サンプルプログラムのスライダ値読み込み部分; 0～1023 の値を 60～1200 の値に変換

- 34 -
5.2.1. スライドボリューム読み込みソフトウェア
5.2.2. map()関数

図 26 はサンプルプログラム中のス
ライダの値読み込み部分を切り出し
てきたものです。
デフォルトで I/O ピンは入力モー
ドになりますので、LED 点灯の時の
ように pinMode()でピンの動作モー
ドを設定する必要はありません。
入力値はスイッチ入力のようなデ
ジタル値（1 か 0 か）ではなく、アナ
ログ値として読み込みます。これに
は analgoRead()関数を使用します。
analogRead()関数の引数にはピン
番号（スライダの場合は“A3”）を指

定します。
analogRead()の戻り値が入力電圧
を表す値です。SmallBot の場合、ア
ナログ値は 0～1023 の範囲の値にな
り、入力が 0V なら 0、Vcc の時は
1023 が返されます。
戻された値を Val、電源電圧を Vcc
とすると、入力電圧 Vin は

Vin= Vcc
1023

×Val [V]
となります。Vcc が 3.3V ならば、

3.3
1023 ≒ 0.0032
ですので、約 3.2mV 単位で入力電
圧を算出できます。

Timer = map(sliderValue, 0, 1023, 60, 1200); // スライダ値によって回転量を決定

map()関数はアナログ入力とは直接
関係ありませんが、サンプルプログ
ラム中でアナログ値の変換用として
利用されていますので、ここで説明
しておきましょう。
図 27 は map()関数による値の変換

動作を図示したものです。
map()関数は第二、第三引数で指定
された範囲の値（この例では 0～
1023）が第四、第五引数で指定した
範囲（この例では 60～1200）になる
ような規則に従って第一引数の値

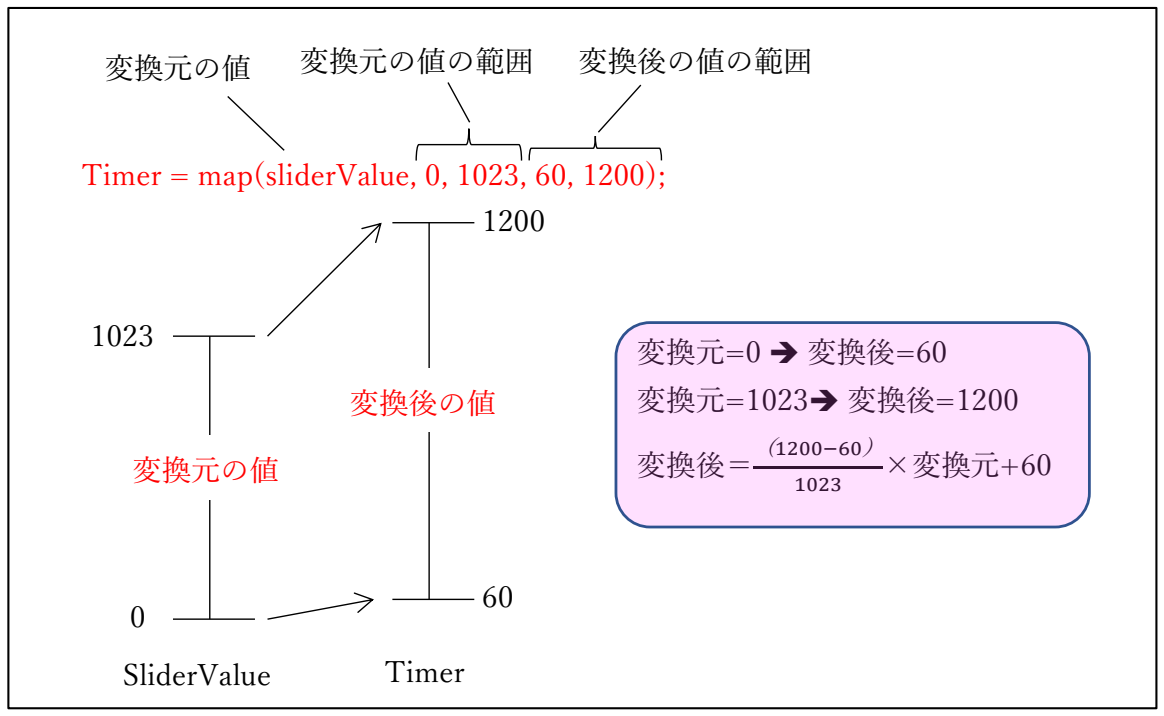
[picture p97: figure]
変換元の値; 変換後の値; 変換元=0 ➔ 変換後=60; 変換元=1023➔ 変換後=1200; 変換後＝（1200−60）; ×変換元+60; 変換元の値の範囲; 変換後の値の範囲; SliderValue; Timer

- 35 -

図 27：map()関数による値の変換

6. フォトセンサ

Timer = map(sliderValue, 0, 1023, 60, 1200);

フォトセンサは周囲の明るさの計
測を行ったり、LED などの光源と組
み合わせて障害物の有無を判定した
り、光を使ったデータ通信など様々

な用途で使われています。暗くなっ
たら点灯するライトや、赤外線を使
った自動ドア、赤外線リモコンなど
もフォトセンサの応用です。

（この例では SliderValue）を変換し
ます。変換後の値は関数の戻り値と
して返されます。図のように
map(sliderValue, 0, 1023, 60, 1200); ならば変換規則は

1200−60
1023−0

× SliderValue

=

1140
1023 × SliderValue + 60

となります。
なお、サンプルプログラム中の 60
や 1200 という値は実際にロボットを
動かしながら試行錯誤して決めた値
です。

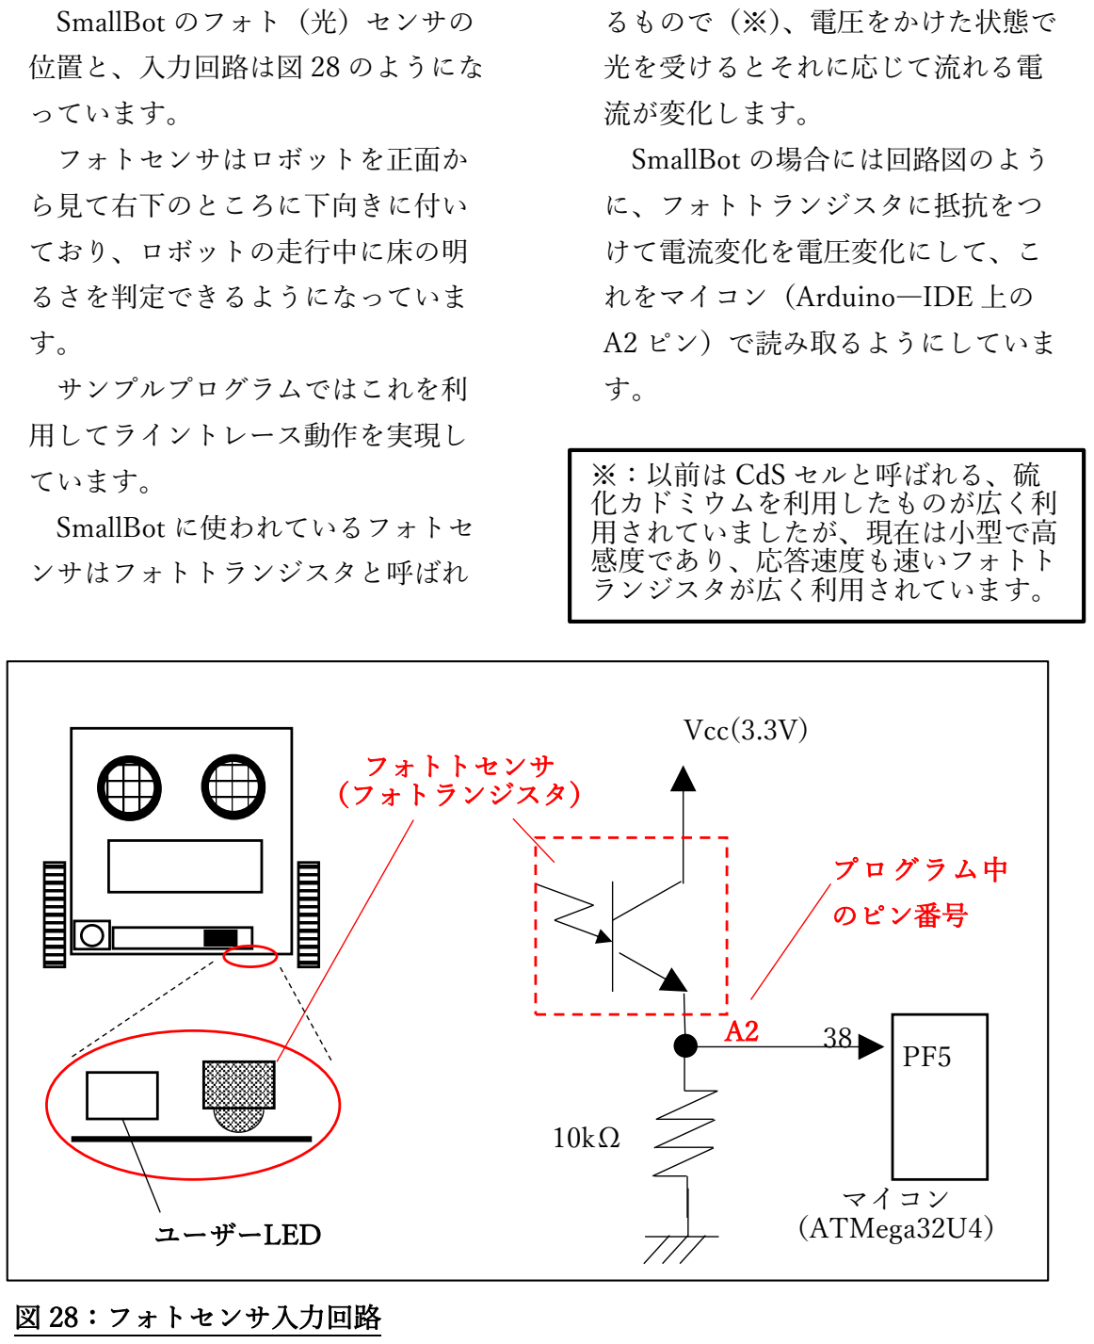
[picture p98: figure]
SmallBot のフォト（光）センサの; 位置と、入力回路は図 28 のようにな; っています。; フォトセンサはロボットを正面か; ら見て右下のところに下向きに付い; ており、ロボットの走行中に床の明; るさを判定できるようになっていま; サンプルプログラムではこれを利; 用してライントレース動作を実現し; ています。; SmallBot に使われているフォトセ; ンサはフォトトランジスタと呼ばれ; Vcc(3.3V); マイコン （ATMega32U4）; フォトトセンサ （フォトランジスタ）; プログラム中; のピン番号; ユーザーLED; 図 28：フォトセンサ入力回路; るもので（※）、電圧をかけた状態で; 光を受けるとそれに応じて流れる電; 流が変化します。; SmallBot の場合には回路図のよう; に、フォトトランジスタに抵抗をつ; けて電流変化を電圧変化にして、こ; れをマイコン（Arduino―IDE 上の; A2 ピン）で読み取るようにしていま; ※：以前は CdS セルと呼ばれる、硫 化カドミウムを利用したものが広く利 用されていましたが、現在は小型で高 感度であり、応答速度も速いフォトト ランジスタが広く利用されています。

- 36 -
6.1. SmallBot のフォトセンサのハードウェア
6.1.1. フォトセンサ回路

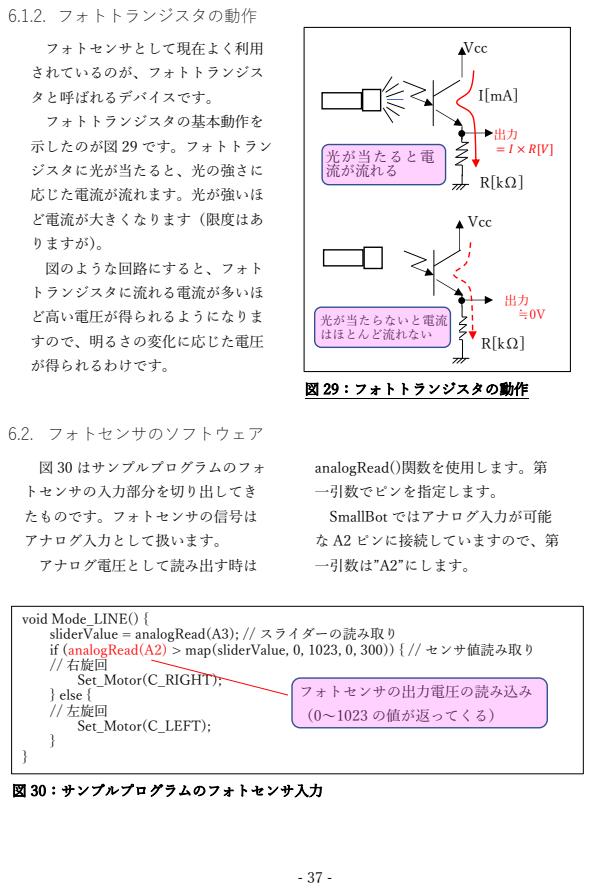
[picture p99: page 37]
6.1.2. フォトトランジスタの動作; 6.2. フォトセンサのソフトウェア; Vcc; 光が当たると電 流が流れる; 光が当たらないと電流 はほとんど流れない; 図 29：フォトトランジスタの動作; analogRead()関数を使用します。第; 一引数でピンを指定します。; SmallBot ではアナログ入力が可能; な A2 ピンに接続していますので、第; 一引数は”A2”にします。; 図 30 はサンプルプログラムのフォ; トセンサの入力部分を切り出してき; たものです。フォトセンサの信号は; アナログ入力として扱います。; アナログ電圧として読み出す時は; void Mode_LINE() { sliderValue = analogRead(A3); // スライダーの読み取り if (analogRead(A2) > map(sliderValue, 0, 1023, 0, 300)) { // センサ値読み取り // 右旋回 Set_Motor(C_RIGHT); } else { // 左旋回 Set_Motor(C_LEFT);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

フォトセンサとして現在よく利用
されているのが、フォトトランジス
タと呼ばれるデバイスです。
フォトトランジスタの基本動作を
示したのが図 29 です。フォトトラン
ジスタに光が当たると、光の強さに
応じた電流が流れます。光が強いほ
ど電流が大きくなります（限度はあ
りますが）。
図のような回路にすると、フォト
トランジスタに流れる電流が多いほ
ど高い電圧が得られるようになりま
すので、明るさの変化に応じた電圧
が得られるわけです。

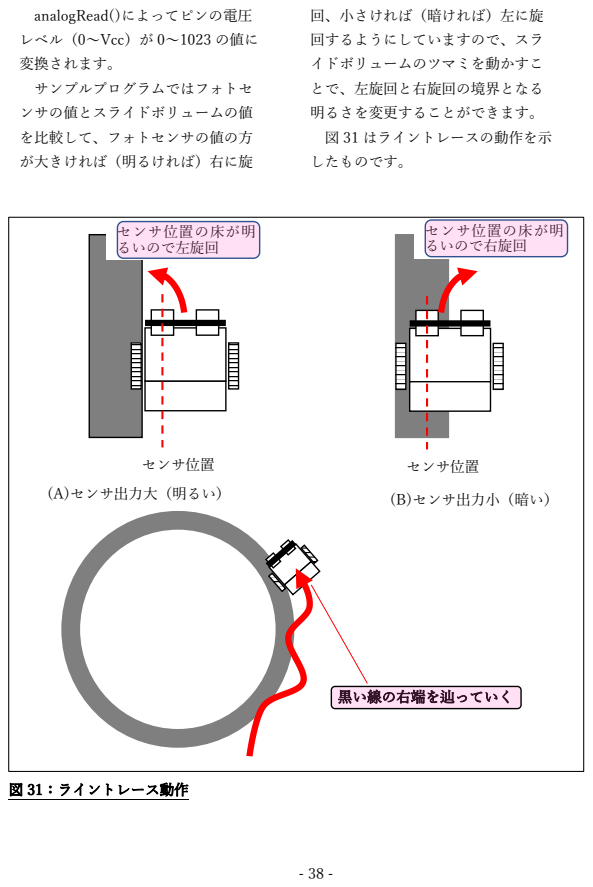
[picture p100: page 38]
センサ位置; (A)センサ出力大（明るい）; (B)センサ出力小（暗い）; 黒い線の右端を辿っていく; センサ位置の床が明 るいので左旋回; センサ位置の床が明 るいので右旋回; 図 31：ライントレース動作

analogRead()によってピンの電圧
レベル（0～Vcc）が 0～1023 の値に
変換されます。
サンプルプログラムではフォトセ
ンサの値とスライドボリュームの値
を比較して、フォトセンサの値の方
が大きければ（明るければ）右に旋

回、小さければ（暗ければ）左に旋
回するようにしていますので、スラ
イドボリュームのツマミを動かすこ
とで、左旋回と右旋回の境界となる
明るさを変更することができます。
図 31 はライントレースの動作を示
したものです。

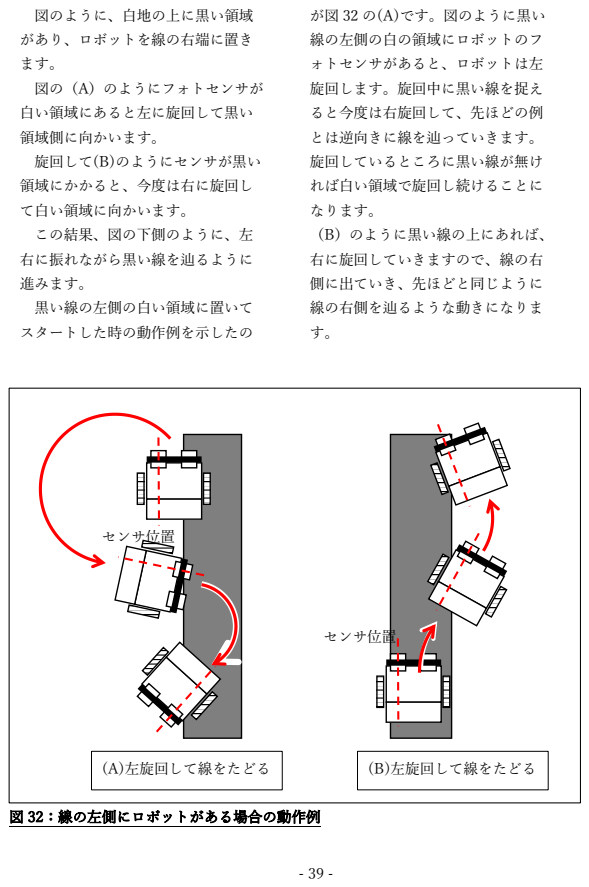
[picture p101: page 39]
図 32：線の左側にロボットがある場合の動作例; センサ位置; (A)左旋回して線をたどる; (B)左旋回して線をたどる; が図 32 の(A)です。図のように黒い; 線の左側の白の領域にロボットのフ; ォトセンサがあると、ロボットは左; 旋回します。旋回中に黒い線を捉え; ると今度は右旋回して、先ほどの例; とは逆向きに線を辿っていきます。; 旋回しているところに黒い線が無け; れば白い領域で旋回し続けることに; なります。; （B）のように黒い線の上にあれば、; 右に旋回していきますので、線の右; 側に出ていき、先ほどと同じように; 線の右側を辿るような動きになりま; 図のように、白地の上に黒い領域; があり、ロボットを線の右端に置き; 図の（A）のようにフォトセンサが; 白い領域にあると左に旋回して黒い; 領域側に向かいます。; 旋回して(B)のようにセンサが黒い; 領域にかかると、今度は右に旋回し; て白い領域に向かいます。; この結果、図の下側のように、左; 右に振れながら黒い線を辿るように; 進みます。; 黒い線の左側の白い領域に置いて; スタートした時の動作例を示したの

- 40 -

線の太さ、ロボットの初期位置や
進行させたい方向に対する角度、ロ
ボットの旋回時の半径などの条件に
よっては線の右側から左側に飛び出
して行ってしまうなど、いろいろな
ケースが考えられます。

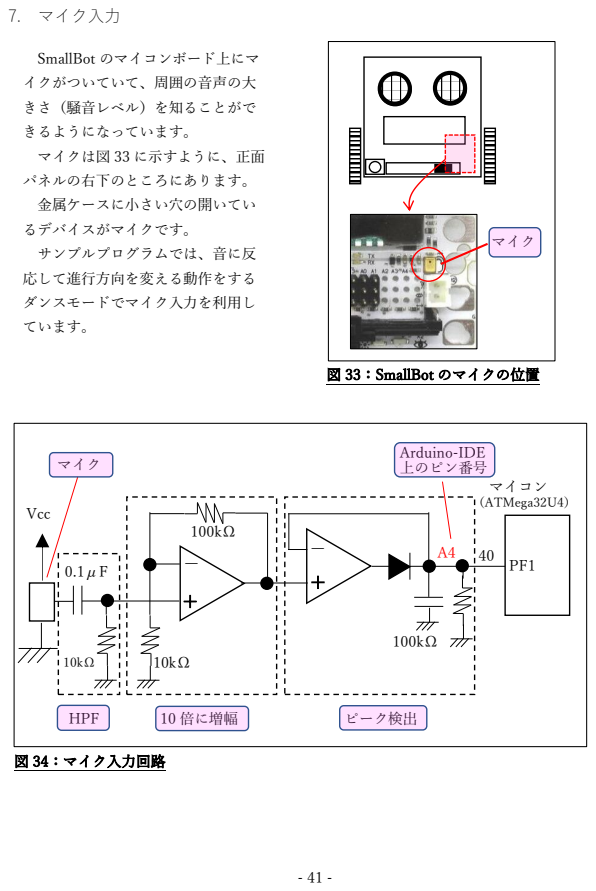
[picture p102: page 41]
7. マイク入力; マイク; 図 33：SmallBot のマイクの位置; Vcc; マイコン （ATMega32U4）; Arduino-IDE 上のピン番号; HPF; 10 倍に増幅; ピーク検出; 図 34：マイク入力回路

SmallBot のマイコンボード上にマ
イクがついていて、周囲の音声の大
きさ（騒音レベル）を知ることがで
きるようになっています。
マイクは図 33 に示すように、正面
パネルの右下のところにあります。
金属ケースに小さい穴の開いてい
るデバイスがマイクです。
サンプルプログラムでは、音に反
応して進行方向を変える動作をする
ダンスモードでマイク入力を利用し
ています。

- 42 -
7.1. マイク入力のハードウェア
7.1.1. マイク入力回路
7.1.2. HPF

ク値を抽出します。大きい音が入っ
てくると電圧が高くなり、小さい音
の時は電圧が低くなるという具合
に、音声の大きさに応じた電圧が得
られます。
これをマイコンでアナログ値とし
て取り込むことで、周囲の騒音レベ
ルを知ることができます。

図 34 は SmallBot のマイク入力
回路です。左端にあるのがマイクで
す。
マイクから出力された音声信号
は、HPF（ハイパスフィルタ）によ
って直流成分を含めた低い周波数を
カットしてから増幅し、さらにピー
ク検出回路によって音声波形のピー

りますので、

VOUT=

R
1
j
2πfc

+R

× VIN =

1

1

j・2πfCR

+1

× VIN

となります。周波数 f が大きくなる
と、 1
j・2πfCR

は 0 に近付きますので、

VOUT = (

1
0 + 1

) × VIN = VIN

となり、VOUT は VIN に近付きま
す。
一方、f が小さくなると 1
j・2πfCR

の

値が大きくなりますので、 1

1
j・2πfCR

+1

は 0

に近付き、VOUT = 0 × VIN = 0となり ます(※)

図 35 を見ると周波数が低い時は出
力レベルが小さくなり、周波数が高
くなると入力と同じレベル（1V）に
近付くことが確認できます。

マイクの音声信号出力は、コンデ
ンサと抵抗でできた HPF（ハイパス
フィルタ）をとおります。
1V の正弦波の周波数を変化させな
がら、出力レベルがどのように変わ
るのかをシミュレーションした結果
が図 35 です。
HPF 部分の回路を書き直すと図の
上にあるような、コンデンサと抵抗
の直列回路になっています。
入力する信号の周波数を f(Hz)、コ
ンデンサの容量を C（F）、抵抗の値
を R（Ω）として、入力電圧（VIN）
と出力電圧（VOUT）の関係を考え
てみます。コンデンサのインピーダ
ンス（交流に対する抵抗のようなも
のです）Z[Ω]は

Z =

1
j・2πfC

[Ω]（j は虚数単位）とな

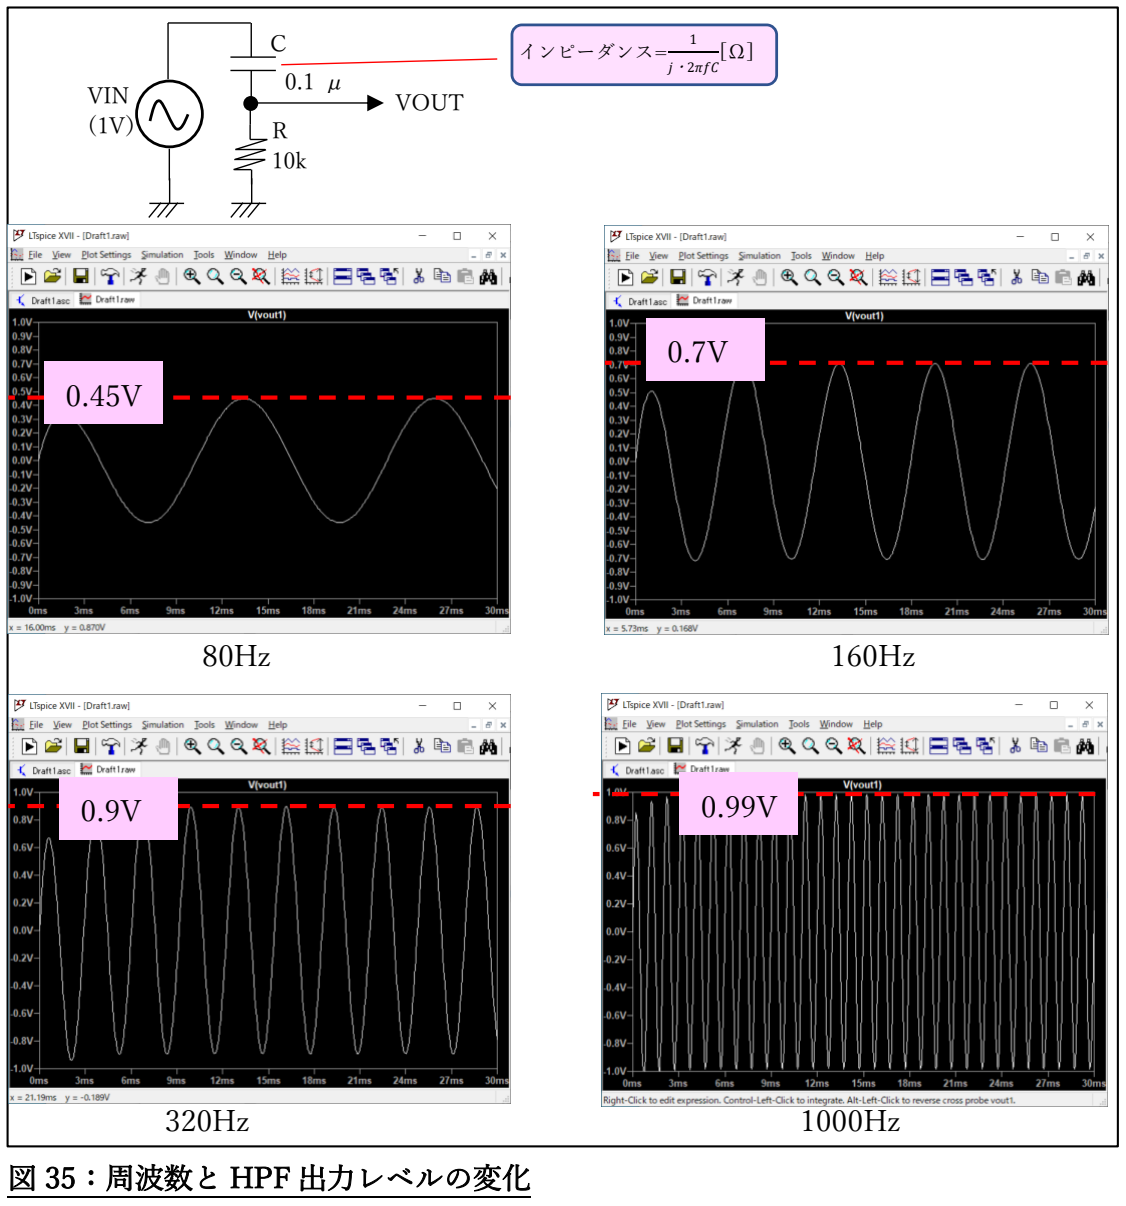
[picture p103: figure]
VOUT; VIN (1V）; インピーダンス=; j・2πfC; 図 35：周波数と HPF 出力レベルの変化

- 43 -

※HPF の周波数の低い領域の特性
f(周波数)が十分小さければ、“+1”の影
響が小さくなり、無視できるくらいに
なりますので、
VOUT≒

1
1
j・2πfCR

×VIN=j・2πfCR×VIN

とみなせます。f 以外を固定値にする
と、周波数と VOUT が比例します。
つまり、周波数が２倍になれば、
VOUT が２倍、¹
2

になれば、VOUT も

1
2
になります。

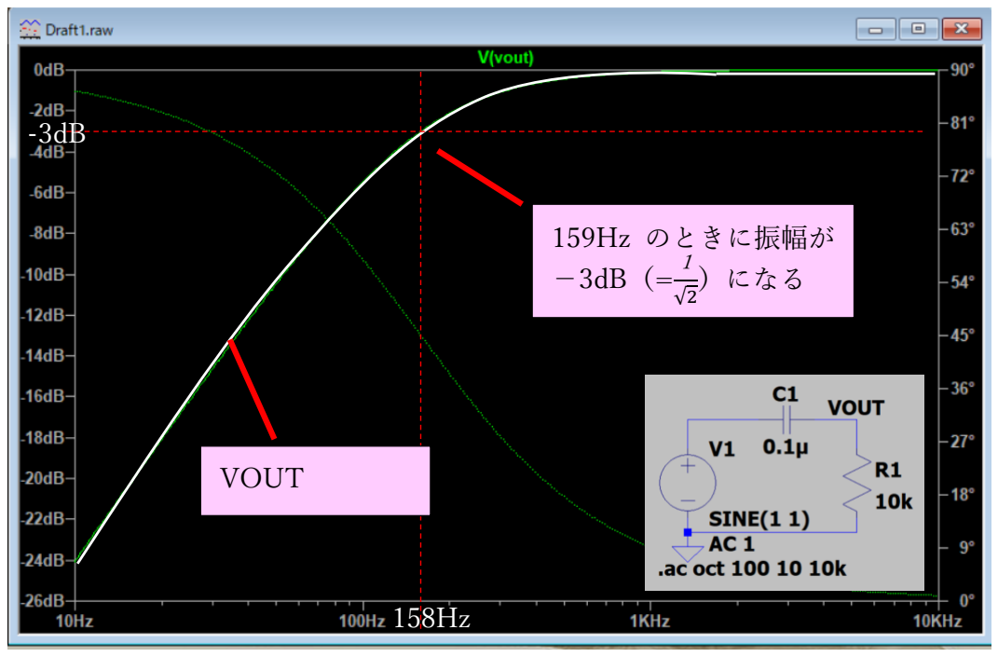
[picture p104: figure]
159Hz のときに振幅が; １ ξ2）になる; VOUT

- 44 -
7.1.3. HPF のカットオフ周波数

図 36：マイク入力の HPF の特性

となって位相が

π
4

(45 度)進み、出力
電圧は入力の ¹
ξ2

≒0.7 倍になります。

ここで C=0.1μF、R＝10kΩを代入
すれば、
f= 1
2πCR

≒159(Hz)
のときに電圧が 0.7 倍程度になり、こ
れよりも低い周波数では急激に電圧
が低下します。
この、電圧が ¹
2 になる周波数を「カ
ットオフ周波数」と呼んでいます。

1
2πfCR

=1 のとき、すなわち f= 1
2πCR
のときにどうなるか考えると

VOUT=

1
−j+1

×VIN

=

1+j
(1−j)(1+j)

×VIN=

1+j
(1−j)(1+j)

×VIN

=

1
2

(1 + j)×VIN
ここで、VIN=Vsinθ
という
VOUT=¹
2

(1 + j)×Vsinθ

ここで cosθ＝jsinθより
VOUT =

1
2

V(sinθ + cosθ)
=

1
2

V(ξ2sin (θ +

π
4

)
=

1
ξ2

V(sin (θ +

π
4

)

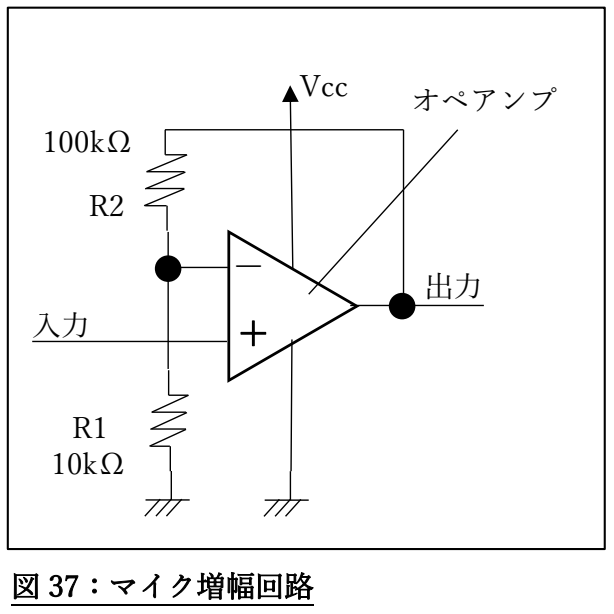
[picture p105: figure]
Vcc; オペアンプ; 図 37：マイク増幅回路

- 45 -
7.1.4. 増幅回路
7.1.5. オペアンプの基本動作

マイクの出力電圧は HPF を通った
あとの信号はレベルが小さく、その
ままではマイコンで扱うのに不便な
ため、増幅回路で信号レベルを大き
くします。図 37 は SmallBot のマイ
ク入力信号の増幅回路です。
中央にある三角形のものがオペア
ンプと呼ばれるものです。図のよう
に抵抗をつないだ回路は非反転増幅
回路と呼ばれるもので、増幅率は

R1+R2
R1

× VIN = VOUT
となります。図では R1=10ｋΩ、
R2=100kΩですので、増幅率は 11 倍
になります。

となります。
ただし、入出力とも電源電圧の範
囲内（この場合、0～Vcc）に制約さ
れます。
オペアンプのオープンループゲイ
ンは非常に大きな値ですので、+入力
と－入力の差が極めて小さい時を除
いて
・[+入力]>[-入力]ならば出力は Vcc
・[+入力]<[-入力]ならば 0V
となります。（実際には Vcc より少し
低く、0V より少し高い電圧が限界に
なります）

オペアンプは増幅回路や次で説明
するピーク検出回路でも使われてい
ますので、ここで基本的な動作を説
明しておきましょう。
図 38 はオペアンプのシンボルと基
本的な動作を示した物です。オペア
ンプは非常に大きな増幅率を持った
増幅回路です。＋入力とー入力の二
つの入力があり、この差分を増幅し
て出力電圧にします。
式で表すと、オペアンプの増幅率
（オープンループゲインと呼びま
す）をβとすると出力電圧は

出力電圧 = ((+入力電圧)－(－入力電圧)) × β

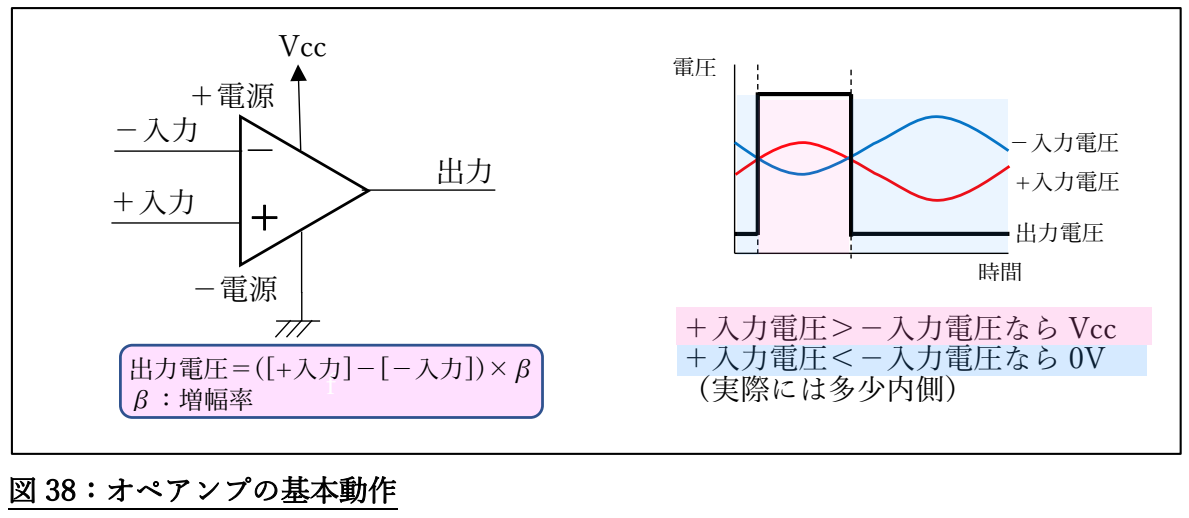
[picture p106: figure]
Vcc; ＋入力電圧＞－入力電圧なら Vcc ＋入力電圧＜－入力電圧なら 0V; （実際には多少内側）; 出力電圧＝([+入力]－[－入力])×β β：増幅率; －入力電圧; +入力電圧; 出力電圧; 図 38：オペアンプの基本動作

- 46 -
7.1.6. 増幅回路の動作

ここから

Y = (
R1 + R2
R1 + R2＋β・R1

)・β・X

= (
R1 + R2
R1 + R2
β

＋R1

)・X

βが十分に大きければ R1+R2
β

= 0と見な
せますので、

Y = (

R1 + R2
R1 )・X = (1 +

R2
R1)・X

となります。
図のように R1=10kΩ、R2=100kΩな
らば
Y=11・X
となって、増幅率 11 倍の増幅器とし
て動作することになります

図 39 はオペアンプを利用した増幅回
路（非反転増幅回路）の動作を示し
たものです。
オペアンプの＋入力電圧を X、－入力
電圧を Vm、出力電圧を Y、オープン
ループゲインをβ、とすると、

Vm = Y・

R1
R1 + R2
となります。またオペアンプ自身の
増幅動作から、

Y = β・(X − Vm)
となります（※）。

この二つの式を連立して Vm を消去
し、Y と X の関係の式にしてみまし
ょう。、

Y = β (X − Y・

R1
R1 + R2

)

Y・(1 + β・

R1
R1 + R2

) = β・X

Y・ (
R1 + R2 + β・R1
R1 + R2

) = β・X

※：式をお変形すると(X − Vm) =

Y
β

となります

ので、βが極めて大きい値ならば、
X − Vm = 0、つまりX = Vmと見なせます。

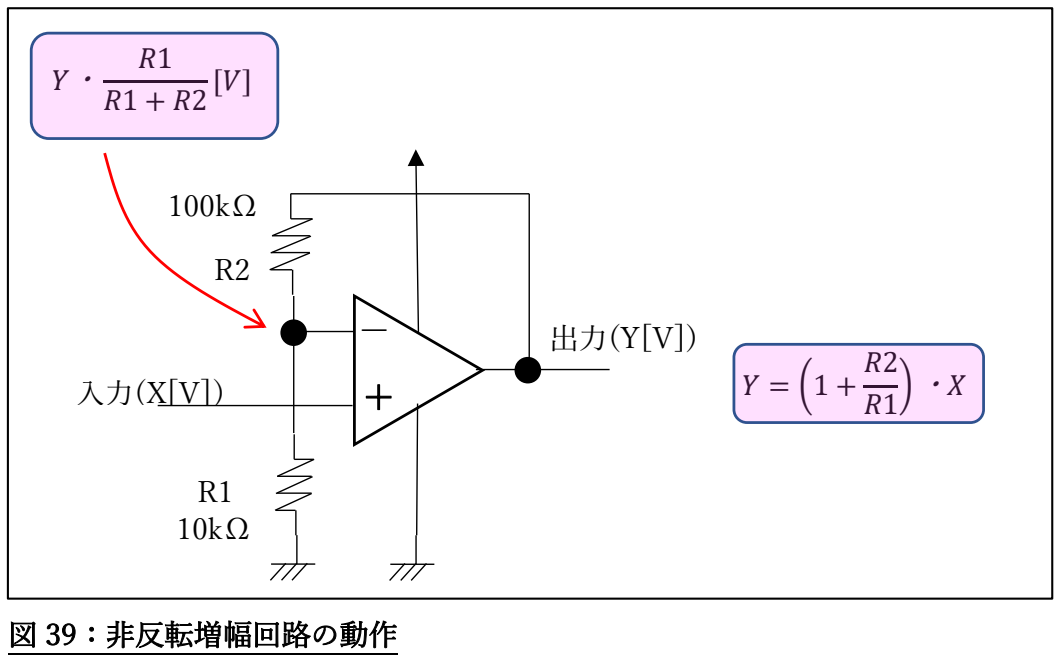
[picture p107: figure]
図 39：非反転増幅回路の動作

- 47 -
7.1.7. 非反転増幅回路の入出力関係

非反転増幅回路の出力電圧の計算
値がこの範囲外になった場合、図の
ようにリミットがかかったようにな
ります。
図 41 は入力信号に対してどのよう
な出力波形が得られるのかを図示し
たものです。グラフの下側のような
入力信号があった場合、図の右のよ
うに正負両方に振れた場合、＋側だ
けが残されて、－側に振れた分が切
り取られたような波形になります。
図には描いていませんが、＋側に
大きく振れたときは出力電圧が Vcc
近くでリミットがかかりますので、
頭が潰れたような波形になります。

非反転増幅回路の入出力の関係を
グラフとして表したのが図 40 です。
オペアンプの出力は電源電圧の範
囲内（この回路であれば 0～Vcc）ま
でしか振れません。また、実際には
オペアンプの最高出力電圧は Vcc よ
りも少し低くなります。オペアンプ
の種類や出力電流にもよりますが、1
～2V 以上になる場合もあります。
SmallBot で使われているオペアンプ
は出力電流が 50μA のときに 1.35V
程度となっています。
また、最低出力電圧も 0V までは落
ちず、1～2V 程度あることもありま
す。SmallBot に使われているオペア
ンプではこの値は 0.1V 程度となって
います。

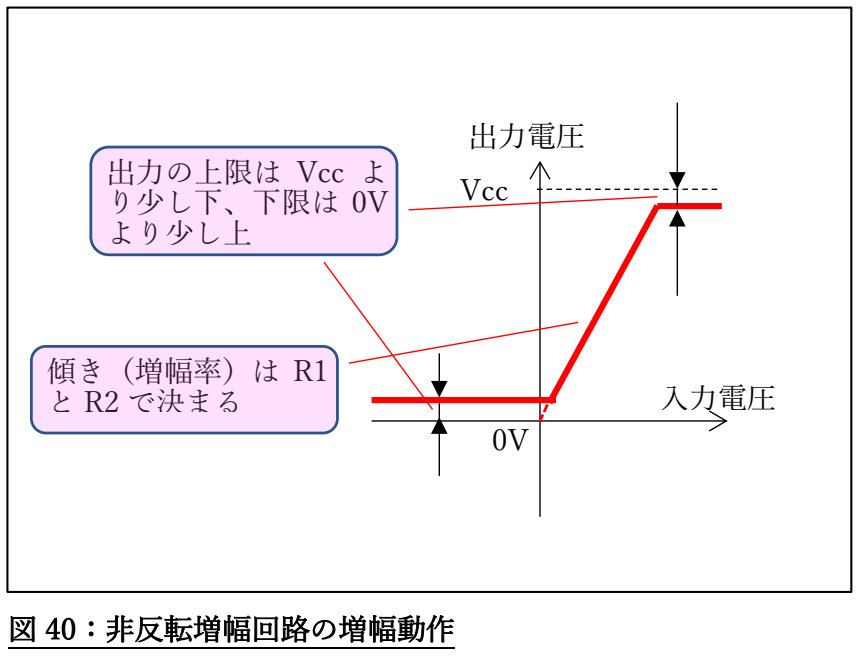
[picture p108: figure]
出力の上限は Vcc よ り少し下、下限は 0V より少し上; 入力電圧; 出力電圧; Vcc; 傾き（増幅率）は R1 と R2 で決まる; 図 40：非反転増幅回路の増幅動作
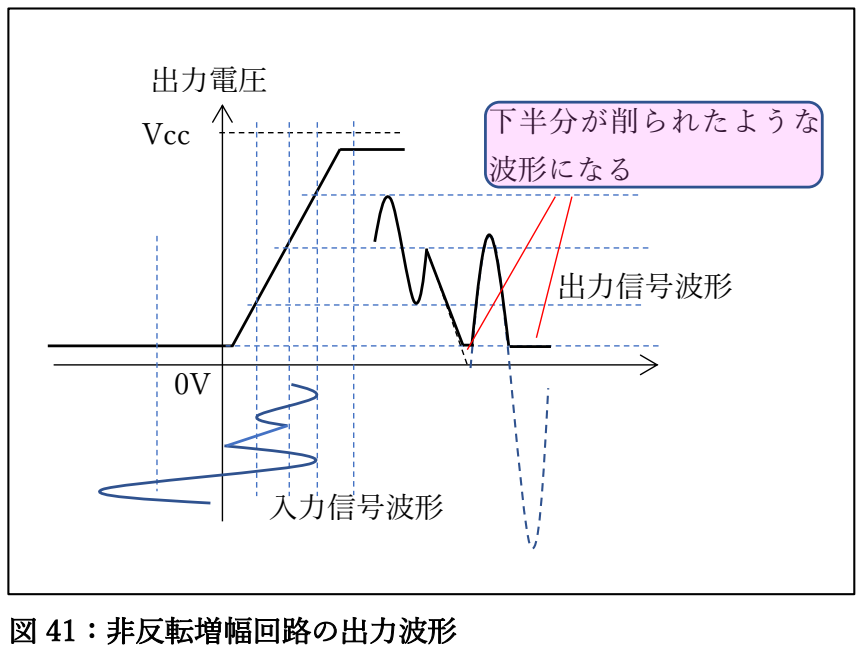
[picture p109: figure]
入力信号波形; 出力電圧; Vcc; 下半分が削られたような; 波形になる; 出力信号波形; 図 41：非反転増幅回路の出力波形

- 48 -

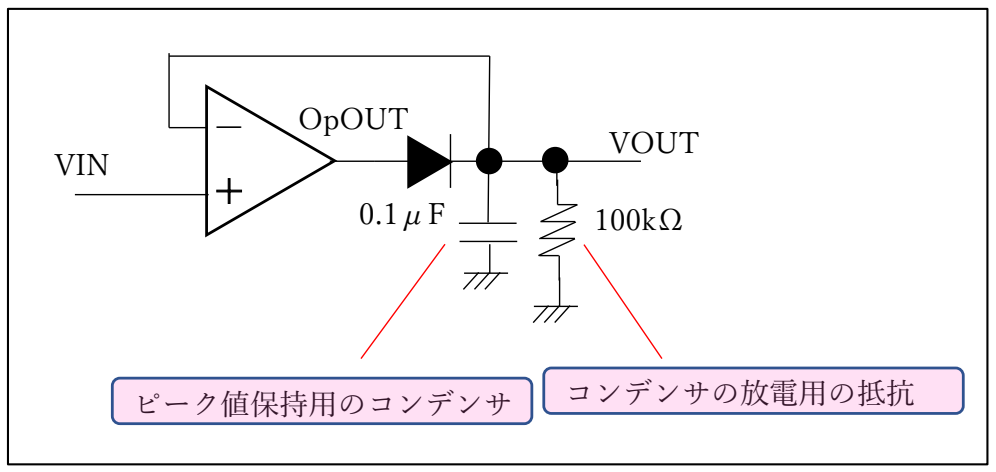
[picture p110: figure]
VIN; VOUT; OpOUT; ピーク値保持用のコンデンサ; コンデンサの放電用の抵抗

- 49 -
7.1.8. ピーク検出回路

図 42：ピーク検出回路

ついていています。これがピーク電
圧を保持するためのものです。ダイ
オードが付いているため、VOUT 電
圧よりも OpOUT の電圧くなると
き、すなわち VIN>VOUT の時だ
け、コンデンサに充電されることに
なります。
コンデンサと並列につながってい
る抵抗はコンデンサの放電用です。

オーディオのレベルメーターは、
上昇方向は素早く応答しますが、下
降方向はゆっくり下がっていきま
す。これと同じように抵抗を通して
少しずつ放電することで、コンデン
サの電圧が少しずつ下がるようにし
ているわけです。

図 42 はピーク検出回路です。増幅
された音声信号は音声の振動に合わ
せて激しく上下する波形ですので、
マイコンなどで音声の大きさを知る
のには不便です。
オーディオアンプなどに付いてい
るレベルメーターのように、音声の
波形に合わせた細かい上下動をせ
ず、音声の大きさに応じて動くよう
な信号を作るのがピーク検出回路で
す。
ピーク検出回路のオペアンプの出
力にはダイオードが付いていて、ダ
イオードの先が出力（VOUT）にな
っています。ダイオードは一方方向
にだけ電流が流れるというもので、
図であれば、左から右にだけ電流が
流れ、逆向きには流れません。
ダイオードの先にはコンデンサが

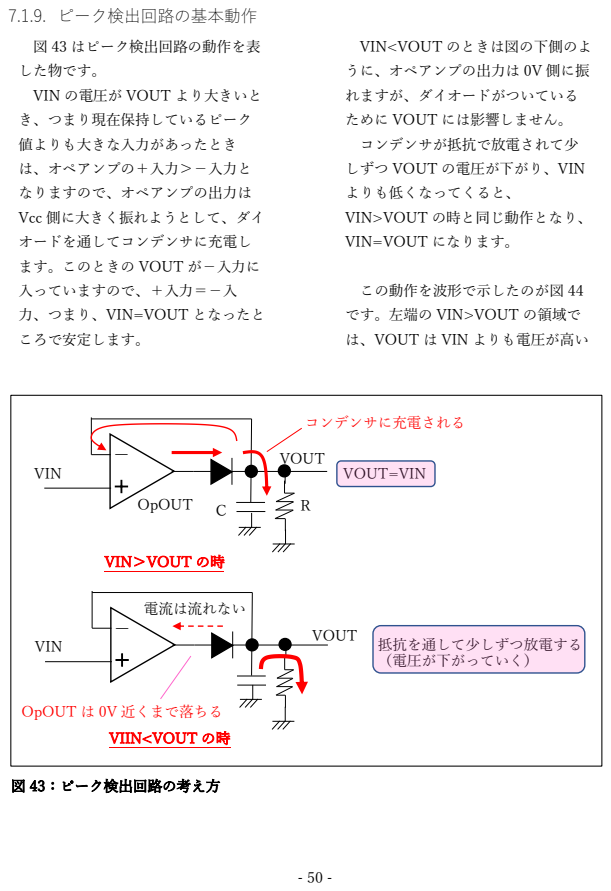
[picture p111: page 50]
7.1.9. ピーク検出回路の基本動作; VIN; VOUT; OpOUT; VOUT=VIN; OpOUT は 0V 近くまで落ちる; 電流は流れない; コンデンサに充電される; 抵抗を通して少しずつ放電する （電圧が下がっていく）; 図 43：ピーク検出回路の考え方

図 43 はピーク検出回路の動作を表
した物です。
VIN の電圧が VOUT より大きいと
き、つまり現在保持しているピーク
値よりも大きな入力があったとき
は、オペアンプの＋入力＞－入力と
なりますので、オペアンプの出力は
Vcc 側に大きく振れようとして、ダイ
オードを通してコンデンサに充電し
ます。このときの VOUT が－入力に
入っていますので、＋入力＝－入
力、つまり、VIN=VOUT となったと
ころで安定します。

VIN<VOUT のときは図の下側のよ
うに、オペアンプの出力は 0V 側に振
れますが、ダイオードがついている
ために VOUT には影響しません。
コンデンサが抵抗で放電されて少
しずつ VOUT の電圧が下がり、VIN
よりも低くなってくると、
VIN>VOUT の時と同じ動作となり、
VIN=VOUT になります。

この動作を波形で示したのが図 44
です。左端の VIN>VOUT の領域で
は、VOUT は VIN よりも電圧が高い

VIN＞VOUT の時

VIIN<VOUT の時

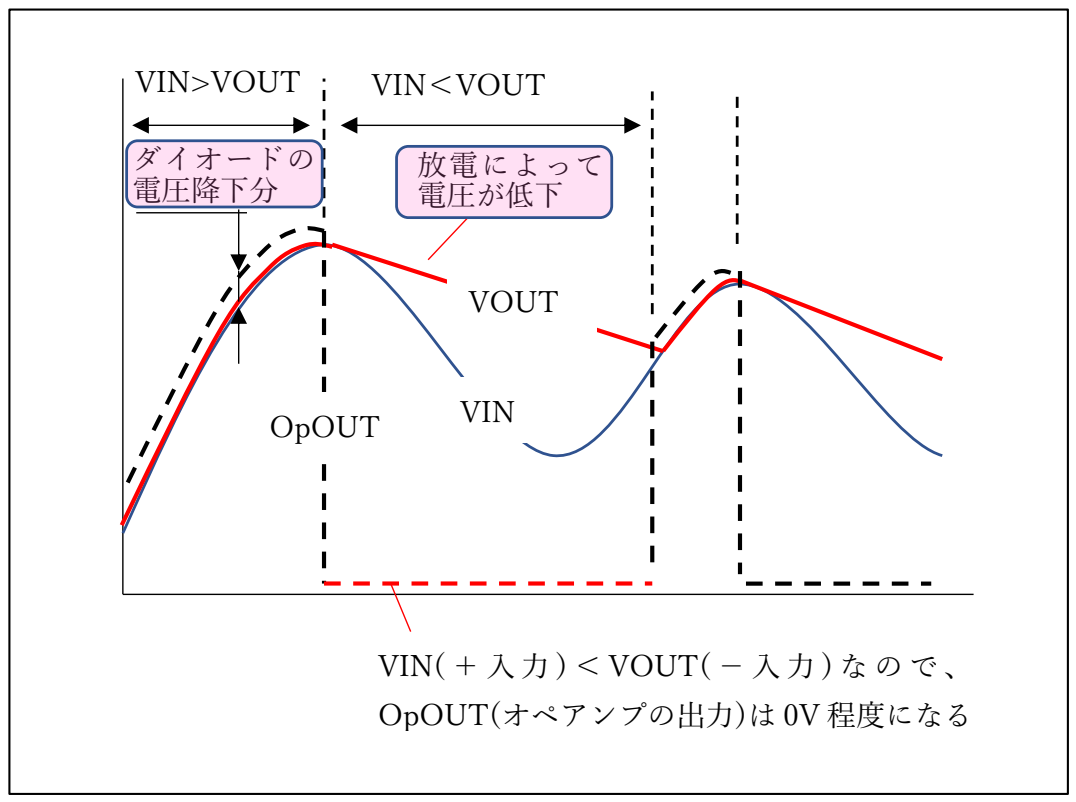
[picture p112: figure]
VIN>VOUT; VIN＜VOUT; VOUT; VIN OpOUT; 放電によって 電圧が低下; VIN( ＋ 入 力 ) ＜ VOUT( － 入 力 ) な の で 、; OpOUT(オペアンプの出力)は 0V 程度になる; ダイオードの 電圧降下分

- 51 -

図 44：ピーク検出回路の動作

電し、VOUT 電圧が下がっていきま
す。
VIN が再び VOUT 以上のレベルに
なれば、最初と同じように VIN を追
いかけるように VOUT が上昇しま
す。

ため、VOUT が VIN と等しくなるよ
うに OpOUT の出力が追従していき
ます(※)。
山のピークを越えて、VIN が減少
に転じると、今度は VIN<VOUT に
なりますので、OpOUT は 0V 近くま
で低下します。ダイオードが無けれ
ば VOUT 電圧も低下するのですが
が、ダイオードがあるため VOUT の
電圧は下がりません。
コンデンサに並列につながれた抵
抗を通してコンデンサが少しずつ放

※：VOUT=VIN の時、オペアンプの出力
（OpOUT の電圧）はダイオードの降下電圧分だ
け少し高めになります。

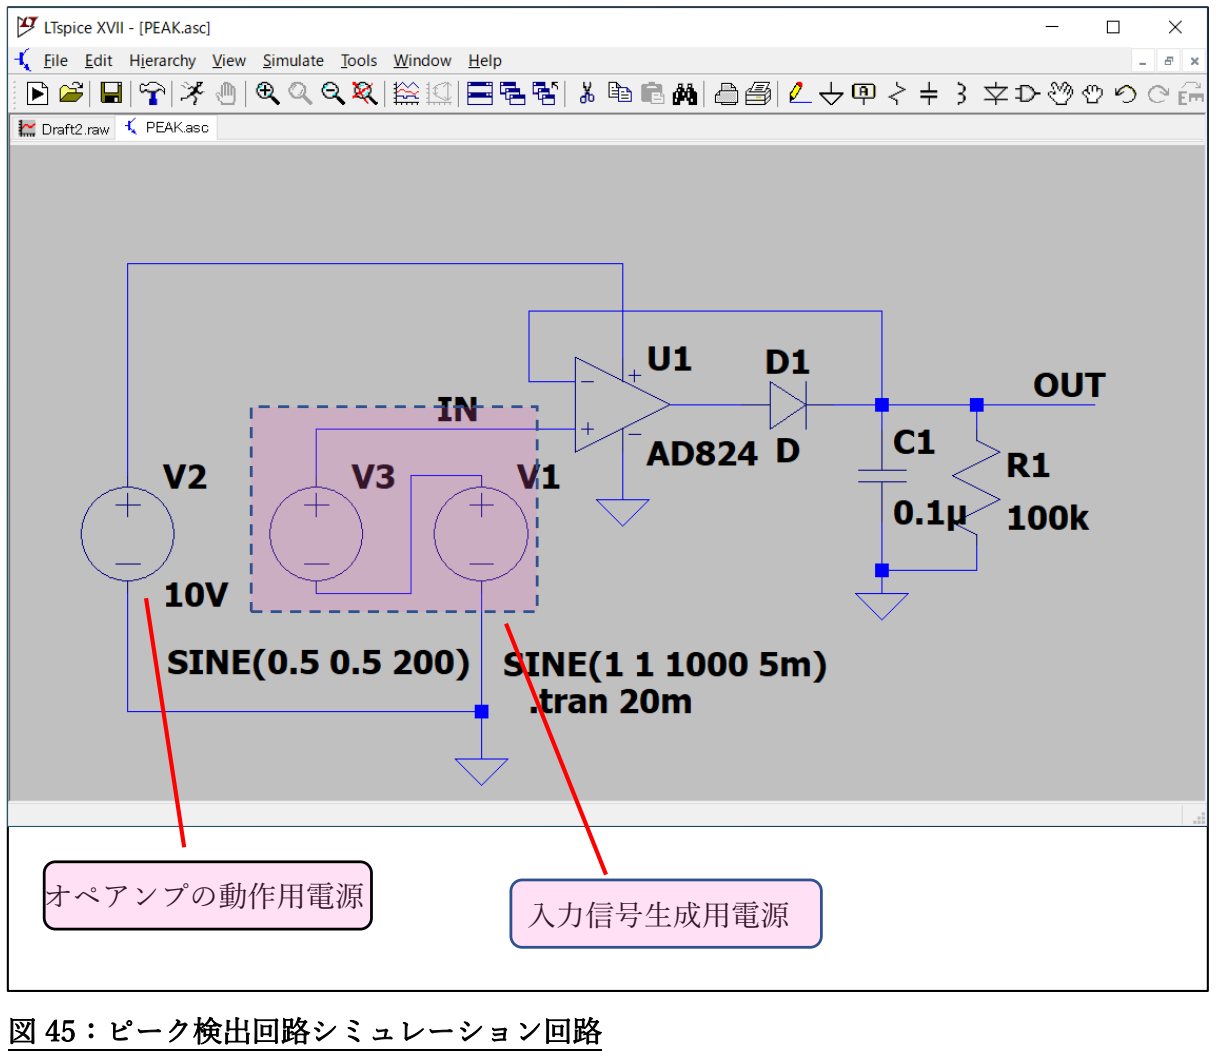
[picture p113: figure]
オペアンプの動作用電源; 入力信号生成用電源; 図 45：ピーク検出回路シミュレーション回路

- 52 -

7.1.10.ピーク検出回路のシミュレーション

この回路のシミュレーション結果
が図 46 です。

オーディオのレベルメータの動作
と同じように、上昇方向はすぐに追
従し、下降方向はゆっくり下がるよ
うに VOUT が変化していることがわ
かります。

図 45 はピーク検出回路のシミュレ
ーション回路です。
左端の電源はオペアンプ動作用の
電源で、中央の二つの電源は入力信
号の生成用です。正弦波を生成する
二つの電源を直列にすることで二つ
の音が混ざった「和音」のようなも
のにしてみました。

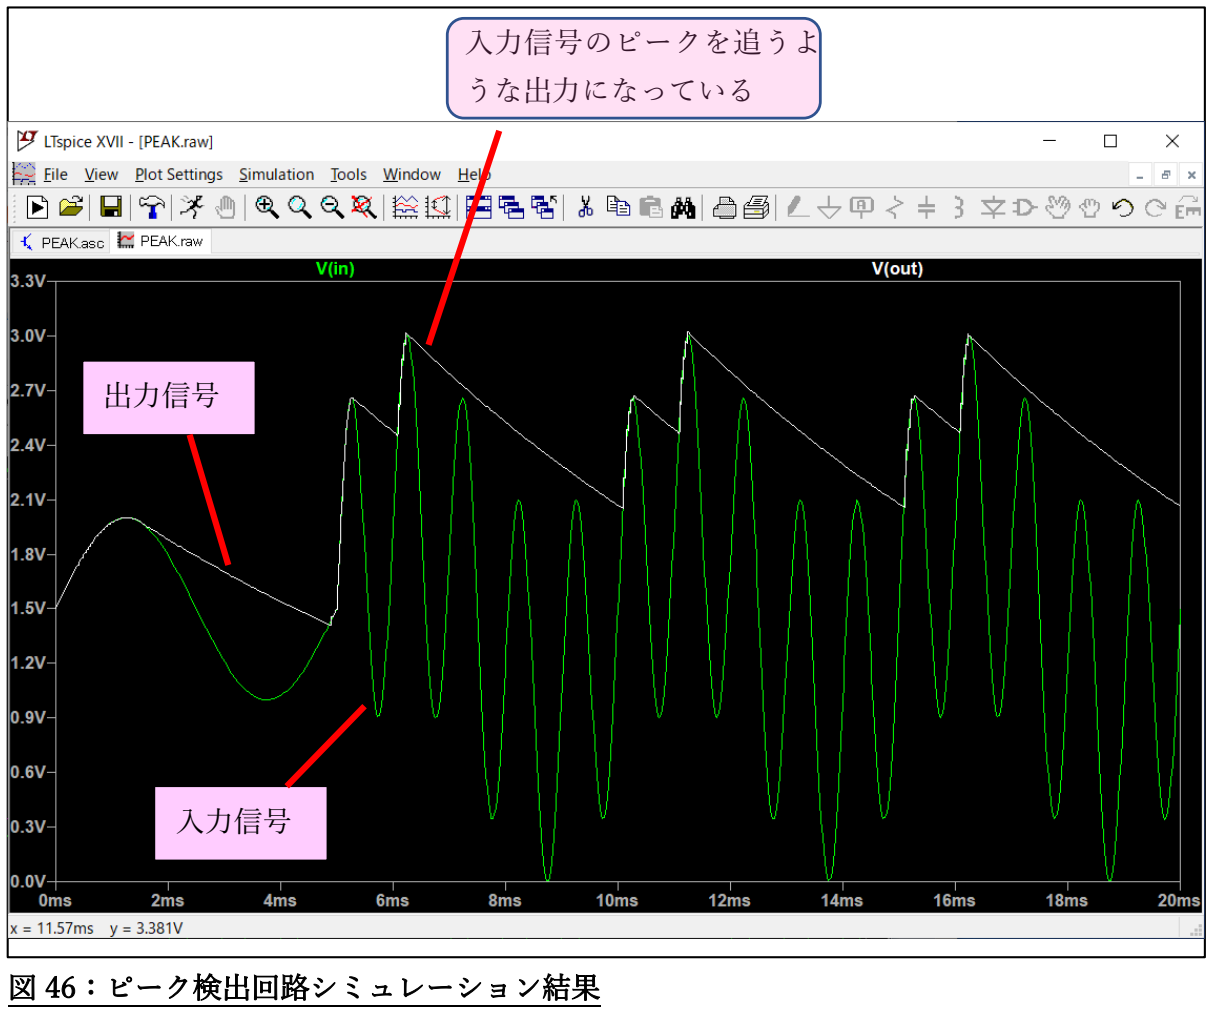
[picture p114: figure]
入力信号; 出力信号; 入力信号のピークを追うよ; うな出力になっている; 図 46：ピーク検出回路シミュレーション結果

- 53 -

7.1.11.マイク入力回路のシミュレーション

号のプラス側だけです。シミュレー
ション結果でも AMPOUT はプラス
側（0V 以上）の部分だけが増幅され
た波形になっています。
この増幅回路の出力（AMPOUT）
波形のピークが検出されて OUT 出力
になっています。

マイク入力回路全体のシミュレー
ションを行ってみました。シミュレ
ーションに使用した回路図が図 45、
シミュレーションした結果が図 46 で
す。
HPFOUT 出力は 0V を中心にして
正負両方に振れる信号になります。
増幅回路で増幅できるのは入力信

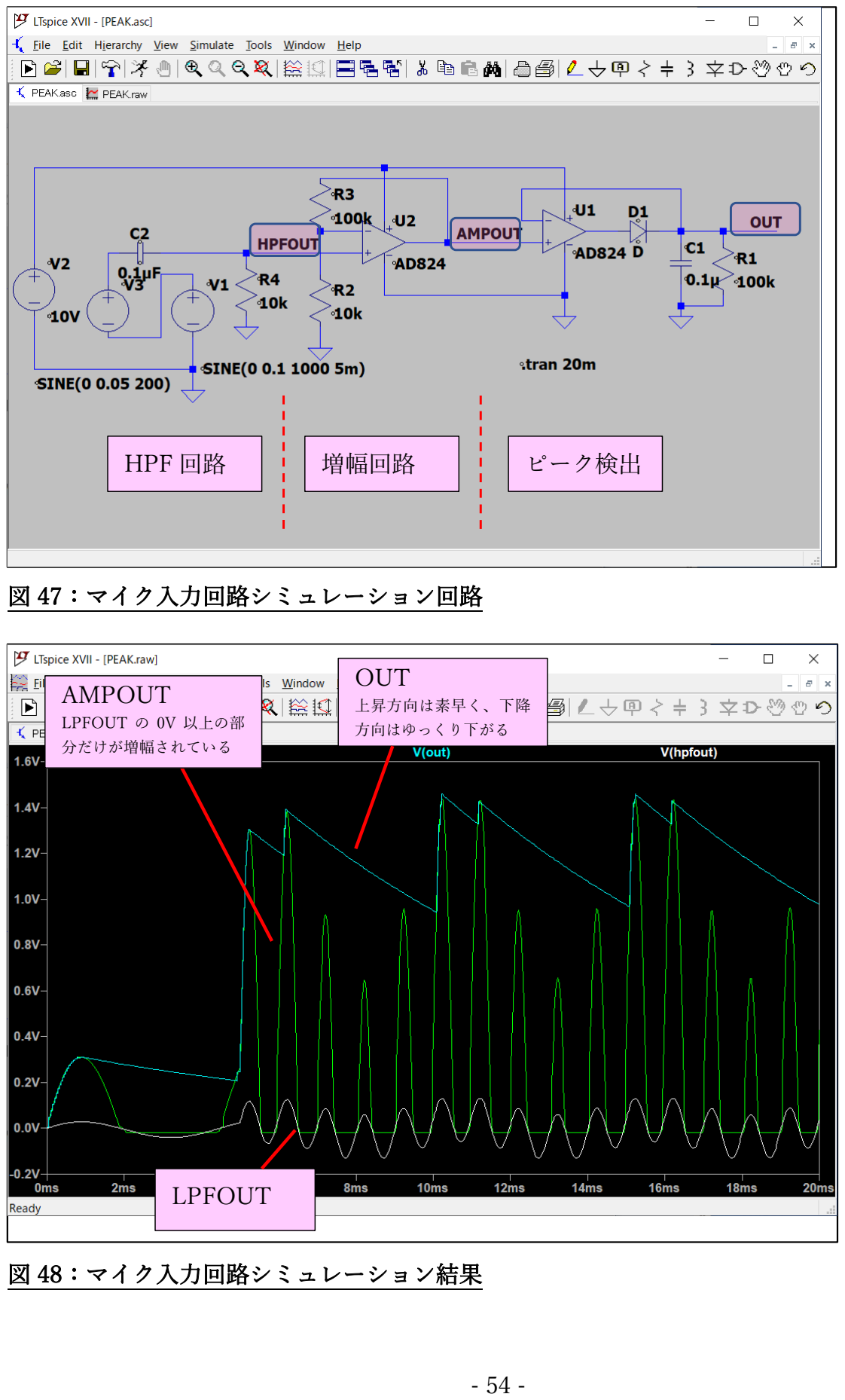
[picture p115: page 54]

- 54 -

LPFOUT

AMPOUT

LPFOUT の 0V 以上の部
分だけが増幅されている

OUT

上昇方向は素早く、下降
方向はゆっくり下がる
HPF 回路 | 増幅回路 | ピーク検出

図 48：マイク入力回路シミュレーション結果

図 47：マイク入力回路シミュレーション回路

- 55 -
7.2. マイク入力のソフトウェア

analogRead()関数を使用してアナロ
グ値として読み込みます。電圧値は 0
～1023 の数値で返されます。
このようにして得られた音声レベ
ル値がスライダで設定した値を超え
ると右回転するようにしていまま
す。

図 49 はサンプルプログラムからマ
イク入力による動作（大きな音があ
ると方向転換する）処理の一部を抜
き出してきた物です。
マイク入力は HPF や増幅回路、ピー
ク検出回路を通った後、A4 ピン
（Arduino-IDE 上でのピン番号）に
入力されています。この電圧を

unsigned int insound;
unsigned int SoundLevel = 0;
insound = analogRead(A4); | // 音声レベルを取得
if (SoundLevel < insound) | // 音が大きかったら
SoundLevel = insound; | // レベル更新

・・・
sliderValue = analogRead(A3); | // スライダーの読み取り
if(map(sliderValue, 0, 1023, 10, 500) < SoundLevel) // 音声レベルの方が大きい
RStateSOUND = RBT_SOUND_ROT; | // 右回転
else | RStateSOUND = RBT_SOUND_FORWARD; // 小さかったら直進
SoundLevel = 0; // 音声レベルをクリア
・・・

図 49：サンプルプログラムの音声入力処理

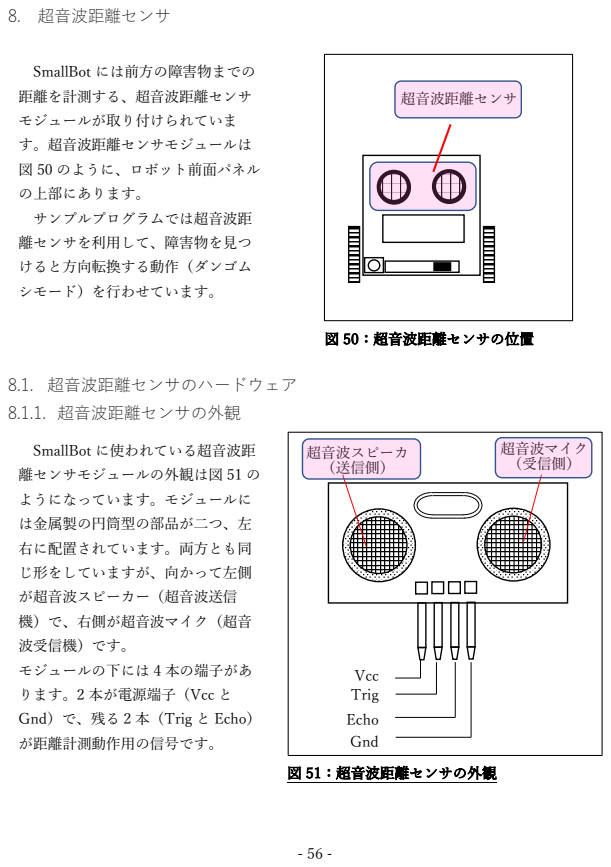
[picture p116: page 56]
8. 超音波距離センサ; 8.1. 超音波距離センサのハードウェア; 8.1.1. 超音波距離センサの外観; 超音波スピーカ （送信側）; 超音波マイク （受信側）; Vcc Trig; Echo; Gnd; 図 51：超音波距離センサの外観; SmallBot には前方の障害物までの; 距離を計測する、超音波距離センサ; モジュールが取り付けられていま; す。超音波距離センサモジュールは; 図 50 のように、ロボット前面パネル; の上部にあります。; サンプルプログラムでは超音波距; 離センサを利用して、障害物を見つ; けると方向転換する動作（ダンゴム; シモード）を行わせています。; 超音波距離センサ; 図 50：超音波距離センサの位置

SmallBot に使われている超音波距
離センサモジュールの外観は図 51 の
ようになっています。モジュールに
は金属製の円筒型の部品が二つ、左
右に配置されています。両方とも同
じ形をしていますが、向かって左側
が超音波スピーカー（超音波送信
機）で、右側が超音波マイク（超音
波受信機）です。
モジュールの下には 4 本の端子があ
ります。2 本が電源端子（Vcc と
Gnd）で、残る 2 本（Trig と Echo）
が距離計測動作用の信号です。

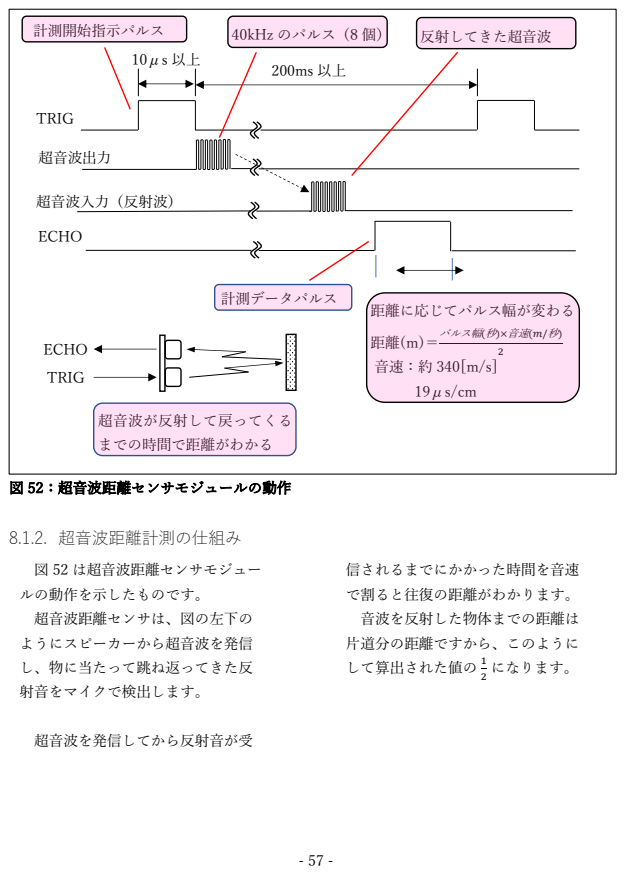
[picture p117: page 57]
図 52：超音波距離センサモジュールの動作; 8.1.2. 超音波距離計測の仕組み; TRIG; ECHO; 超音波出力; 超音波入力（反射波）; 計測開始指示パルス; 超音波が反射して戻ってくる; までの時間で距離がわかる; 距離に応じてパルス幅が変わる; パルス幅(秒)×音速(m/秒); 計測データパルス; 40kHz のパルス（8 個）; 反射してきた超音波; 信されるまでにかかった時間を音速; で割ると往復の距離がわかります。; 音波を反射した物体までの距離は; 片道分の距離ですから、このように して算出された値の ¹ 2 になります。; 図 52 は超音波距離センサモジュー; ルの動作を示したものです。; 超音波距離センサは、図の左下の; ようにスピーカーから超音波を発信; し、物に当たって跳ね返ってきた反; 射音をマイクで検出します。; 超音波を発信してから反射音が受

- 58 -
8.1.3. 超音波距離計測動作

します。
反射音は物体までの間を往復して
いますので、2 倍の距離を伝わってき
ます。反射音が到達するまでの時間
をｔ(秒)、音速を s(m/秒)とすれば物
体までの距離 L[m]は

L[m] =

t・s
2
として算出できます。音速は温度
や気圧、大気の組成などによっても
変わってきますが、通常は 340m/秒
（≒29μs/cm）として計算すれば良
いでしょう。
TRIG パルスの間隔は 200ms 以上
必要となっていますので、1 秒間に
4，5 回程度の計測が可能です。
超音波計測モジュールで計測可能
な距離は 2cm から 4.5m となってい
ます。この範囲外になるようなごく
近い距離や遠い距離は計測できませ
ん。

図の上側は距離計測動作の信号波
形を示したものです。
(1）センサの TRIG 入力に 10μs 以
上の幅の HIGH レベルパルスを
与えるます。モジュールが計測
動作を開始します。
(2）超音波マイクから 40KHz の超音
波が超音波スピーカからごく短
い時間（8 サイクル：200μs）出
力されます。
(3）超音波が物体に当たって反射し
た反射音を超音波マイクで受け
取ります。
(4）反射音が到達すると、超音波を
発信してから反射音が受け取ら
れるまでの時間分だけ、ECHO
信号が HIGH レベルになりま
す。

反射音が到達するまでの時間は反
射する物体までの距離によって変化

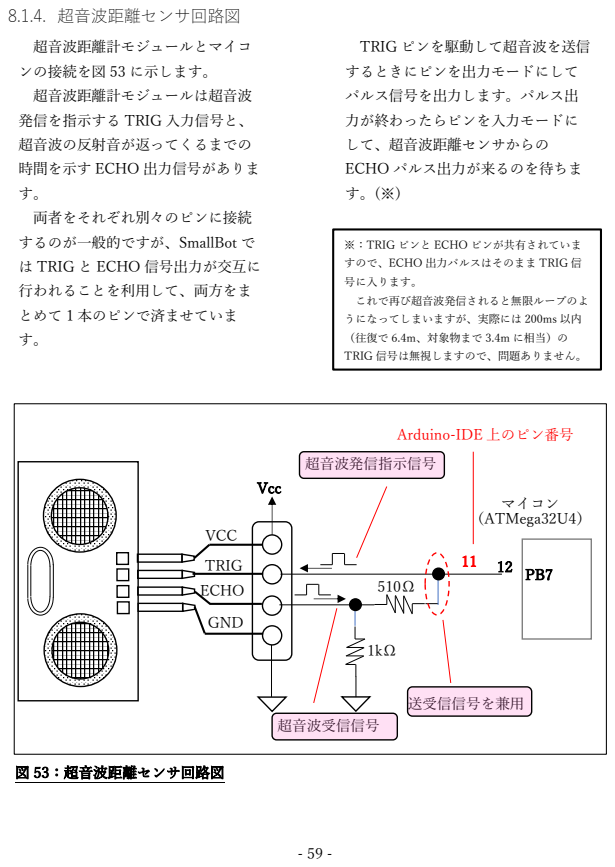
[picture p118: page 59]
8.1.4. 超音波距離センサ回路図; Vcc; VCC; TRIG; ECHO; GND; 超音波発信指示信号; 超音波受信信号; マイコン （ATMega32U4）; 送受信信号を兼用; TRIG ピンを駆動して超音波を送信; するときにピンを出力モードにして; パルス信号を出力します。パルス出; 力が終わったらピンを入力モードに; して、超音波距離センサからの; ECHO パルス出力が来るのを待ちま; 図 53：超音波距離センサ回路図

超音波距離計モジュールとマイコ
ンの接続を図 53 に示します。
超音波距離計モジュールは超音波
発信を指示する TRIG 入力信号と、
超音波の反射音が返ってくるまでの
時間を示す ECHO 出力信号がありま
両者をそれぞれ別々のピンに接続
するのが一般的ですが、SmallBot で
は TRIG と ECHO 信号出力が交互に
行われることを利用して、両方をま
とめて 1 本のピンで済ませていま

※：TRIG ピンと ECHO ピンが共有されていま
すので、ECHO 出力パルスはそのまま TRIG 信
号に入ります。
これで再び超音波発信されると無限ループのよ
うになってしまいますが、実際には 200ms 以内
（往復で 6.4m、対象物まで 3.4m に相当）の
TRIG 信号は無視しますので、問題ありません。

Arduino-IDE 上のピン番号

- 60 -
8.2. 超音波距離センサソフトウェア

(1）ピンを出力モードにする
(2）LOW 出力（0 書込み）
(3）HIGH 出力（1 書き込み）
(4）5μs 待つ
(5）LOW を出力
として TRIG 信号を出力します。

図 54 はサンプルプログラムの超音
波距離計測処理部分を抜き出してき
たものです。
distance()関数を呼ぶと、戻り値で
対象物までの距離を cm 単位で返しま
す。この関数の中では、
#define PING_PIN | 11 // 超音波測距センサは 11 番ピン

long distance(void)
{
long duration, cm;
pinMode(PING_PIN, OUTPUT); | // ピンを出力モードにする
digitalWrite(PING_PIN, LOW); | // 出力をいったん LOW レベルにする
delayMicroseconds(2); | // 少し待つ
digitalWrite(PING_PIN, HIGH); | // 出力を HIGH レベルにする
delayMicroseconds(5); | // 5μs 待つ（5μsHIGH になる）
digitalWrite(PING_PIN, LOW); | // 出力を LOW レベルに戻す
pinMode(PING_PIN, INPUT); | // ピンを入力モードい戻す
duration = pulseIn(PING_PIN, HIGH); | // HIGH レベルパルスの幅を計測
return( microsecondsToCentimeters(duration)); // cm 単位に変換
}
// μs から cm に変換
// 音速を 340m/s とすると、1cm あたり約 29μs なので
// 29 で割ると往復距離になる。片道分（対象物までの距離）はこの半分 long microsecondsToCentimeters(long microseconds)
{
return microseconds / 29 / 2; // 往復距離なので、対象物までの距離は 1/2 }

TRIG 出力

ECHO 入力

図 54：サンプルプログラムの音波距離計測部分

- 61 -

で、microsecondsToCentimeters()関 数で距離に変換します。

音速を 340m/秒とすると(※)1cm
あたりの時間は、

1
340 × 100 × 10⁶ ≒ 29[μs]
となりますので、プログラム中で
は計測された時間を 29 で割って cm
単位の距離に変換し、更に 2 で割る
ことで片道分の距離（対象物までの
距離）を算出しています。

TRIG 信号出力が終わったらピンを
入力モードに戻して、Arduino のパル
ス入力ライブラリ関数である
pulseIn()関数で HIGH レベルのパル
スの幅を計測します。
この関数では入力が HIGH レベル
のを待ち、LOW レベルに戻るまでの

時間（パルス幅）をμs（10⁻⁶秒）単
位で返します。1 秒間待ってもパルス
が来なければ 0 が返ります。
計測された値はμs 単位の値ですの

※：温度と音速の関係
大気中で 1 気圧のとき、気温を T℃とすると、気
温と音速の関係は 331.5 + 0.61T[m/秒]という関 係がありますので、気温 15℃の時にほぼ 340m/ 秒になります。

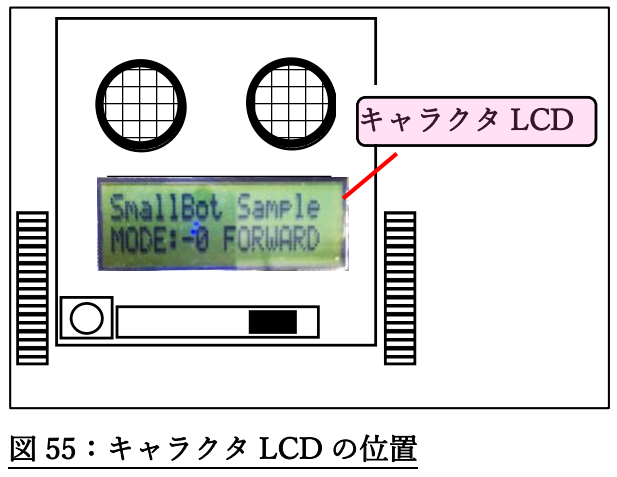
[picture p119: figure]
キャラクタ LCD; 図 55：キャラクタ LCD の位置
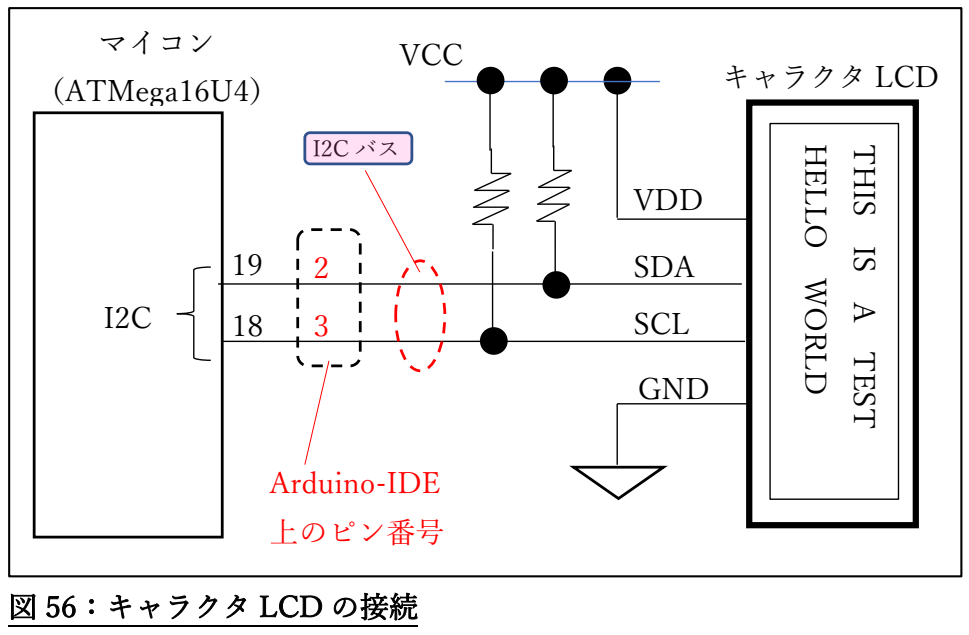
[picture p120: figure]
VDD; THIS IS; A TEST; HELLO; SDA; WORLD; SCL; GND; キャラクタ LCD; マイコン; （ATMega16U4）; Arduino-IDE; 上のピン番号; VCC; 図 56：キャラクタ LCD の接続

- 62 -
9. キャラクタ LCD
9.1. キャラクタ LCD のハードウェア

シリアル通信でコマンドを送って動
かします。
SmallBot では Arduino-IDE のピン 番号で 2 番ピンと 3 番ピンが I2C バス
用になっています。

SmallBot のキャラクタ LCD の接
続は図 56 のようになっています。
SmallBot のキャラクタ LCD は I2C
バスという 2 線式のシリアル通信イ
ンターフェースで接続されており、

SmallBot の正面中央部にはキャラ
クタ LCD（液晶ディスプレイ）パネ
ルが付いています。
キャラクタ LCD パネルは英数字や
カタカナなどの表示を行うものです
（グラフィック表示は行えません）。
表示可能な行数は 2 行で、1 行の文
字数は 16 文字です。

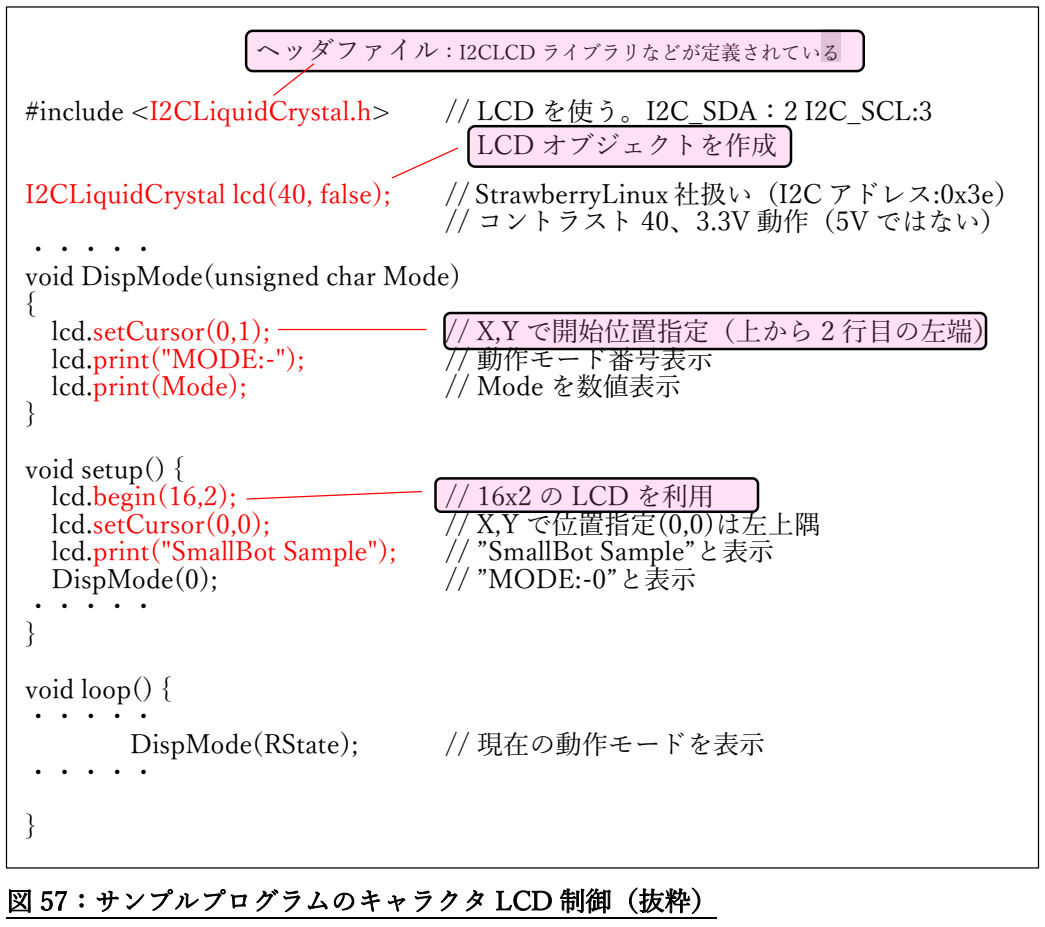
[picture p121: figure]
#include <I2CLiquidCrystal.h>; // LCD を使う。I2C_SDA：2 I2C_SCL:3; I2CLiquidCrystal lcd(40, false);; // StrawberryLinux 社扱い（I2C アドレス:0x3e）; // コントラスト 40、3.3V 動作（5V ではない）; ・・・・・ void DispMode(unsigned char Mode) {; lcd.setCursor(0,1);; // X,Y で開始位置指定（上から 2 行目の左端）; lcd.print("MODE:-");; // 動作モード番号表示; lcd.print(Mode);; // Mode を数値表示; void setup() {; lcd.begin(16,2);; // 16x2 の LCD を利用; lcd.setCursor(0,0);; // X,Y で位置指定(0,0)は左上隅; lcd.print("SmallBot Sample");; // ”SmallBot Sample”と表示; DispMode(0);; // ”MODE:-0”と表示; void loop() { ・・・・・; DispMode(RState);; // 現在の動作モードを表示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

- 63 -
9.2. キャラクタ LCD のソフトウェア

○ヘッダファイルのインクルード
I2C 接続のキャラクタ LCD 用のラ
イブラリの関数定義などはヘッダフ
ァイル、I2CliquieCrystal.h にまとめ られています。プログラムの先頭部
分で
#include <I2CLiquidCrystal.h> としてヘッダファイルをインクルー

ド（取り込み）します。

SmallBot のキャラクタ LCD は I2C
バスで接続されています。Arduino-IDE には I2C バス接続の LCD を扱え
るようにしたライブラリが用意され
ていますので、サンプルプログラム
でもこれを利用しています。
図 57 はサンプルプログラム中でキ
ャラクタ LCD の初期化や表示処理部
分を抜粋したものです。

- 64 -

行います。
第一引数（この例では 16）が LCD
パネルの 1 行の文字数、第二引数
（この例では 2）が行数になっていま
す。（※）

○カーソル位置の指定
LCD に文字を表示するときの表示
開始位置（カーソル位置）を指定す
るのが、setCursor()関数です。
引数は二つで表示開始位置の X 座
標（パネルの横方向のカラム位置）、
Y 方向（パネルの縦方向の行位置）を
指定します。
図 58 は setCursor()関数の引数と
LCD パネル上の表示開始位置を示し
たものです。
X 方向は左端が 0、Y 方向は最上行
が 0 です。たとえば
lcd.setCursor(0,1);
とすれば、X 方向は 0、Y 方向は 1 で
すので、上から 2 行目（最上位が 0
行目なので、2 行目は 1 です）の左端
を指定することになります。

○LCD オブジェクトの作成
LCD を使用するため次のような記
述で、LCD クラスから LCD オブジ
ェクトを作成します。
I2CLiquidCrystal lcd(40, false); I2CliquidCrystal というのがクラス
名（変数の型のようなもの）で、次
の lcd というのがオブジェクトの名称
（変数の名前のようなもの）です。
引数が二つありますが、第一引数
（この例では 40）が LCD のコント
ラスト、第二引数（この例では
false）が LCD が+5V 動作なのか否か
（3.3V 動作なのか）を指定するもの
です。SmallBot では LCD を 3.3V で 動作させていますので、第二引数は
false にします。

○キャラクタ LCD の初期化
LCD オブジェクトを作成した段階
では単にライブラリの基本的な初期
化が行われただけで、ハードウェア
（I2C バスや LCD パネル）の初期化
は行われていません。
これらの初期化を行うライブラリ
関数が begin()です。
lcd.begin(16,2);
のように、lcd オブジェクトの
begin()関数（メソッド）を呼び出し
て I2C バスや LCD パネルの初期化を

※実は begin()は 3 つの引数を取り、三番目の引 数で 1 文字のドット数を指定できるようになって
います。引数を省略したときは 1 文字は 5×8 ド ット（横 5 ドット、縦 8 ドット）の大きさという 扱いになります。
SmallBot に使われているキャラクタ LCD も 5 ×8 ドットですので第三引数を省略しています。

- 65 -

・print(“文字列”)
文字列を表示します
例：print(“Hello”); ⇒Hello と表示

いずれの場合も print()ならば最後
に表示した文字の位置、println()なら
ば一行下の左端にカーソルが移動し
ます。（単に println()とすると、何も
表示せず、カーソル位置が一つ下の
行の左端に移動します）

カーソル位置を戻したり指定した
位置から表示したいときは print()や
println()を行う前に setCursor()でカ ーソル位置を指定します。

○文字表示
キャラクタ LCD ライブラリで文字
や数値の表示を行う関数が print()と
println()関数です。println()関数は表 示を行った後に改行する（表示した
後にカーソル位置が一つ下の行の左
端自動的に移動する）点が異なる他
は print()と同じです。
print()関数は大きく分けて次の 4
つに分けられます。

・print(整数, [DEC/HEX])
引数の値を表示します。第二引数
で表示を 10 進表示（DEC）にするの
か、16 進表示（HEX）にするのかを
指定します。省略すると 10 進になり
ます。
例：print(32); ⇒ 32 と表示
print(32,16); ⇒ 20 と表示

・print(浮動小数点値, 桁数)
引数の値を少数で表示します。第
二引数は小数点以下の桁数を指定し
ます。省略すると 2 になります。
例：print(1.234,2);⇒1.23 と表示 ・print(‘文字’)
引数の 1 文字を表示します。
例：print(‘Z’); ⇒Z と表示
setCursor(0,0) | setCursor(15,0)
setCursor(0,1) | setCursor(15,1)

図 58：setCursor()の引数と表示開始位置

- 66 -
Version | 日付 | 概要
1．0 | 2022/08/08 | 初版発行
