neecrobot/smallbot/(commit log)

2023-10-13 プログラムV00（最初のプログラム）
2023-10-15 第一回テキスト追加
2023-10-15 第一回テキスト
2023-10-19 第一回テキスト更新
2023-10-19 #defineを使ったモーター駆動サンプル
2023-10-20 if文利用サンプル
2023-10-22 ライントレースサンプル
2023-10-22 第二回テキスト
2023-10-23 第２回テキスト
2023-10-24 右２回左１回サンプル
2023-10-24 右２左１の４回繰り返し
2023-10-26 マイクで回転サンプル
2023-10-26 超音波距離センサで回転サンプル
2023-10-27 第３回テキスト
2023-10-31 第３回テキスト更新
2025-11-03 Add files via upload
    テキスト更新
2025-12-02 超音波距離センサで回転サンプル
    タイムアウト処理追加
